jop-devel/jop/README

JOP stands for Java Optimized Processor. JOP is a Java processor
intended for embedded real-time systems.
