jop-devel/jop/java/target/src/bench/scd_micro/README.txt

The code here is taken from the CDx - RTSJ benchmark.
http://adam.lille.inria.fr/soleil/rcd/Download/

Basically, it is the code periodically invoked in the real-time thread to perform collision detection,
see Main.java
