jop-devel/jop/doc/book/appendix/boards.tex

\index{schematics}

This chapter provides the schematics of the Cycore FPGA boards and
several I/O extension boards.

\newpage
\section{Cyclone FPGA Board} \label{appx:cycore}

\begin{figure}[h!]
    \centering
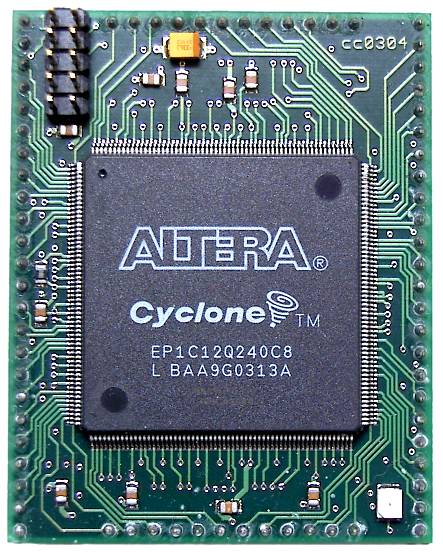
[picture p1: doc/book/appendix/cycore_top.jpg]
    
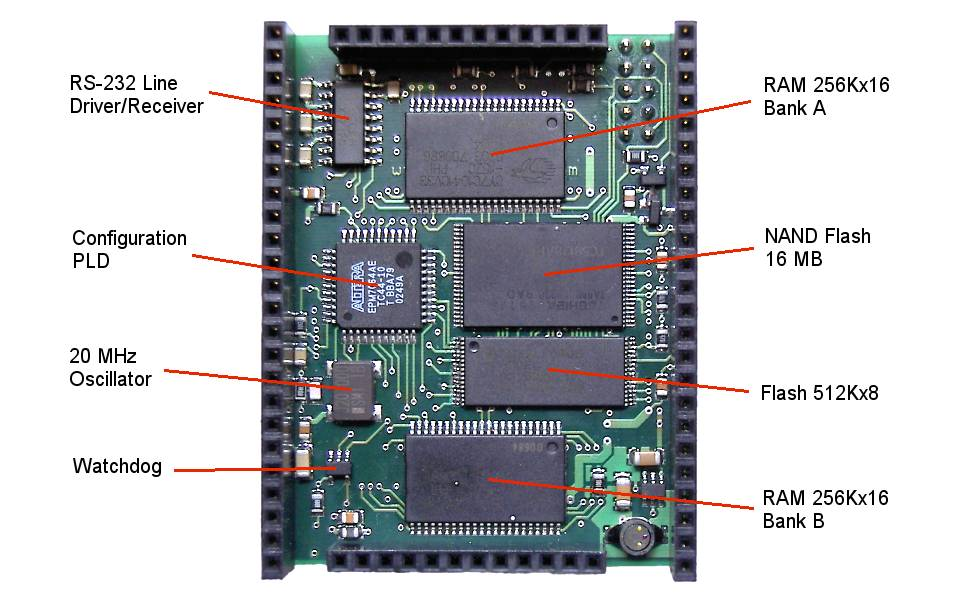
[picture p2: doc/book/appendix/cycore_bottom.jpg]
    
    \caption{Top and bottom side of the Cyclone FPGA board}
\end{figure}

\begin{figure}
    \centering
    
    \caption{Schematic of the Cyclone FPGA board, page 1}
\end{figure}
\begin{figure}
    \centering
    
    \caption{Schematic of the Cyclone FPGA board, page 2}
\end{figure}
\begin{figure}
    \centering
    
    \caption{Schematic of the Cyclone FPGA board, page 3}
\end{figure}

\newpage
\section{Baseio Board} \label{appx:baseio}
\index{Baseio}

\begin{figure}[h]
    \centering
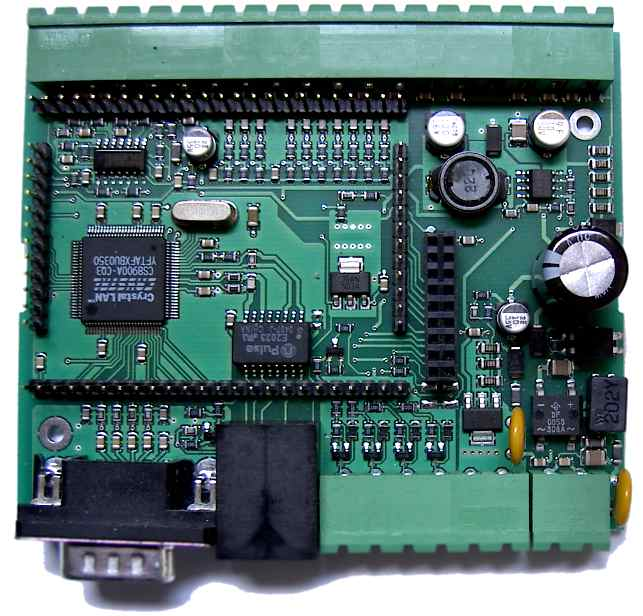
[picture p3: doc/book/appendix/baseio_large.jpg]
    
    \caption{The Baseio extension board}
\end{figure}
\begin{figure}
    \centering
    
    \caption{Schematic of the Baseio extension board, page 1}
\end{figure}
\begin{figure}
    \centering
    
    \caption{Schematic of the Baseio extension board, page 2}
\end{figure}
\begin{figure}
    \centering
    
    \caption{Schematic of the Baseio extension board, page 3}
\end{figure}
\begin{figure}
    \centering
    
    \caption{Schematic of the Baseio extension board, page 4}
\end{figure}

\newpage
\section{Dspio Board} \label{appx:dspio}
\index{Dspio}

\begin{figure}[h]
    \centering
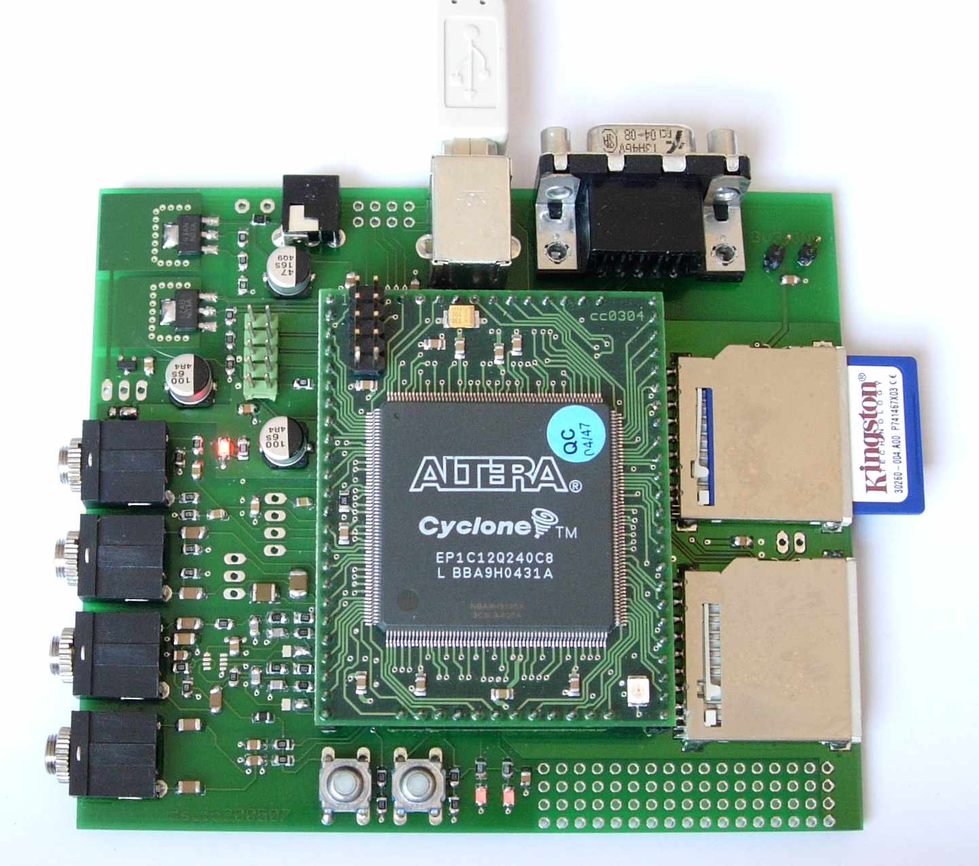
[picture p4: doc/book/appendix/dspio.jpg]
    
    \caption{The dspio extension board}
\end{figure}
\begin{figure}
    \centering
    
    \caption{Schematic of the dspio extension board, page 1}
\end{figure}
\begin{figure}
    \centering
    
    \caption{Schematic of the dspio extension board, page 2}
\end{figure}
\begin{figure}
    \centering
    
    \caption{Schematic of the dspio extension board, page 3}
\end{figure}
\begin{figure}
    \centering
    
    \caption{Schematic of the dspio extension board, page 4}
\end{figure}
\begin{figure}
    \centering
    
    \caption{Schematic of the dspio extension board, page 5}
\end{figure}

\newpage
\section{Simpexp Board} \label{appx:simpexp}

\begin{figure}[h]
    \centering
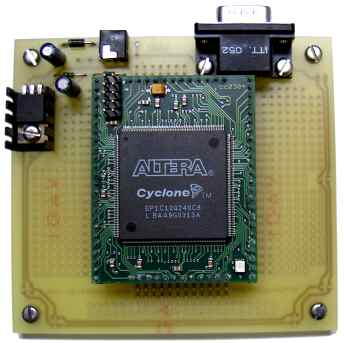
[picture p5: doc/book/appendix/simpexp.jpg]
    
    \caption{The simpexp extension board}
\end{figure}
\begin{figure}
    \centering
    
    \caption{Schematic of the simpexp extension board}
\end{figure}
