jop-devel/jop/doc/book/jvm/boot.tex

\subsection{Booting the JVM}

\index{JVM!boot-up}

One interesting issue for an embedded system is how the boot-up is
performed. On power-up, the FPGA starts the configuration state
machine to read the FPGA configuration data either from a Flash or
via a download cable (for development). When the configuration has
finished, an internal reset is generated. After that reset, microcode
instructions are executed starting from address 0. At this stage, we
have not yet loaded any application program (Java bytecode). The
first sequence in microcode performs this task. The Java application
can be loaded from an external Flash or via a serial line (or an USB
port) from a PC. The microcode assembly configured the mode.
Consequently, the Java application is loaded into the main memory. To
simplify the startup code we perform the rest of the startup in Java
itself, even when some parts of the JVM are not yet setup.

In the next step, a minimal stack frame is generated and the special
method \code{Startup.boot()} is invoked. From now on JOP runs in
Java mode. The method \code{boot()} performs the following steps:
\begin{samepage}
\begin{enumerate}
    \item Send a greeting message to \emph{stdout}
    \item Detect the size of the main memory
    \item Initialize the data structures for the garbage collector
    \item Initialize \code{java.lang.System}
    \item Print out JOP's version number, detected clock speed, and
    memory size
    \item Invoke the static class initializers in a predefined order
    \item Invoke the \code{main} method of the application class
\end{enumerate}
\end{samepage}
