jop-devel/jop/doc/book/appendix/acronyms.tex

\newcommand{\gloss}[3]{
    \textbf{#1} & #2\\
%    \item[#1] {#2}\\{#3}
%    \textbf{#1} & #2\\ & \mbox{#3}\\
%    \textbf{#1} \> \> #2\\ \> \parbox{10cm}{#3}\\ \\
}
\begin{longtable}[l]{ll}
%    abc\=WCET\= \kill % for tabbing
    \gloss{ADC}{Analog to Digital Converter}{}
    \gloss{ALU}{Arithmetic and Logic Unit}{The part of a processor that performs
    arithmetic, logical, and related operations.}
    \gloss{ASIC}{Application-Specific Integrated Circuit}{}
    \gloss{BCET}{Best Case Execution Time}{}
    \gloss{CFG}{Control Flow Graph}{}
    \gloss{CISC}{Complex Instruction Set Computer}{}
    \gloss{CLDC}{Connected Limited Device Configuration}{}
    \gloss{CPI}{average Clock cycles Per Instruction}{}
    \gloss{CRC}{Cyclic Redundancy Check}{}
    \gloss{DMA}{Direct Memory Access}{}
    \gloss{DRAM}{Dynamic Random Access Memory}{}
    \gloss{EDF}{Earliest Deadline First}{}
    \gloss{EMC}{Electromagnetic Compatibility}{}
    \gloss{ESD}{Electrostatic Discharge}{}
    \gloss{FIFO}{Fist In, First Out}{}
    \gloss{FPGA}{Field Programmable Gate Array}{FPGAs are a class of programmable
    logic devices. They contain a matrix of
    LCs, embedded memory blocks, and sophisticated I/O cells.}
    \gloss{GC}{Garbage Collect(ion/or)}{}
    \gloss{IC}{Instruction Count}{}
    \gloss{ILP}{Instruction Level Parallelism}{}
    \gloss{JOP}{Java Optimized Processor}{A processor that implements the JVM
    in hardware with architectural features for time-predictable execution of
    Java applications for real-time systems.}
    \gloss{J2ME}{Java2 Micro Edition}{}
    \gloss{J2SE}{Java2 Standard Edition}{}
    \gloss{JDK}{Java Development Kit}{}
    \gloss{JIT}{Just-In-Time}{}
    \gloss{JVM}{Java Virtual Machine}{}
    \gloss{LC}{Logic Cell}{The basic element in an FPGA: a 4-bit lookup table with
a register.}
    \gloss{LRU}{Least-Recently Used}{}
    \gloss{MBIB}{Memory Bytes read per Instruction Byte}{}
    \gloss{MCIB}{Memory Cycles per Instruction Byte}{}
    \gloss{MP}{Miss Penalty}{}
    \gloss{MTIB}{Memory Transactions per Instruction Byte}{}
    \gloss{MUX}{Multiplexer}{}
    \gloss{OO}{Object Oriented}{}
    \gloss{OS}{Operating System}{}
    \gloss{RISC}{Reduced Instruction Set Computer}{}
    \gloss{RT}{Real-Time}{}
    \gloss{RTOS}{Real-Time Operating System}{}
    \gloss{RTSJ}{Real-Time Specification for Java}{}
    \gloss{SCADA}{Supervisory Control And Data Acquisition}{}
    \gloss{SDRAM}{Synchronous DRAM}{}
    \gloss{SRAM}{Static Random Access Memory}{}
    \gloss{TOS}{Top Of Stack}{}
    \gloss{UART}{Universal Asynchronous Receiver/Transmitter}{}
    \gloss{VHDL}{Very High Speed Integrated Circuit (VHSIC)}{}
    \gloss{}{Hardware Description Language}{}
    \gloss{WCET}{Worst-Case Execution Time}{}
%    \gloss{xxx}{yyy}{}
%    \gloss{xxx}{yyy}{}
%    \gloss{xxx}{yyy}{}
\end{longtable}
