jop-devel/jop/doc/book/stack/stack_invocation.pdf

var_2
var_1
var_0

Operand stack

arg_2
arg_1
arg_0

var_2
var_1
var_0

Context of
Caller

Operand stack

var_3
var_2
var_1
var_0

Context of
Caller

VP

SP

VP

Old frame

SP

Context of
Caller

Operand stack
