jop-devel/jop/doc/book/arch/arch_indirection.pdf

### Java bytecode

### Jump

table | JOP microcode

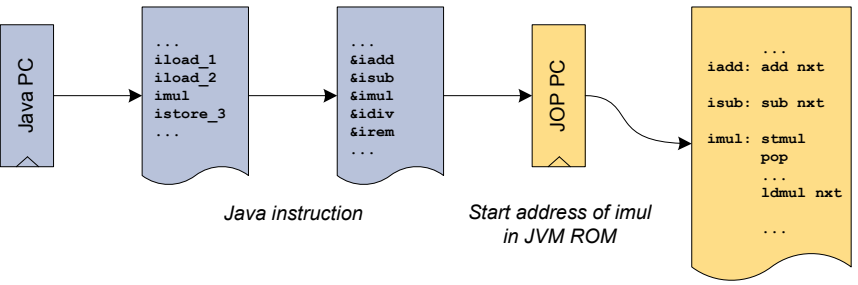
[picture p6: figure]
Java PC; JOP PC; ... iload_1 iload_2 imul istore_3 ...; ... iadd: add nxt; isub: sub nxt; imul: stmul pop ... ldmul nxt; ... &iadd &isub &imul &idiv &irem ...; Java instruction; Start address of imul; in JVM ROM
