jop-devel/jop/doc/book/jvm/jvm_class.pdf

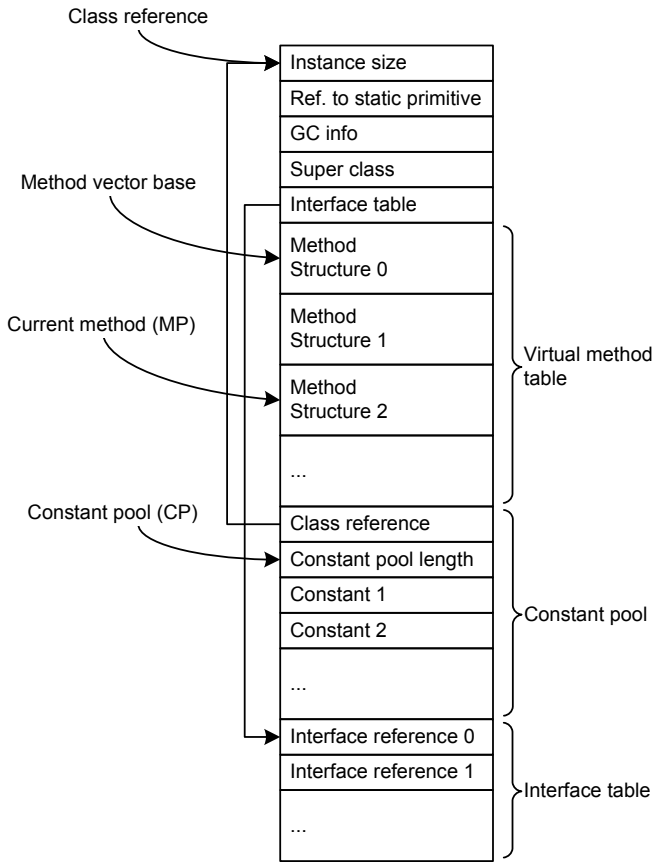
[picture p7: figure]
Constant pool length; Instance size; Ref. to static primitive; GC info; Super class; Interface table; Method Structure 0; Class reference; Interface reference 0; Method Structure 1; Method Structure 2; Constant 1; Constant 2; Interface reference 1; Virtual method table; Constant pool; Method vector base; Current method (MP); Constant pool (CP)
