jop-devel/jop/doc/book/jvm/jvm_stack_invocation.pdf

var_0
var_1
var_2
Previous SP

Previous MP

Previous CP

Previous VP

Previous PC

Operand stack

arg_0
arg_1

var_0
var_1
var_2
Previous SP

Previous MP

Previous CP

Previous VP

Previous PC

Operand stack

var_0
var_1
var_2
var_3

Previous SP

Previous MP

Previous CP

Previous VP

Previous PC

VP

SP

VP

Frame

SP

Old frame
