jop-devel/jop/doc/book/related/related_picojava.pdf

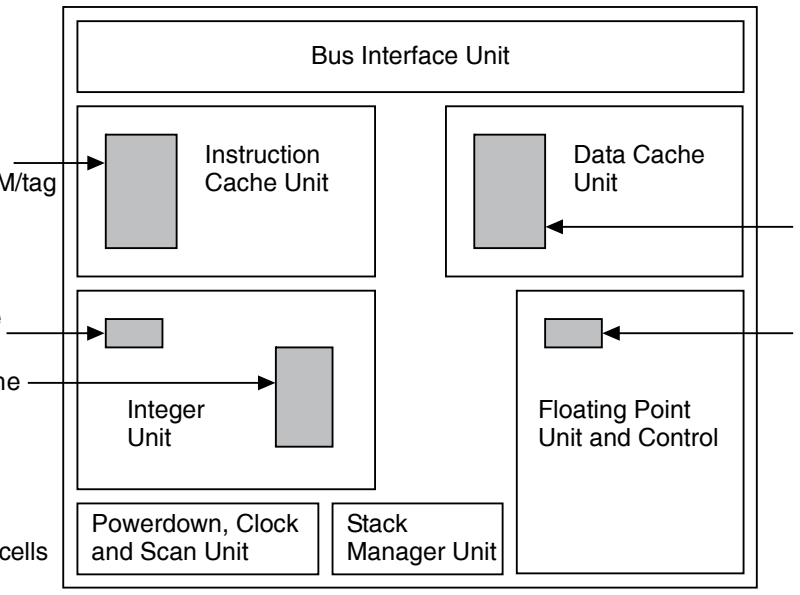
[picture p8: figure]
Instruction Cache Unit; Data Cache Unit; Integer Unit; Powerdown, Clock and Scan Unit; Stack Manager Unit; Floating Point Unit and Control; Bus Interface Unit

Instruction
cache RAM/tag

Microcode
ROM
Stack cache

Data cache
RAM/tag

Megacells

Memory and I/O interface

Floatingpoint ROM

Processor Interface
