jop-devel/jop/doc/book/runtime/rt_user_interaction.pdf

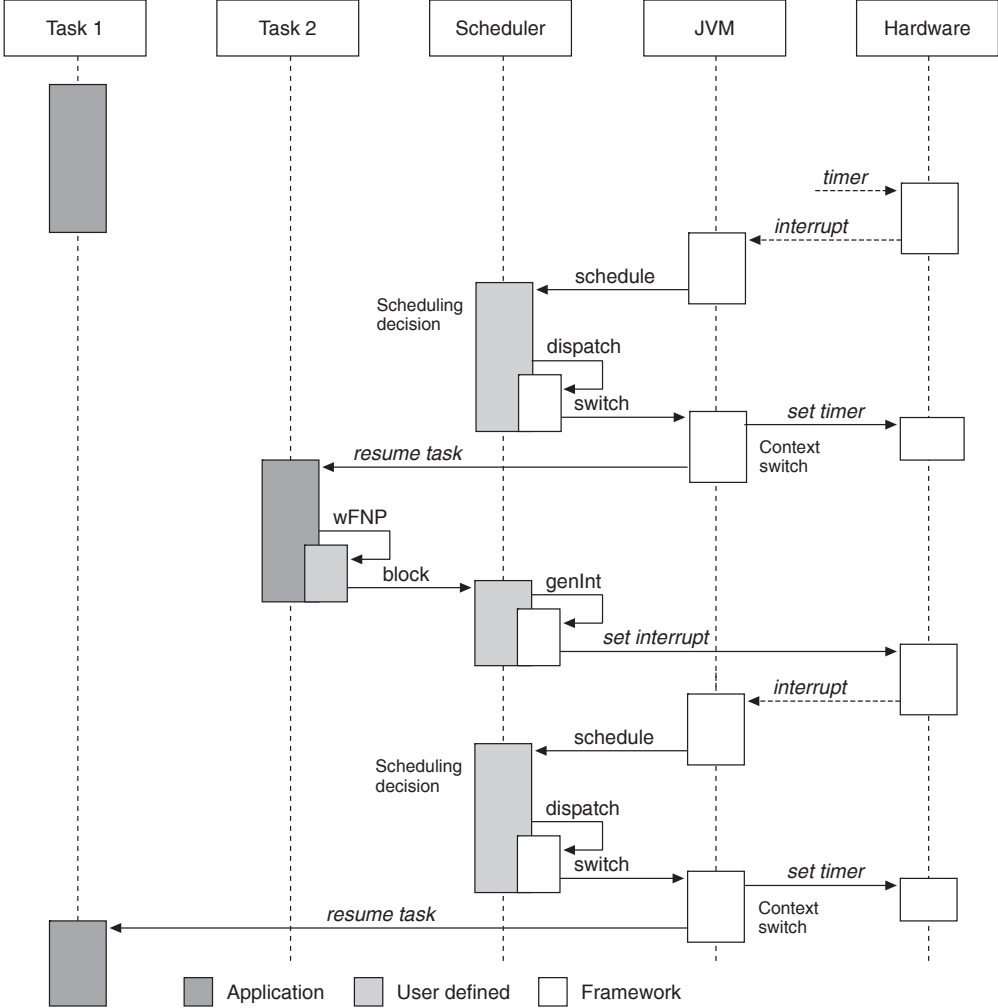
[picture p9: figure]
Task 1; Task 2; Scheduler; JVM; Hardware; block; genInt; set interrupt; interrupt; schedule; dispatch; switch; resume task; Scheduling decision; Context switch; wFNP; timer; Application; User defined; Framework; set timer
