jop-devel/jop/doc/pins.txt

--
--	pins for jop an acex board for BB project
--
--		con A memory
--		con B display and keyboard
--		con D serial
--		con C LEDs
--
--
	DEVICE = ep1k50tc144-3;
	|lpt_d0 :	BIDIR_PIN = 14;
	|lpt_d1 :	BIDIR_PIN = 17;
	|lpt_d2 :	BIDIR_PIN = 18;
	|lpt_d3 :	BIDIR_PIN = 19;
	|lpt_d4 :	BIDIR_PIN = 20;
	|lpt_d5 :	BIDIR_PIN = 21;
	|lpt_d6 :	BIDIR_PIN = 22;
	|lpt_d7 :	BIDIR_PIN = 23;
	|clk :	INPUT_PIN = 55;
	|reset :	INPUT_PIN = 56;
	|txd :	OUTPUT_PIN = 59;
	|rxd :	INPUT_PIN = 60;
	|rts :	OUTPUT_PIN = 62;
	|cts :	INPUT_PIN = 63;
	|a18 :	OUTPUT_PIN = 12;
	|nrom_cs :	OUTPUT_PIN = 11;
	|a16 :	OUTPUT_PIN = 10;
	|a15 :	OUTPUT_PIN = 9;
	|a14 :	OUTPUT_PIN = 8;
	|a17 :	OUTPUT_PIN = 7;
	|a12 :	OUTPUT_PIN = 144;
	|nwr :	OUTPUT_PIN = 143;
	|a7 :	OUTPUT_PIN = 142;
	|a13 :	OUTPUT_PIN = 141;
	|a6 :	OUTPUT_PIN = 140;
	|a8 :	OUTPUT_PIN = 138;
	|a5 :	OUTPUT_PIN = 137;
	|a9 :	OUTPUT_PIN = 136;
	|a4 :	OUTPUT_PIN = 135;
	|a11 :	OUTPUT_PIN = 133;
	|a3 :	OUTPUT_PIN = 132;
	|nrd :	OUTPUT_PIN = 131;
	|a2 :	OUTPUT_PIN = 130;
	|a10 :	OUTPUT_PIN = 128;
	|a1 :	OUTPUT_PIN = 121;
	|nram_cs :	OUTPUT_PIN = 120;
	|a0 :	OUTPUT_PIN = 119;
	|d7 :	BIDIR_PIN = 118;
	|d0 :	BIDIR_PIN = 117;
	|d6 :	BIDIR_PIN = 116;
	|d1 :	BIDIR_PIN = 114;
	|d5 :	BIDIR_PIN = 113;
	|d2 :	BIDIR_PIN = 112;
	|d4 :	BIDIR_PIN = 111;
	|max_oe :	OUTPUT_PIN = 110;
	|d3 :	BIDIR_PIN = 109;
	|lpt_c1 :	INPUT_PIN = 27;
	|lpt_c2 :	INPUT_PIN = 28;
	|lpt_c3 :	INPUT_PIN = 29;
	|lpt_s7 :	OUTPUT_PIN = 36;
	|lpt_s6 :	OUTPUT_PIN = 33;
	|lpt_s5 :	OUTPUT_PIN = 32;
	|lpt_s4 :	OUTPUT_PIN = 31;
	|lpt_c0 :	INPUT_PIN = 26;
	|lpt_s3 :	OUTPUT_PIN = 30;
--
--	keyboard
--
	|key_in0 :	INPUT_PIN = 78;
	|key_in1 :	INPUT_PIN = 79;
	|key_in2 :	INPUT_PIN = 80;
	|key_in3 :	INPUT_PIN = 81;
	|key_out0 :	OUTPUT_PIN = 82;
	|key_out1 :	OUTPUT_PIN = 83;
	|key_out2 :	OUTPUT_PIN = 86;
	|key_out3 :	OUTPUT_PIN = 87;
--
--	display
--
	|disp_rs :	OUTPUT_PIN = 88;
	|disp_nwr :	OUTPUT_PIN = 89;
	|disp_e :	OUTPUT_PIN = 90;
	|disp_d4 :	OUTPUT_PIN = 91;
	|disp_d5 :	OUTPUT_PIN = 92;
	|disp_d6 :	OUTPUT_PIN = 95;
	|disp_d7 :	OUTPUT_PIN = 96;
--
--	outp not used
--
--	|outp0 :	OUTPUT_PIN = 37;
--	|outp1 :	OUTPUT_PIN = 38;
--	|outp2 :	OUTPUT_PIN = 39;
--	|outp3 :	OUTPUT_PIN = 41;
--	|outp4 :	OUTPUT_PIN = 42;
--	|outp5 :	OUTPUT_PIN = 43;
--	|outp6 :	OUTPUT_PIN = 44;
--	|outp7 :	OUTPUT_PIN = 46;
--	|outp8 :	OUTPUT_PIN = 47;
--	|outp9 :	OUTPUT_PIN = 48;
--	|outp10 :	OUTPUT_PIN = 49;
--	|outp11 :	OUTPUT_PIN = 51;
--
--	triac now only for test
--
	|p1_auf_ab :	OUTPUT_PIN = 64;
	|p2_auf :	OUTPUT_PIN = 65;
	|p3_auf :	OUTPUT_PIN = 67;
	|p2_ab :	OUTPUT_PIN = 68;
	|p3_ab :	OUTPUT_PIN = 69;

	|p1_u :		INPUT_PIN = 38;
	|p2_u :		INPUT_PIN = 41;
	|p3_u :		INPUT_PIN = 43;
	|p1_i :		INPUT_PIN = 46;
	|p2_i :		INPUT_PIN = 48;
	|p3_i :		INPUT_PIN = 49;
--
--	motor sensor
--
	|sens_i :		INPUT_PIN = 70;
	|sens_o :		INPUT_PIN = 72;
	|sens_u :		INPUT_PIN = 73;

	|ab_t :	INPUT_PIN = 102;
	|auf_t :	INPUT_PIN = 101;
	|not_stop :	INPUT_PIN = 100;
	|tuer :	INPUT_PIN = 99;

	|wd :	OUTPUT_PIN = 37;
	|led1 :	OUTPUT_PIN = 39;
	|led2 :	OUTPUT_PIN = 42;
	|led3 :	OUTPUT_PIN = 44;
	|led4 :	OUTPUT_PIN = 47;
--
--	dummy fuer ext conn
--
	|exp0 :	OUTPUT_PIN = 88;
	|exp1 :	OUTPUT_PIN = 87;
	|exp2 :	OUTPUT_PIN = 86;
	|exp3 :	OUTPUT_PIN = 83;
	|exp4 :	OUTPUT_PIN = 82;
	|exp5 :	OUTPUT_PIN = 81;
	|exp6 :	OUTPUT_PIN = 80;
	|exp7 :	OUTPUT_PIN = 79;
	|exp8 :	OUTPUT_PIN = 78;
	|exp9 :	OUTPUT_PIN = 73;
	|exp10 :	OUTPUT_PIN = 72;
	|exp11 :	OUTPUT_PIN = 70;

--
--	pins for jopcore (2002/05)
--		and jopeth with baseio
--
	DEVICE = ep1k50tc144-3;
	|clk :	INPUT_PIN = 55;
	|reset :	INPUT_PIN = 56;
	|a18 :	OUTPUT_PIN = 44;
	|a17 :	OUTPUT_PIN = 47;
	|a16 :	OUTPUT_PIN = 62;
	|a15 :	OUTPUT_PIN = 42;
	|a14 :	OUTPUT_PIN = 48;
	|a13 :	OUTPUT_PIN = 60;
	|a12 :	OUTPUT_PIN = 65;
	|a11 :	OUTPUT_PIN = 51;
	|a10 :	OUTPUT_PIN = 130;
	|a9 :	OUTPUT_PIN = 59;
	|a8 :	OUTPUT_PIN = 49;
	|a7 :	OUTPUT_PIN = 69;
	|a6 :	OUTPUT_PIN = 70;
	|a5 :	OUTPUT_PIN = 38;
	|a4 :	OUTPUT_PIN = 72;
	|a3 :	OUTPUT_PIN = 140;
	|a2 :	OUTPUT_PIN = 120;
	|a1 :	OUTPUT_PIN = 138;
	|a0 :	OUTPUT_PIN = 121;
	|ram_ax :	OUTPUT_PIN = 67;
	|nram_cs :	OUTPUT_PIN = 117;
	|nrom_cs :	OUTPUT_PIN = 131;
	|nmem_rd :	OUTPUT_PIN = 128;
	|nmem_wr :	OUTPUT_PIN = 46;
	|wd :	OUTPUT_PIN = 43;
	|d7 :	BIDIR_PIN = 116;
	|d6 :	BIDIR_PIN = 114;
	|d5 :	BIDIR_PIN = 113;
	|d4 :	BIDIR_PIN = 112;
	|d3 :	BIDIR_PIN = 111;
	|d2 :	BIDIR_PIN = 110;
	|d1 :	BIDIR_PIN = 109;
	|d0 :	BIDIR_PIN = 118;
--
--	uart
--
	|txd :	OUTPUT_PIN = 133;
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
	|r10 :	OUTPUT_PIN = 91;
	|r11 :	OUTPUT_PIN = 90;
	|r12 :	OUTPUT_PIN = 89;
	|r13 :	OUTPUT_PIN = 88;
	|r14 :	OUTPUT_PIN = 87;
	|r15 :	OUTPUT_PIN = 86;
	|r16 :	OUTPUT_PIN = 83;
	|r17 :	OUTPUT_PIN = 82;
	|r18 :	OUTPUT_PIN = 81;
	|r19 :	OUTPUT_PIN = 80;
	|r20 :	OUTPUT_PIN = 79;
