jop-devel/jop/doc/book/classes/jdoc_preamble.tex

\def\bl{\mbox{}\newline\mbox{}\newline{}}
\usepackage{ifthen}
\newcommand{\hide}[2]{
\ifthenelse{\equal{#1}{inherited}}%
{}%
{}%
}
\newcommand{\entityintro}[3]{%
  \hbox to \hsize{%
    \vbox{%
      \hbox to .2in{}%
    }%
    {\bf #1}%
    \dotfill\pageref{#2}%
  }
  \makebox[\hsize]{%
    \parbox{.4in}{}%
    \parbox[l]{5in}{%
      \vspace{1mm}\it%
      #3%
      \vspace{1mm}%
    }%
  }%
}
\newcommand{\isep}[0]{%
\setlength{\itemsep}{-.4ex}
}
\newcommand{\sld}[0]{%
\setlength{\topsep}{0em}
\setlength{\partopsep}{0em}
\setlength{\parskip}{0em}
\setlength{\parsep}{-1em}
}
\newcommand{\headref}[3]{%
\ifthenelse{#1 = 1}{%
\addcontentsline{toc}{section}{\hspace{\qquad}\protect\numberline{}{#3}}%
}{}%
\ifthenelse{#1 = 2}{%
\addcontentsline{toc}{subsection}{\hspace{\qquad}\protect\numerline{}{#3}}%
}{}%
\ifthenelse{#1 = 3}{%
\addcontentsline{toc}{subsubsection}{\hspace{\qquad}\protect\numerline{}{#3}}%
}{}%
\label{#3}%
\makebox[\textwidth][l]{#2 #3}%
}%
\newcommand{\membername}[1]{{\it #1}\linebreak}
\newcommand{\divideents}[1]{\vskip -1em\indent\rule{2in}{.2mm}}
\newcommand{\refdefined}[1]{
\expandafter\ifx\csname r@#1\endcsname\relax
\relax\else
{$($ in \ref{#1}, page \pageref{#1}$)$}
\fi}
\newcommand{\startsection}[4]{
\gdef\classname{#2}
\subsection{\label{#3}{\bf {\sc #1} #2}}{
\rule[1em]{\hsize}{1.5pt}\vskip -1em \vskip .1in #4
}%
}
\newcommand{\startsubsubsection}[2]{
\subsubsection{\sc #1}{%
\rule[1em]{\hsize}{1pt}%
#2}
}
\usepackage{color}
\addtocontents{toc}{\protect\def\protect\packagename{}}
\addtocontents{toc}{\protect\def\protect\classname{}}
\markboth{\protect\packagename --
\protect\classname}{\protect\packagename -- \protect\classname}
% \topmargin -.8in
\chardef\bslash=`\\
