jop-devel/jop/doc/book/arch/arch_pipeline.pdf

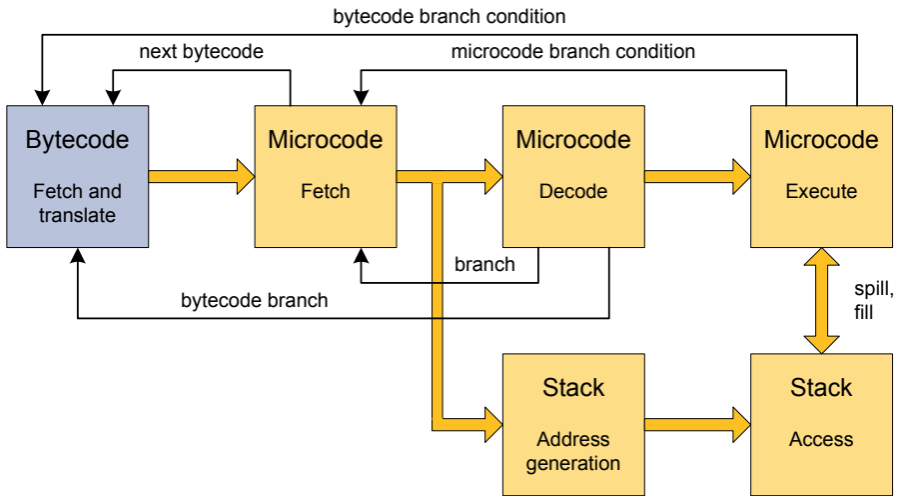
[picture p12: figure]
Bytecode; Fetch and translate; Microcode; Fetch; Decode; Execute; Stack; Address generation; Access; next bytecode; bytecode branch condition; microcode branch condition; branch; bytecode branch; spill,; fill
