jop-devel/jop/doc/book/simpcon/sc_basic_rd.pdf

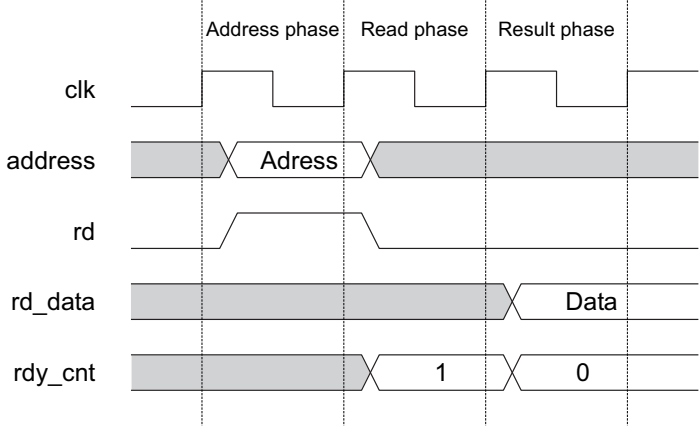
[picture p13: figure]
Address phase; Read phase; Result phase; Adress; Data; clk; address; rd_data; rdy_cnt
