jop-devel/jop/doc/book/simpcon/sc_rd_ws.pdf

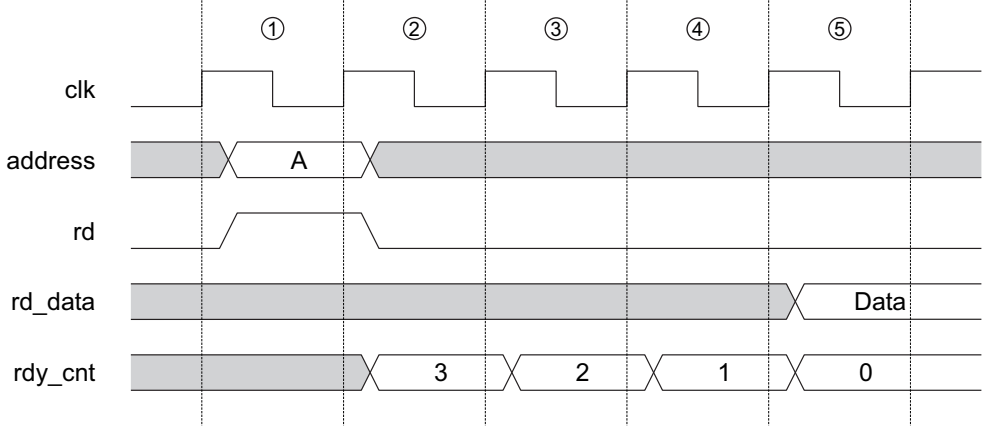
[picture p14: figure]
Data; clk; address; rd_data; rdy_cnt
