jop-devel/jop/doc/book/simpcon/sc_wait_states.pdf

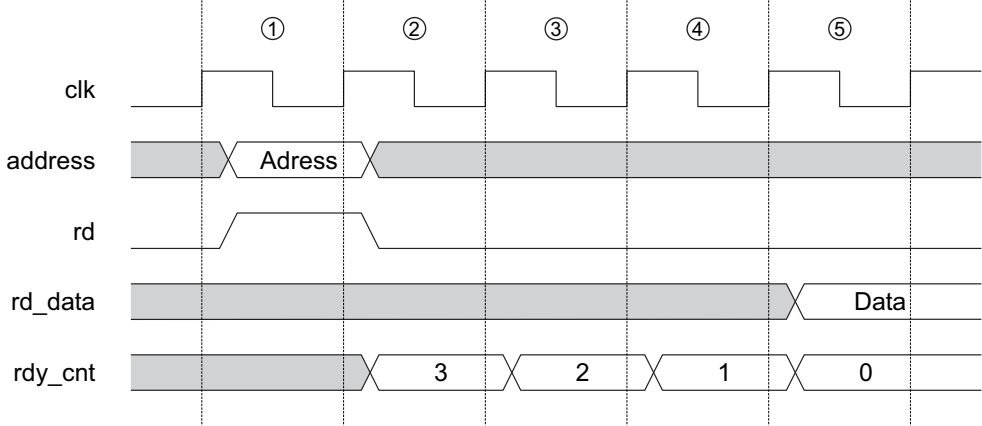
[picture p15: figure]
Adress; Data; clk; address; rd_data; rdy_cnt
