jop-devel/jop/doc/book/simpcon/sc_wr_ws.pdf

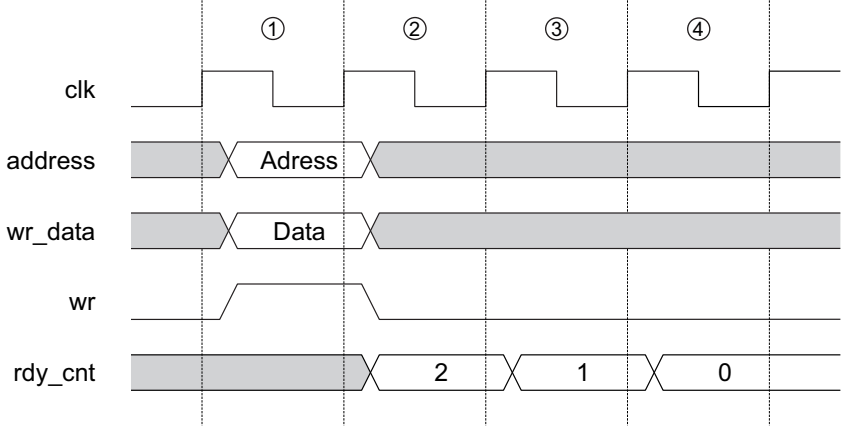
[picture p16: figure]
Adress; clk; address; wr_data; rdy_cnt; Data
