jop-devel/jop/doc/book/io/uml.pdf

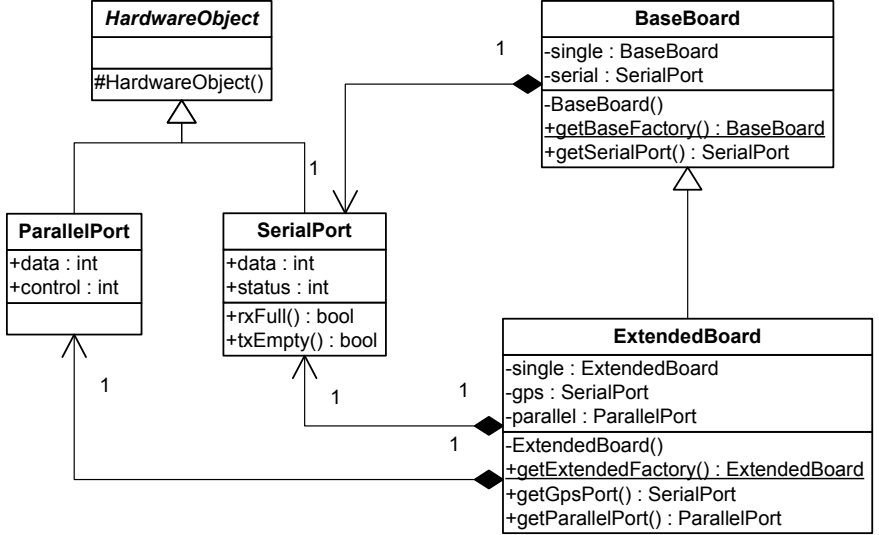
[picture p17: figure]
#HardwareObject(); HardwareObject; -BaseBoard() +getBaseFactory() : BaseBoard +getSerialPort() : SerialPort; -single : BaseBoard -serial : SerialPort; BaseBoard; +rxFull() : bool +txEmpty() : bool; ParallelPort; SerialPort; -ExtendedBoard() +getExtendedFactory() : ExtendedBoard +getGpsPort() : SerialPort +getParallelPort() : ParallelPort; -single : ExtendedBoard -gps : SerialPort -parallel : ParallelPort; ExtendedBoard

+data : int +control : int | +data : int +status : int
