jop-devel/jop/doc/book/wcet/cache_bb.pdf

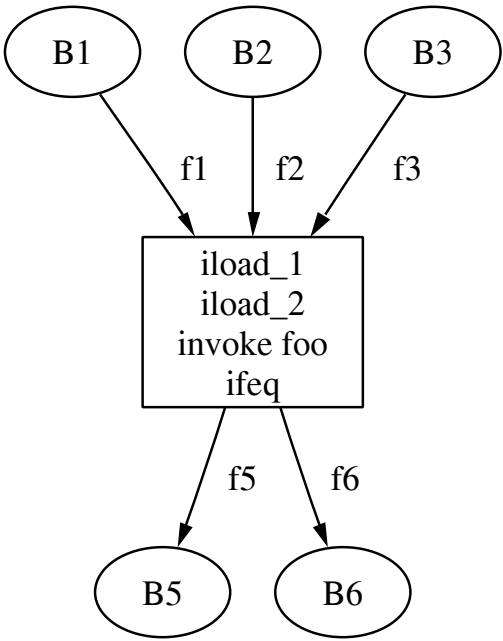
[picture p18: figure]
iload_1 iload_2 invoke foo ifeq
