jop-devel/jop/doc/book/wcet/dispatch_split.pdf

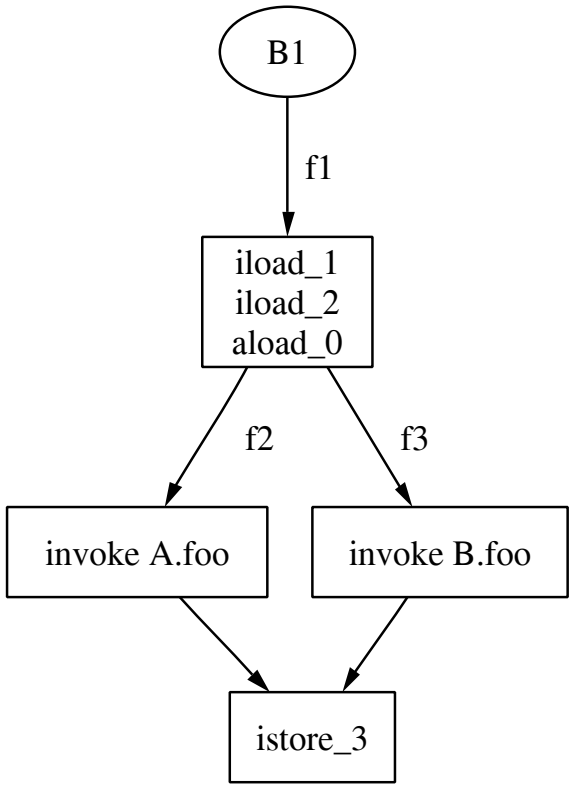
[picture p19: figure]
iload_1 iload_2 aload_0; invoke A.foo; invoke B.foo; istore_3
