jop-devel/jop/doc/book/intro/jvmall.pdf

Hardware
Java processor (JVM)

Library (JDK)

CPU | Memory | Ethernet

java.net

TCP/IP

Ethernet

Java application | Web server

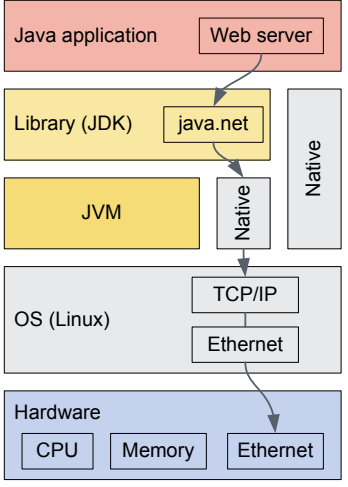
[picture p20: figure]
Hardware; OS (Linux); JVM; Native; Library (JDK); CPU; Memory; Ethernet; java.net; TCP/IP; Java application; Web server
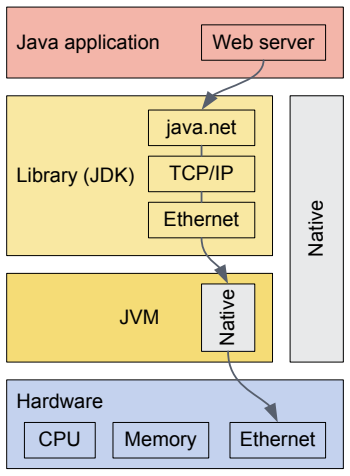
[picture p21: figure]
Hardware; JVM; Native; Library (JDK); CPU; Memory; Ethernet; java.net; TCP/IP; Java application; Web server

(a) | (b) | (c)
