jop-devel/jop/doc/ext/jvmtest/classdiag.png

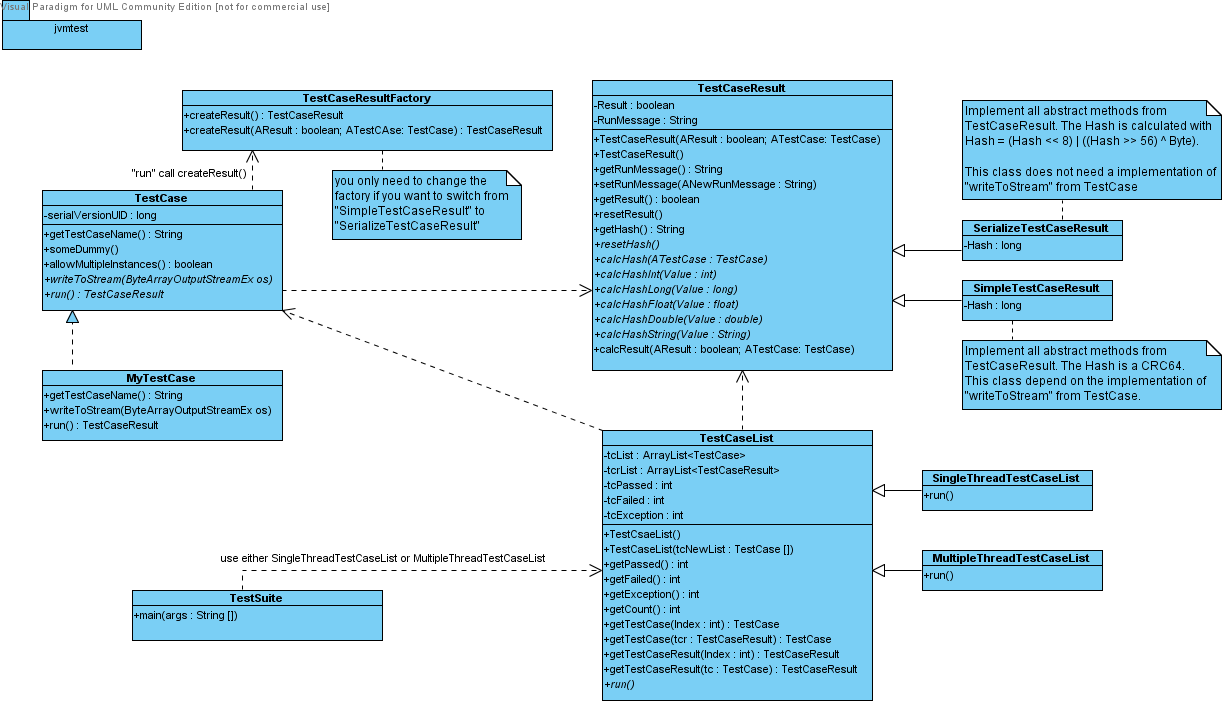
doc/ext/jvmtest/classdiag.png
