jop-devel/jop/doc/perf-trend.png

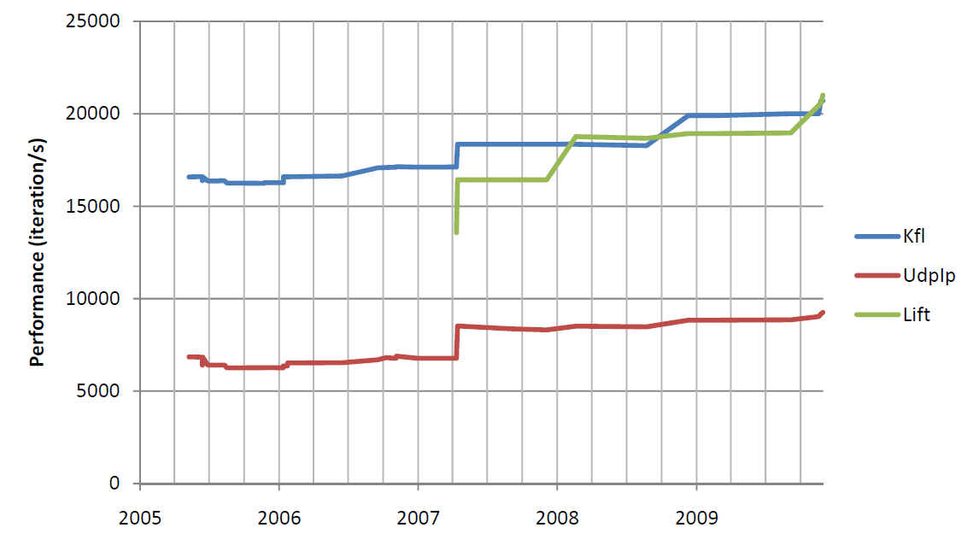
doc/perf-trend.png
