jop-devel/jop/doc/size-trend.png

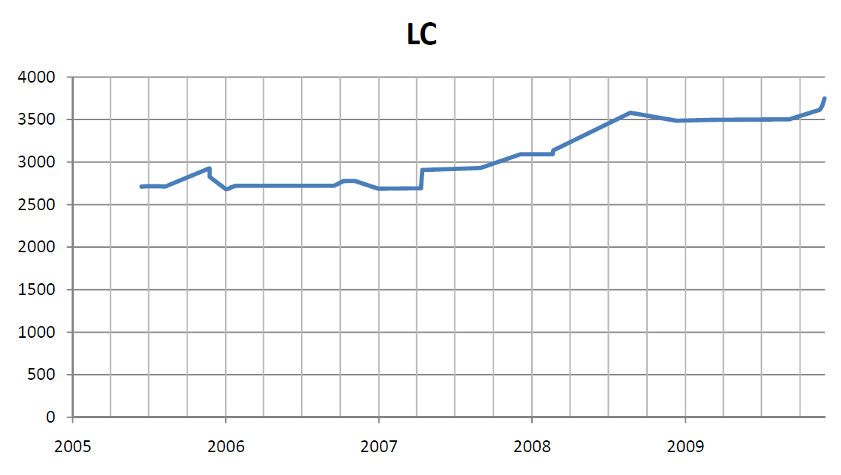
doc/size-trend.png
