jop-devel/jop/doc/book/results/results_sigdel.pdf

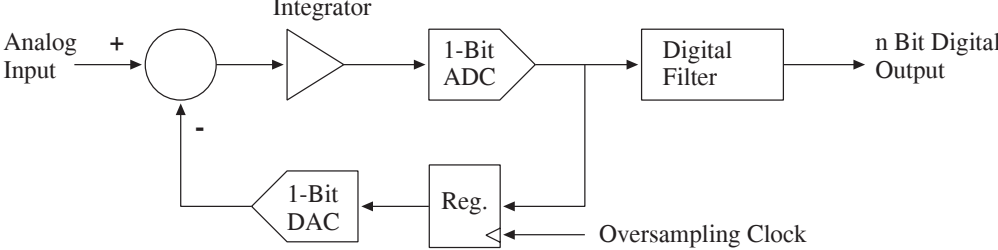
[picture p27: figure]
Reg. 1-Bit DAC; 1-Bit ADC; Digital Filter; Integrator; Analog Input; n Bit Digita; Output; Oversampling Clock
