jop-devel/jop/doc/book/results/bubble.tex

B1 &      &                 &  2 &  1 &   2 &  1 &   2 \\
   & 0:   &  iconst\_4      &  1 &    &     \\
   & 1:   &  istore\_1      &  1 &    &     \\
B2 &      &                 &  5 &  5 &  25 &  5 &  25 \\
   & 2:   &  iload\_1       &  1 &    &     \\
   & 3:   &  ifle 53        &  4 &    &     \\
B3 &      &                 &  2 &  4 &   8 &  4 &   8 \\
   & 6:   &  iconst\_1      &  1 &    &     \\
   & 7:   &  istore\_2      &  1 &    &     \\
B4 &      &                 &  6 & 14 &  84 & 14 &  84 \\
   & 8:   &  iload\_2       &  1 &    &     \\
   & 9:   &  iload\_1       &  1 &    &     \\
   & 10:  &  if\_icmpgt 47  &  4 &    &     \\
B5 &      &                 & 74 & 10 & 740 & 10 & 740 \\
   & 13:  &  aload\_0       &  1 &    &     \\
   & 14:  &  iload\_2       &  1 &    &     \\
   & 15:  &  iconst\_1      &  1 &    &     \\
   & 16:  &  isub           &  1 &    &     \\
   & 17:  &  iaload         & 29 &    &     \\
   & 18:  &  istore\_3      &  1 &    &     \\
   & 19:  &  aload\_0       &  1 &    &     \\
   & 20:  &  iload\_2       &  1 &    &     \\
   & 21:  &  iaload         & 29 &    &     \\
   & 22:  &  istore 4       &  2 &    &     \\
   & 24:  &  iload\_3       &  1 &    &     \\
   & 25:  &  iload 4        &  2 &    &     \\
   & 27:  &  if\_icmple 41  &  4 &    &     \\
B6 &      &                 & 73 & 10 & 730 &  0 &   0 \\
   & 30:  &  aload\_0       &  1 &    &     \\
   & 31:  &  iload\_2       &  1 &    &     \\
   & 32:  &  iload\_3       &  1 &    &     \\
   & 33:  &  iastore        & 32 &    &     \\
   & 34:  &  aload\_0       &  1 &    &     \\
   & 35:  &  iload\_2       &  1 &    &     \\
   & 36:  &  iconst\_1      &  1 &    &     \\
   & 37:  &  isub           &  1 &    &     \\
   & 38:  &  iload 4        &  2 &    &     \\
   & 40:  &  iastore        & 32  &    &     \\
B7 &      &                 & 15 & 10 & 150 & 10 & 150 \\
   & 41:  &  iinc 2, 1      & 11 &    &     \\
   & 44:  &  goto 8         &  4 &    &     \\
B8 &      &                 & 15 &  4 &  60 &  4 &  60 \\
   & 47:  &  iinc 1, -1     & 11 &    &     \\
   & 50:  &  goto 2         &  4 &    &     \\
B9 &      &                 &    &  1 &     &  1 &     \\
   & 53:  &  return         &    &    &     \\
\midrule
\multicolumn{4}{l}{Execution time calculated} & & 1,799  &    & 1,069 \\
\multicolumn{4}{l}{Execution time measured}   & & 1,799  &    & 1,069 \\
