jop-devel/jop/doc/book/results/results_kfl_mast1.pdf

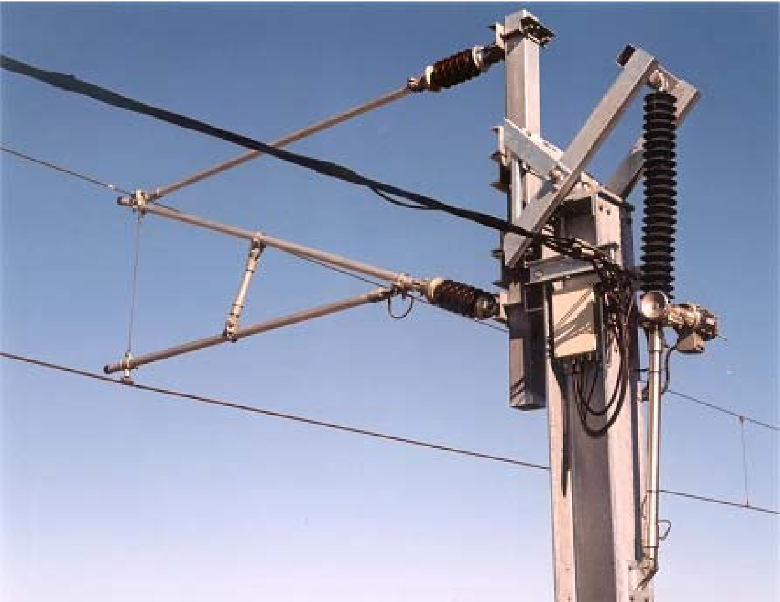
[picture p28: page 1]
