jop-devel/jop/doc/book/results/results_kfl_mast2.pdf

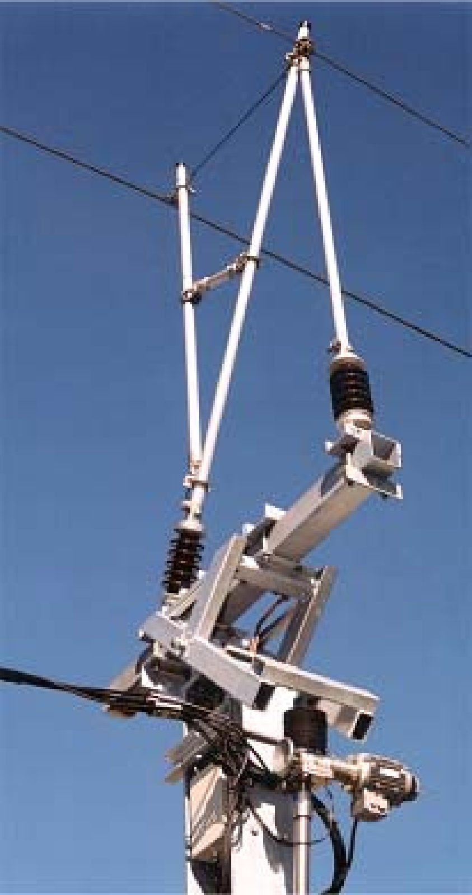
[picture p29: page 1]
