jop-devel/jop/doc/book/results/results_sigdel_real.pdf

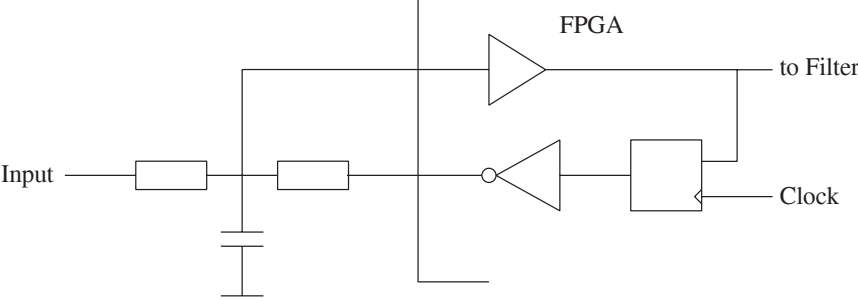
[picture p30: figure]
FPGA; to Filte; Clock Input
