jop-devel/jop/doc/book/jvm/gc_test.xls

Sheet: Tabelle1
41124
40988
40856
40396
40388
40340
39824
39268
38752
38712
38696
38680
38664
37664
36664
35664
34664
33664
32664
31664
41124
39356
36744
35680
34680
33680
32680
31680
30680
29680
28680
27680
26680
25680
24680
23680
22680
21680
20680
19680
18680
17680
16680
15680
14680
13680
12680
11680
10680
41100
39488
36956
35680
34680
33680
32680
31680
30680
29680
28680
27680
26680
25680
24680
23680
22680
21680
20680
19680
18680
17680
16680
15680
14680
13680
12680
11680
10680
41124
39356
36744
35680
34680
33680
32680
31680
30680
29680
28680
27680
26680
25680
24680
23680
22680
21680
20680
19680
18680
17680
16680
15680
14680
13680
12680
11680
10680
41100
39488
36956
35680
34680
33680
32680
31680
30680
29680
28680
27680
26680
25680
24680
23680
22680
21680
20680
19680
18680
17680
16680
15680
14680
13680
12680
11680
10680
41124
39356
36744
35680
34680
33680
32680
31680
30680
29680
28680
27680
26680
25680
24680
23680
22680
21680
20680
19680
18680
17680
16680
15680
14680
13680
12680
11680
10680
41100
39488
36956
35680
34680
33680
32680
31680
30680
29680
28680
27680
26680
25680
24680
23680
22680
21680
20680
19680
18680
17680
16680
15680
14680
13680
12680
11680
10680
41124
39356
36744
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
