jop-devel/jop/doc/book/results/perf.xlsx

 | Cjip | jamuth | EJC | SHAP | aJ100 | JOP | picoJava | CACAO/YARI
Kfl | 176 | 3400 | 9893 | 11570 | 14148 | 19907 | 23813 | 51200
UdpIp | 91 | 1500 | 2882 | 5764 | 6415 | 8837 | 11950 | 23223
Lift |  |  |  | 12226 |  | 18930 | 25444 | 52261
 | Cjip | jamuth | EJC | SHAP | aJ100 | JOP | picoJava | CACAO/YARI
Kfl | 0.008841111167 | 0.170794193 | 0.496960868 | 0.5812025921 | 0.7107047772 | 1 | 1.196212388 | 2.571959612
UdpIp | 0.01029761231 | 0.1697408623 | 0.3261287767 | 0.6522575535 | 0.7259250877 | 1 | 1.35226887 | 2.62792803
Lift | 0 | 0 | 0 | 0.6458531432 | 0 | 1 | 1.344109878 | 2.760750132
