jop-devel/jop/doc/book/results/tal.pdf

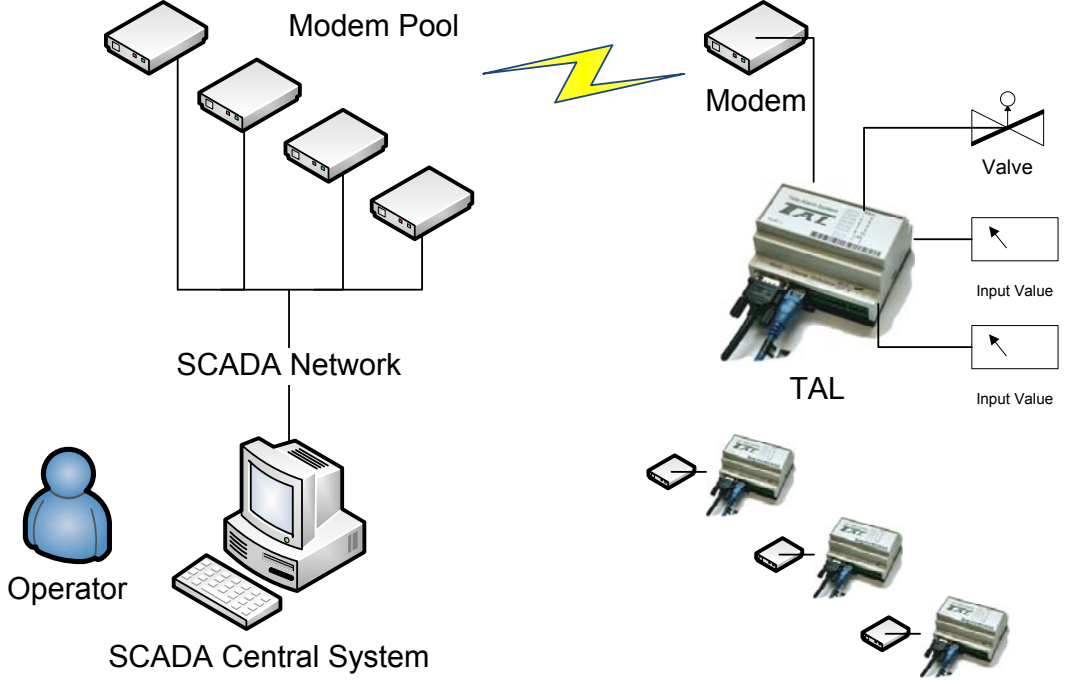
[picture p31: page 1]
Operator; SCADA Network; Modem Pool; Modem; TAL; Valve; Input Value

SCADA Central System
