jop-devel/jop/doc/book/results/zlb.pdf

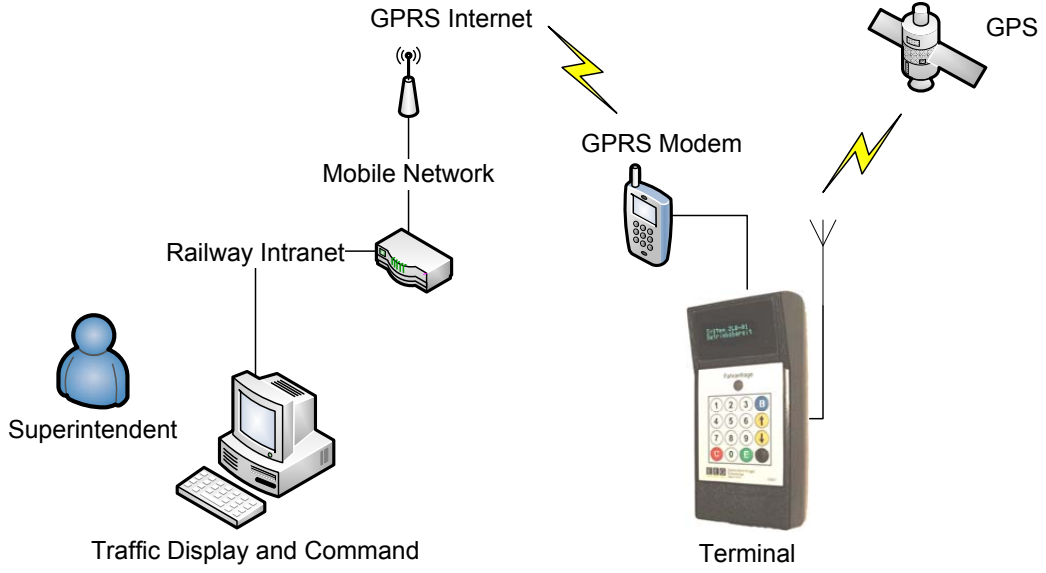
[picture p32: page 1]
Superintendent; Railway Intranet; Mobile Network; GPRS Internet; GPS; GPRS Modem; Terminal

Traffic Display and Command
