jop-devel/jop/doc/book/io/memory.pdf

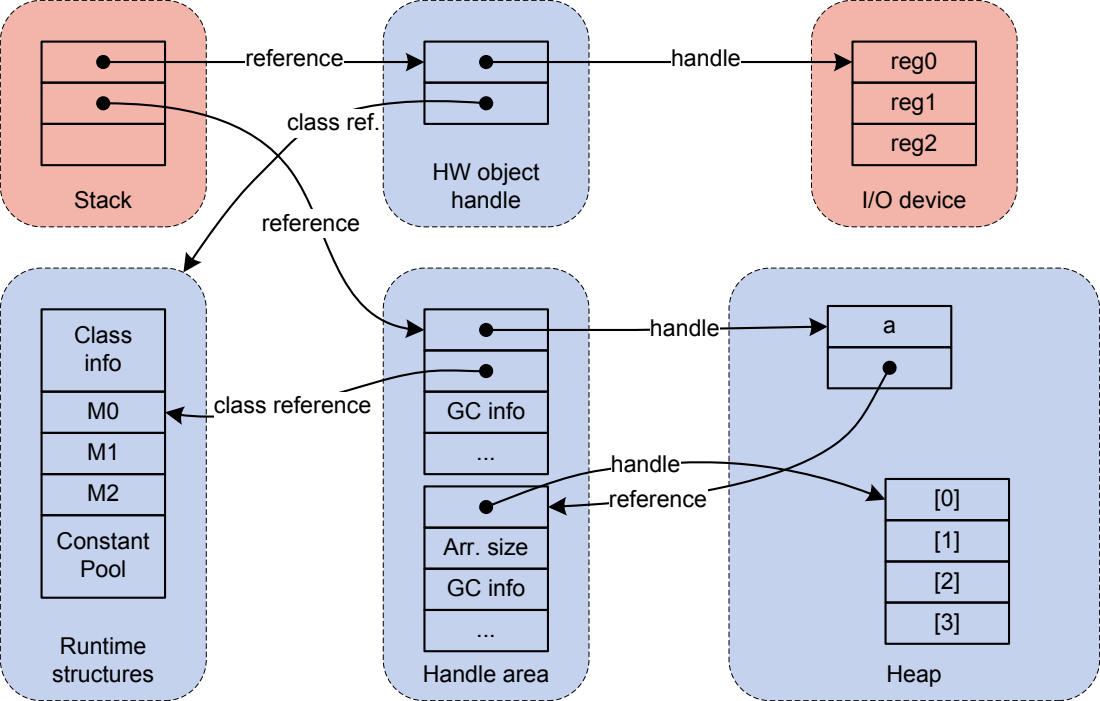
[picture p33: page 1]
I/O device; HW object; Stack; handle; Handle area; Heap; Runtime structures; GC info; Arr. size; reference; Class info; Constant Pool; class reference; class ref.; reg0; reg1; reg2
