jop-devel/jop/doc/book/arch/arch_bcfetch.pdf

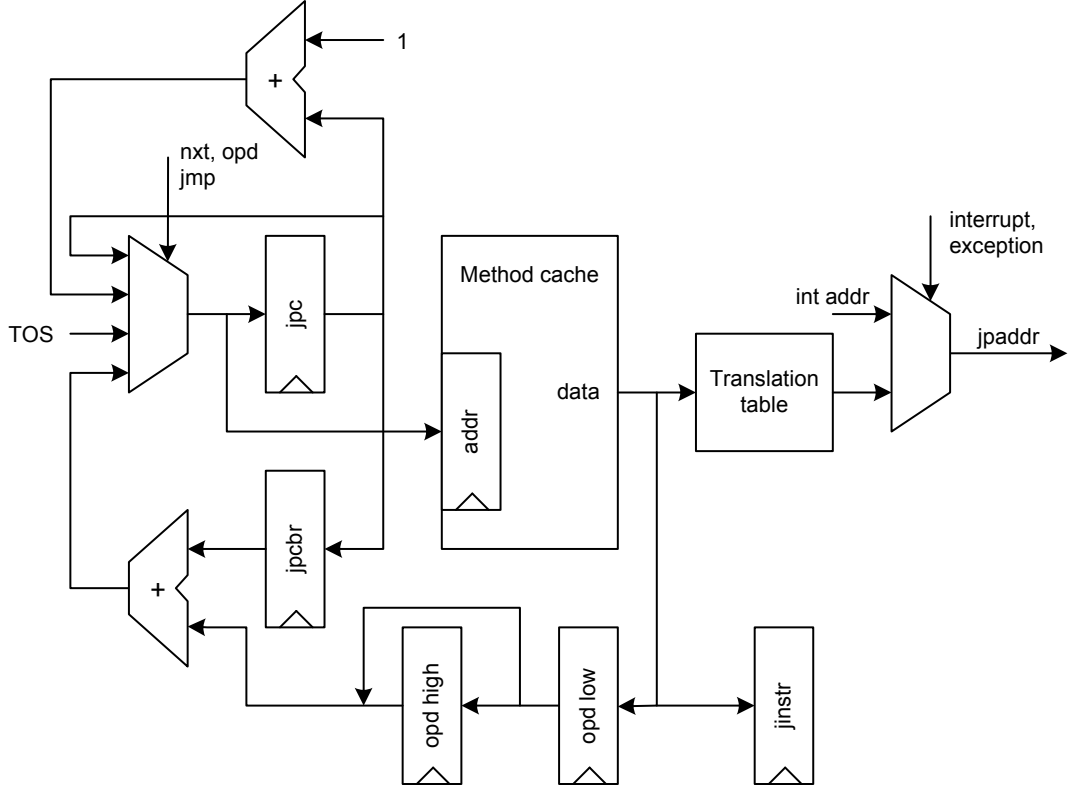
[picture p34: page 1]
jpc jpcbr; data; nxt, opd jmp; TOS; opd high; opd low; jinstr; Translation table; jpaddr; interrupt, exception; int addr

Method cache addr
