jop-devel/jop/doc/book/arch/arch_jop_block.pdf

# SimpCon SimpCon

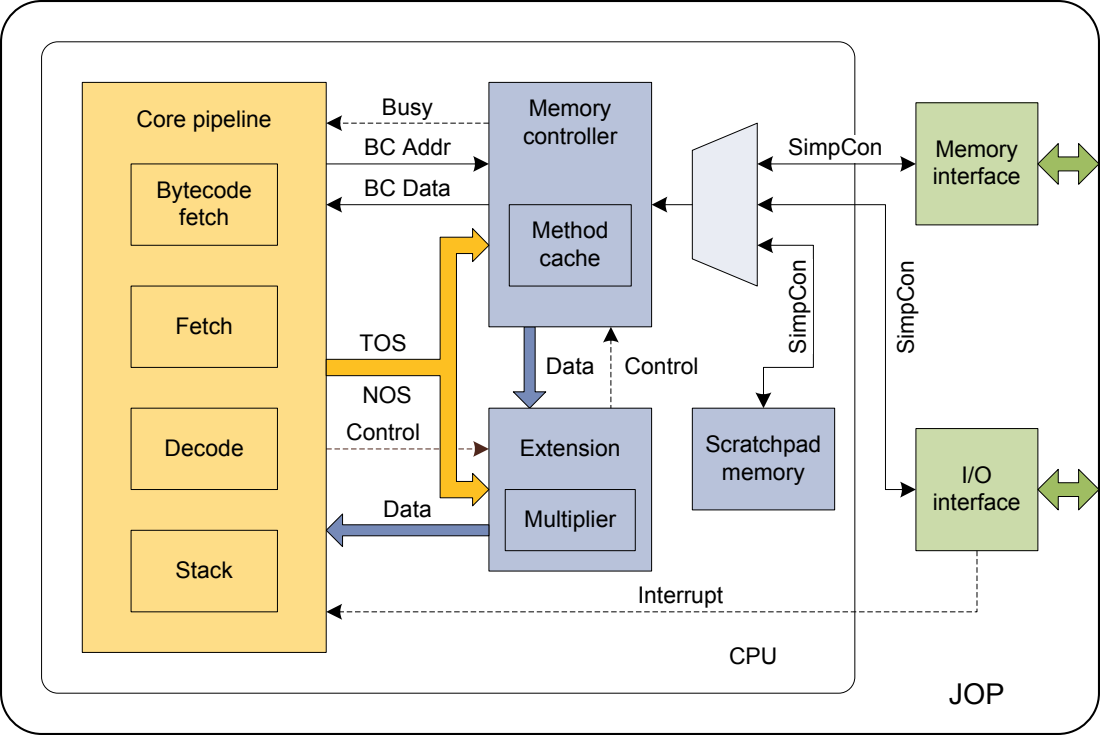
[picture p35: page 1]
Control; JOP; Busy; BC Addr; BC Data; CPU; Scratchpad; memory; interface; Memory interface; Data; Extension; Multiplier; Memory controller; Method cache; SimpCon; Interrupt; Core pipeline; Bytecode fetch; Fetch; Decode; Stack; TOS; NOS
