jop-devel/jop/doc/book/results/perf.pdf

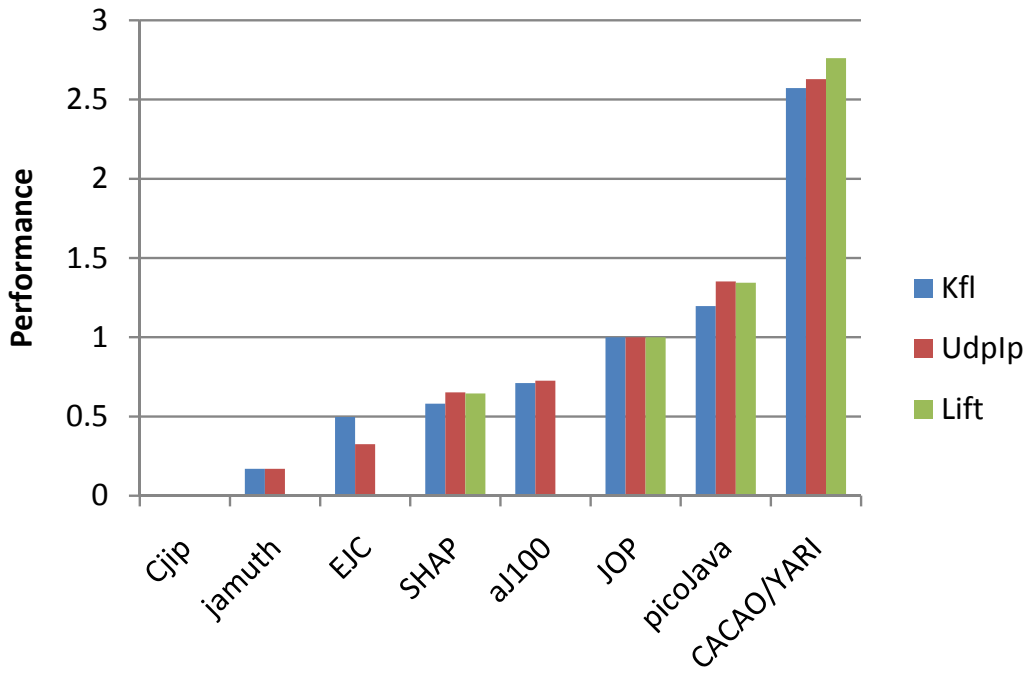
[picture p36: page 1]
rformance Kfl; UdpIp; Lift
