jop-devel/jop/doc/book/results/results_wcet_sort.pdf

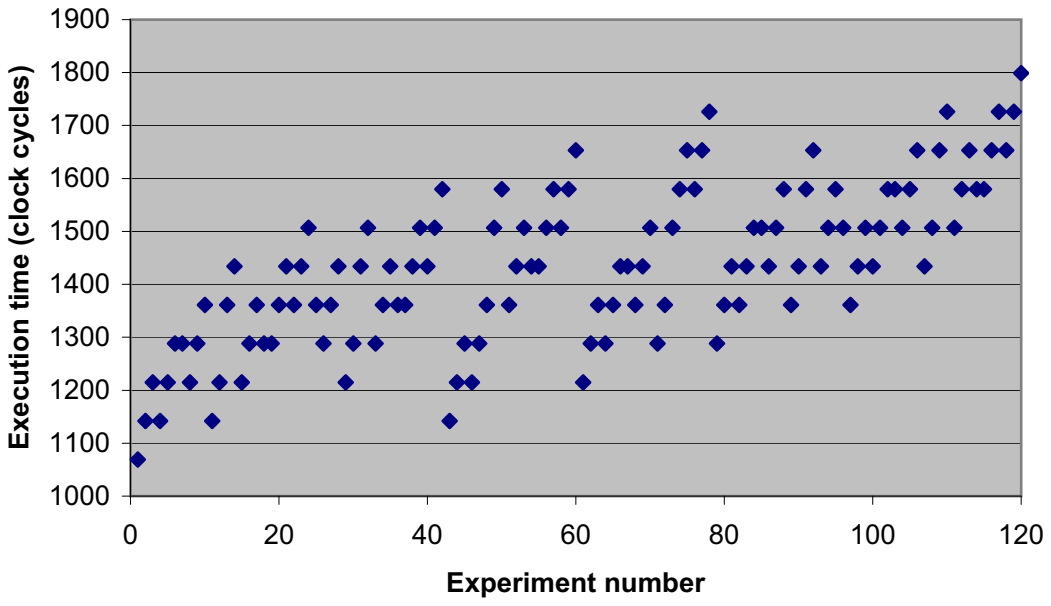
[picture p37: page 1]
Experiment number

Execution time (clock cycles)
