jop-devel/jop/doc/book/results/results_wcet_cfg.pdf

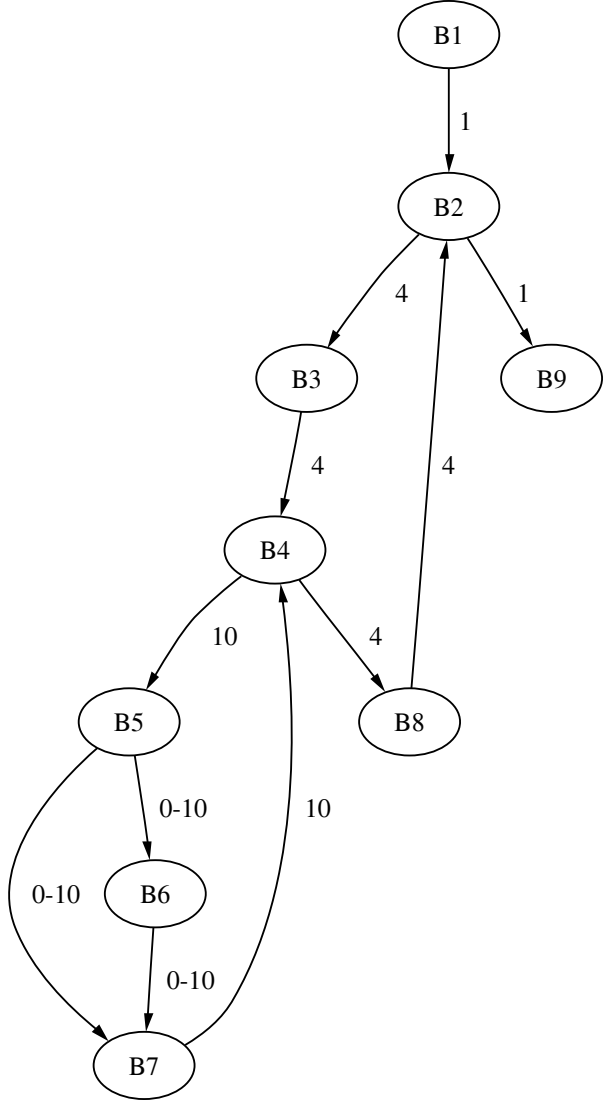
[picture p38: page 1]
