jop-devel/jop/doc/book/stack/stack_cache_jop.pdf

### ALU Read

### Stack

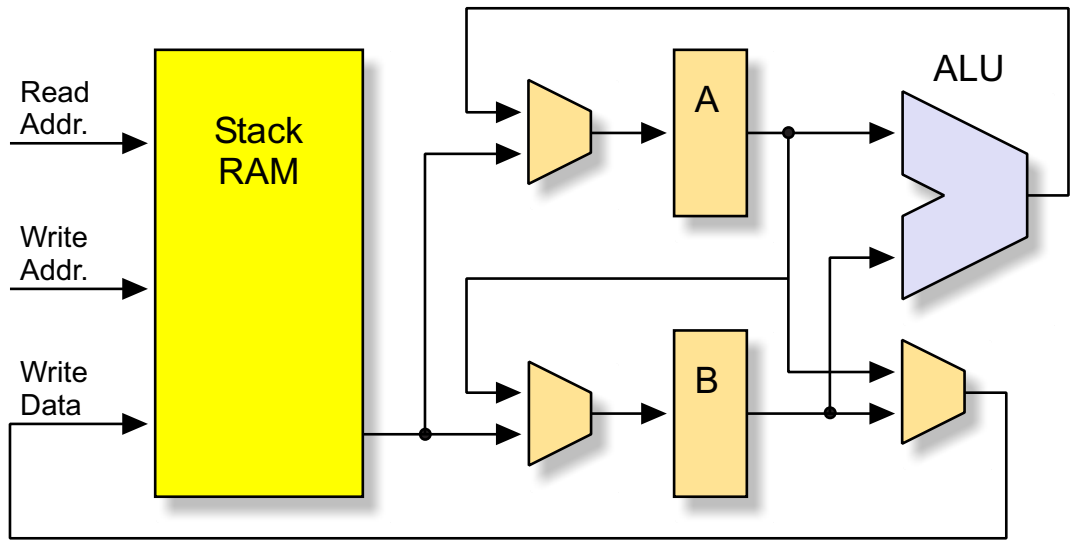
[picture p39: page 1]
Addr.; Write; Write Data; RAM
