jop-devel/jop/doc/book/appendix/baseio_p1.pdf

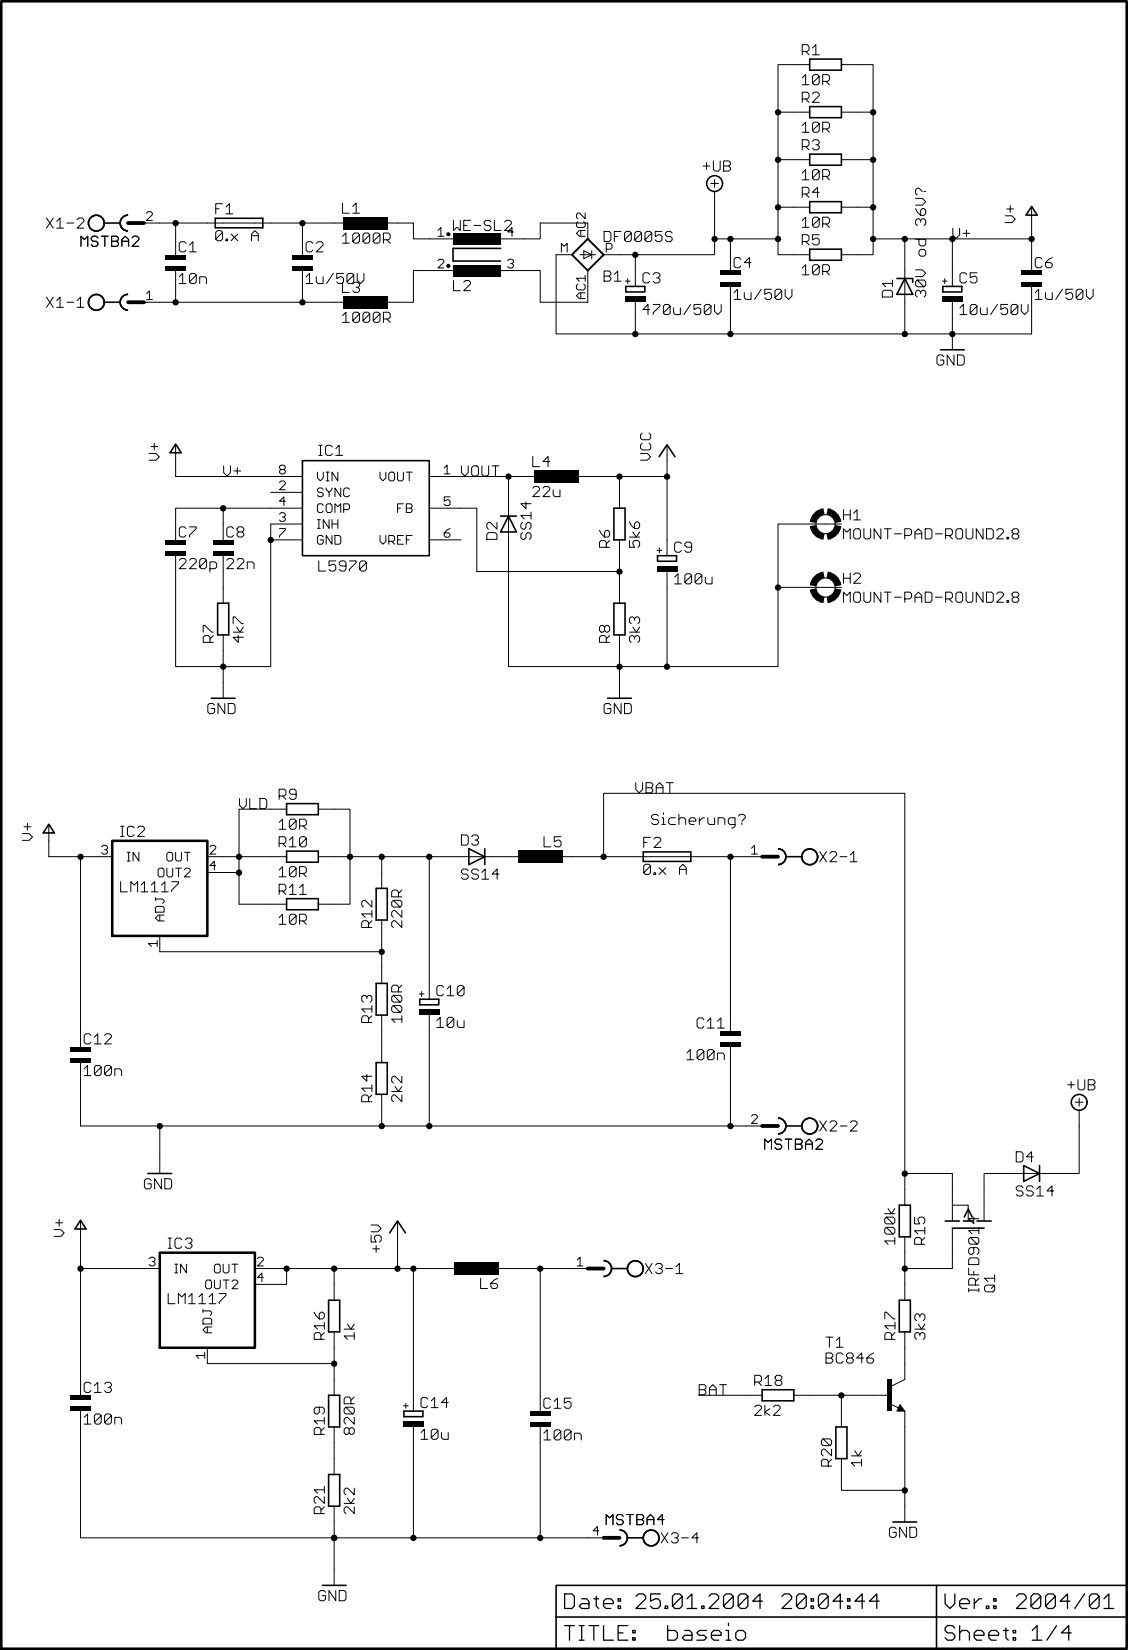
[picture p40: page 1]
