jop-devel/jop/doc/book/appendix/baseio_p2.pdf

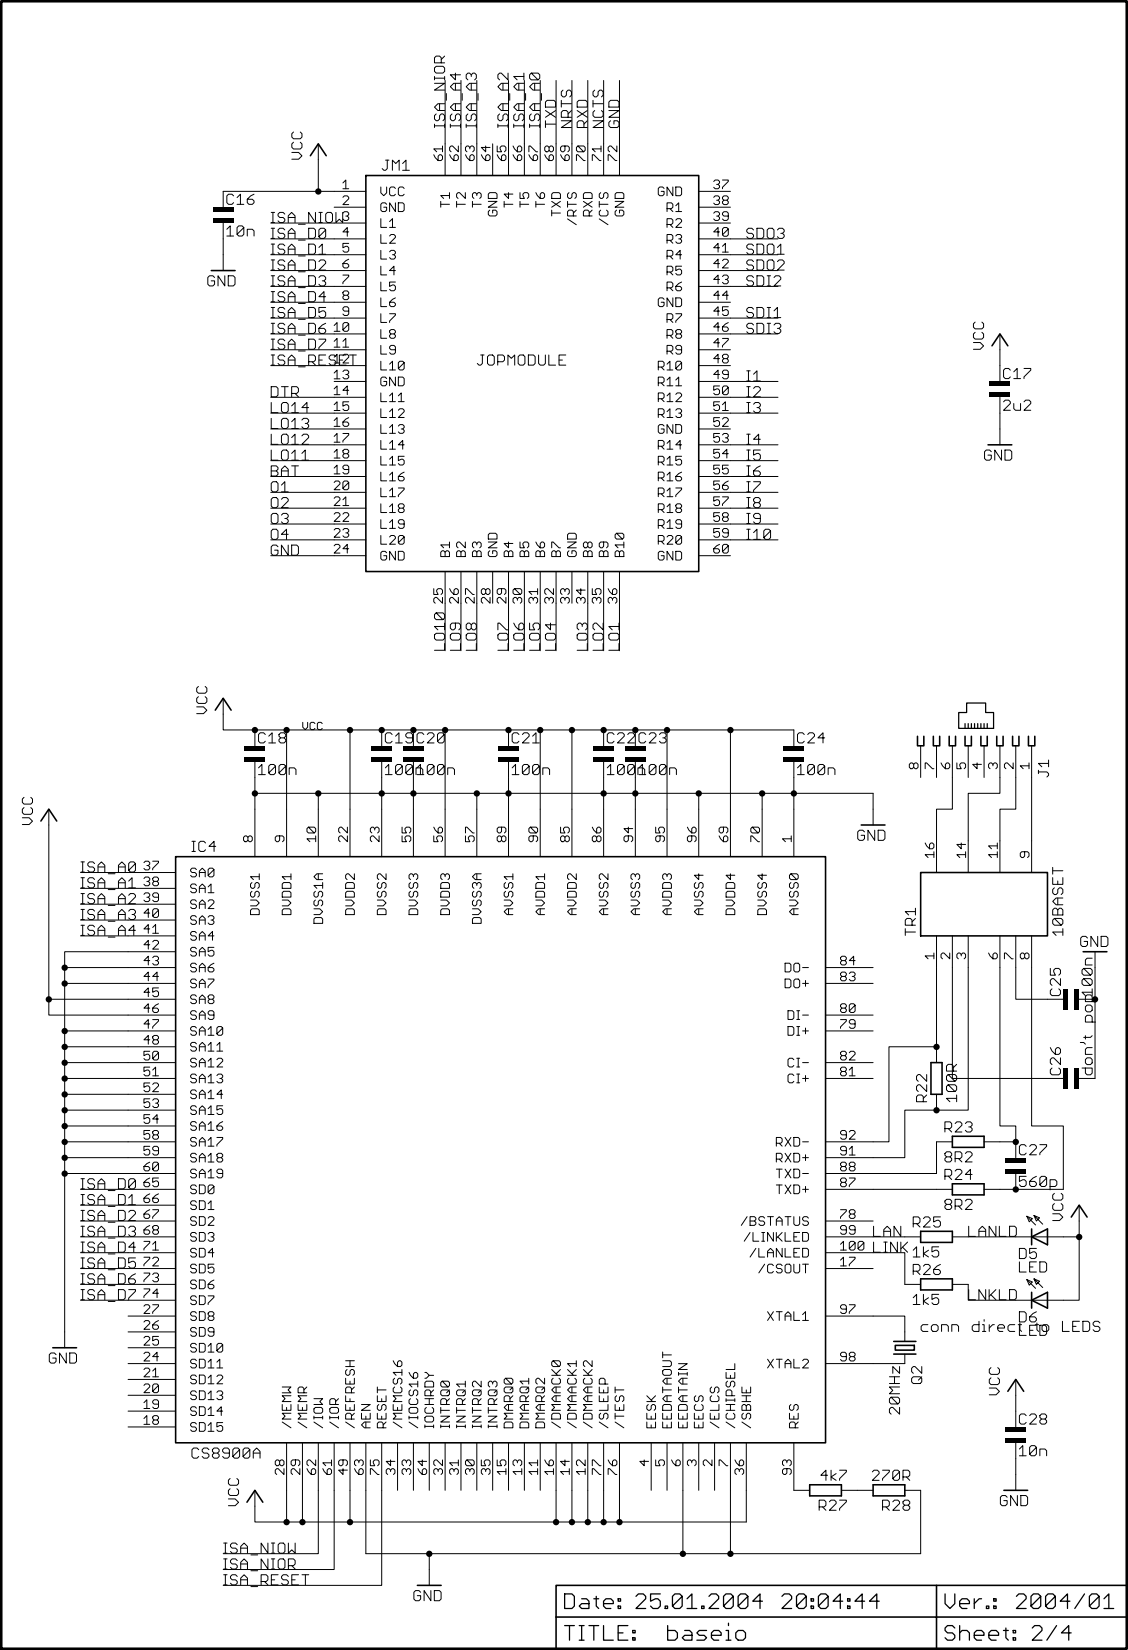
[picture p41: page 1]
