jop-devel/jop/doc/book/appendix/baseio_p3.pdf

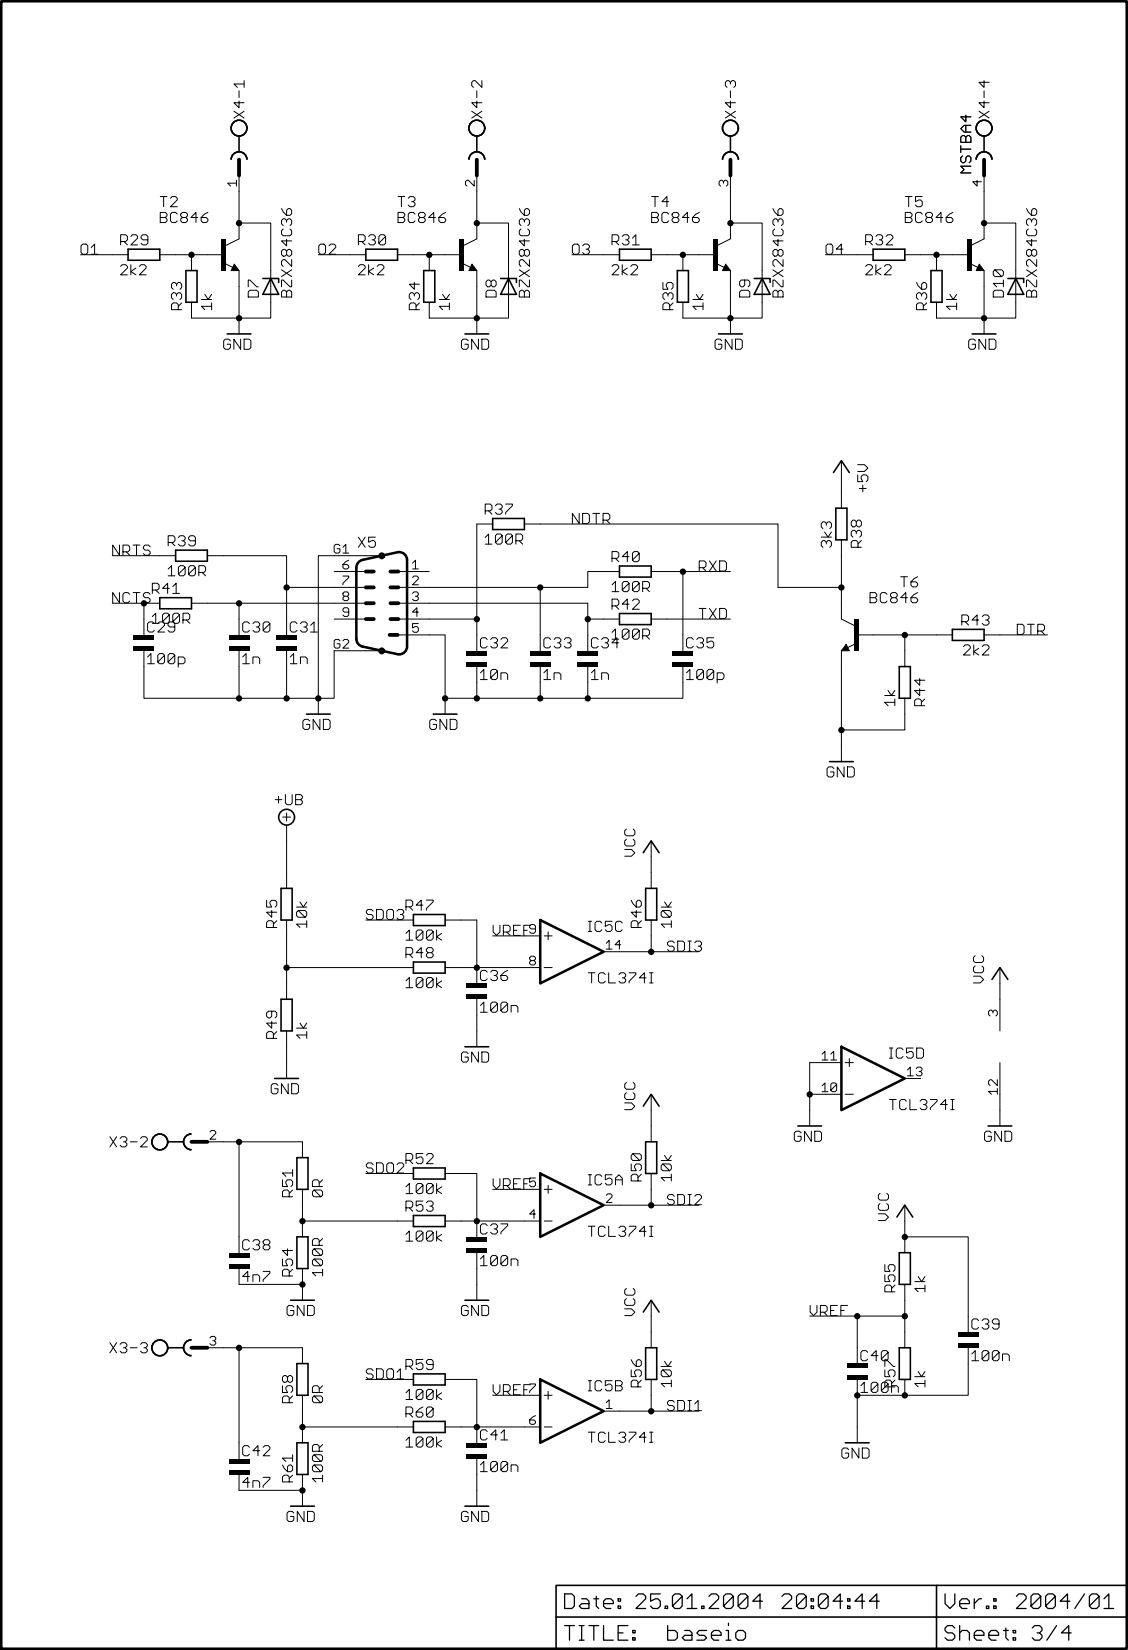
[picture p42: page 1]
