jop-devel/jop/doc/book/appendix/baseio_p4.pdf

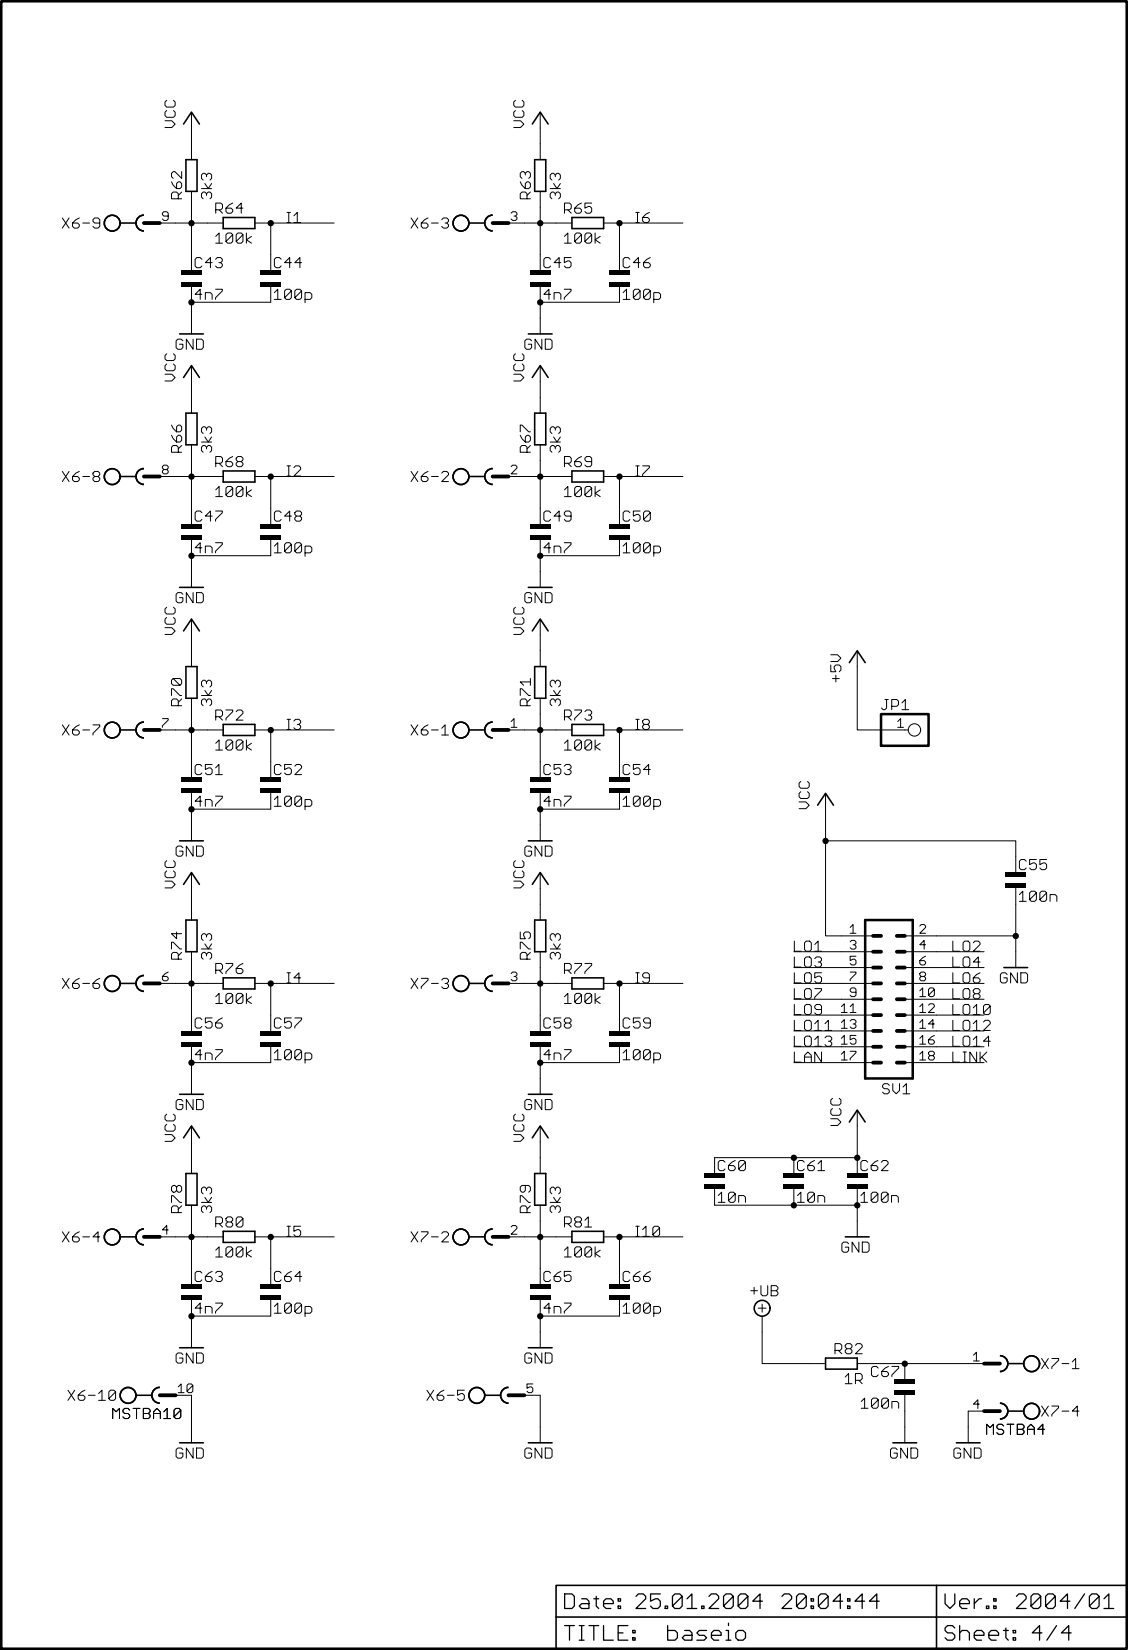
[picture p43: page 1]
