jop-devel/jop/doc/book/appendix/cycore_p1.pdf

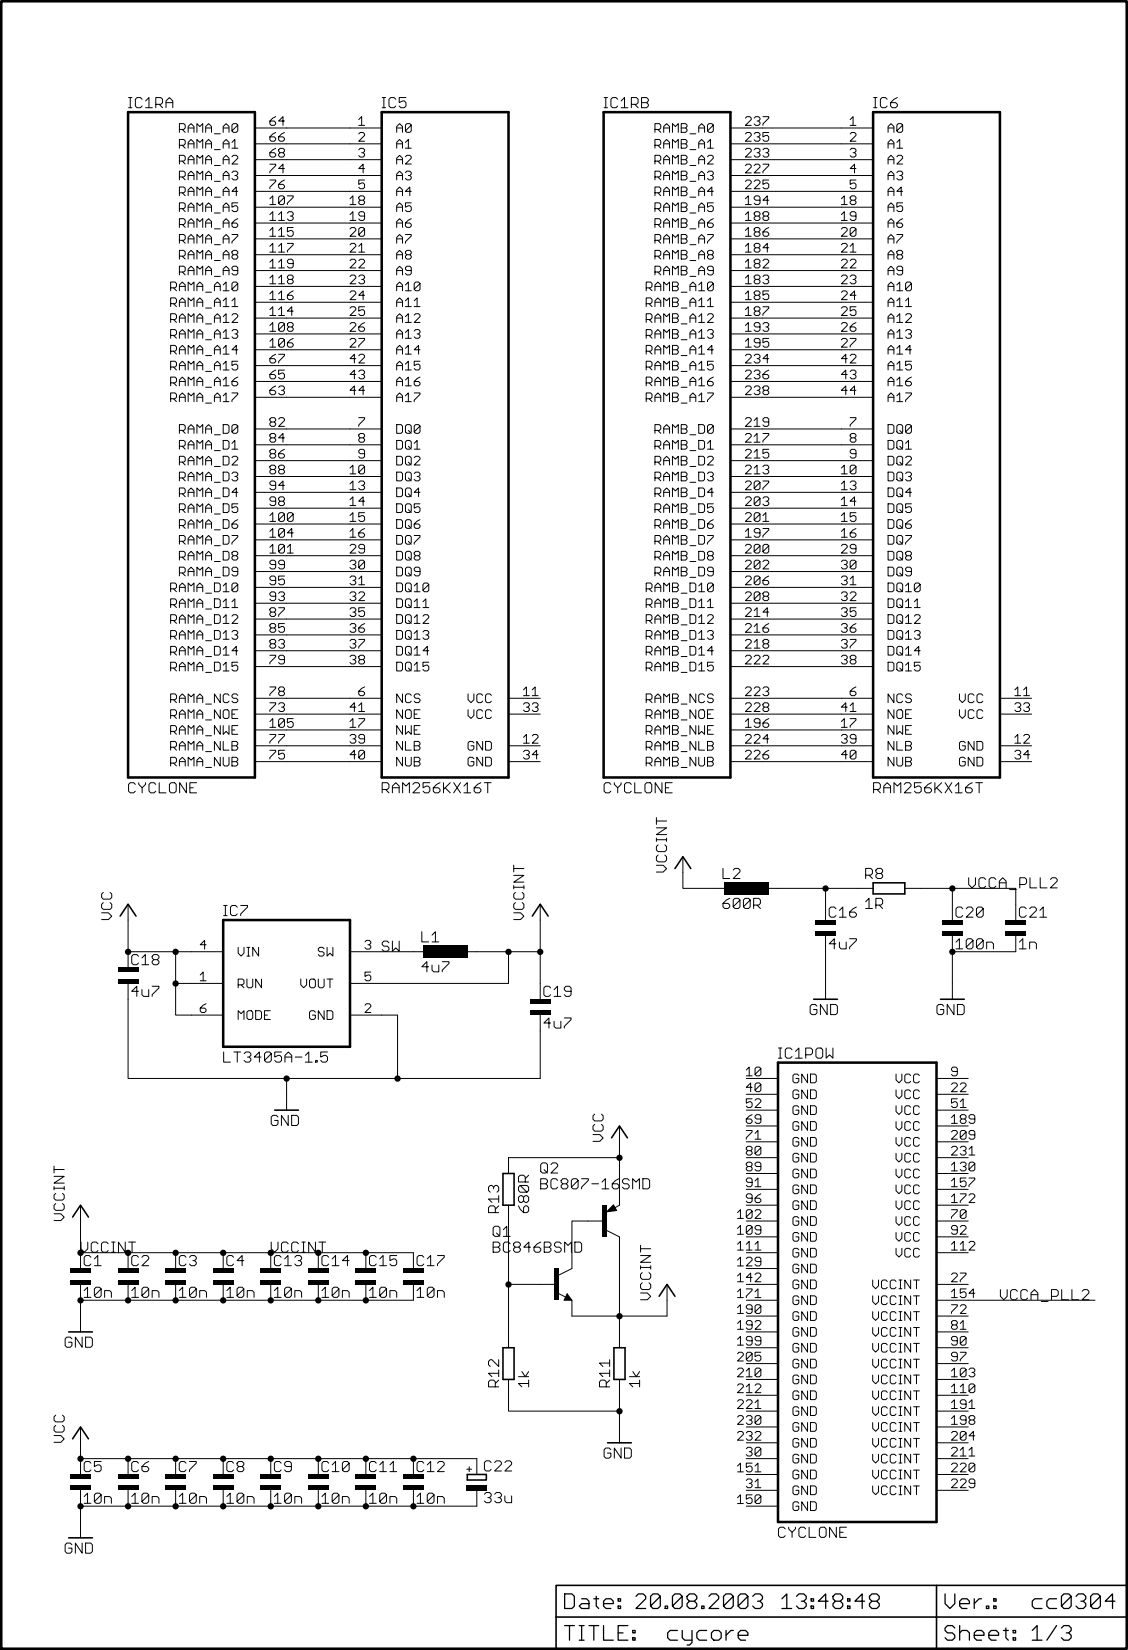
[picture p44: page 1]
