jop-devel/jop/doc/book/appendix/cycore_p2.pdf

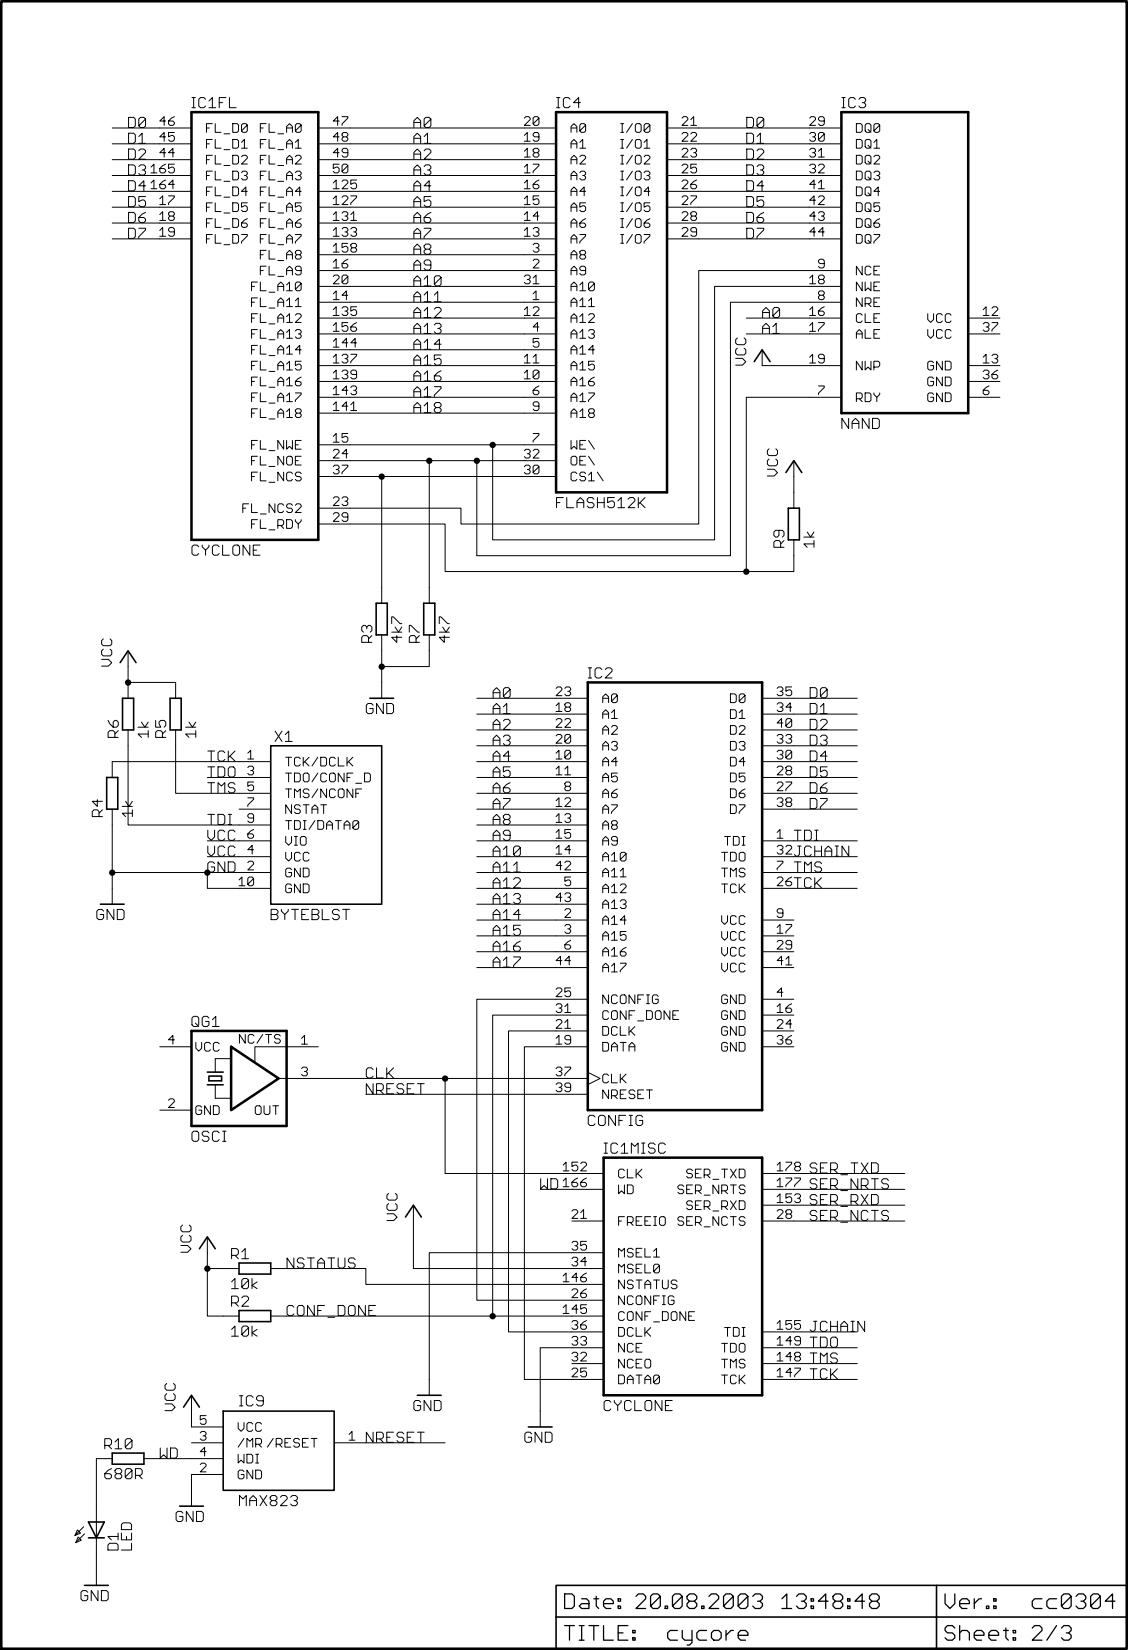
[picture p45: page 1]
