jop-devel/jop/doc/book/appendix/cycore_p3.pdf

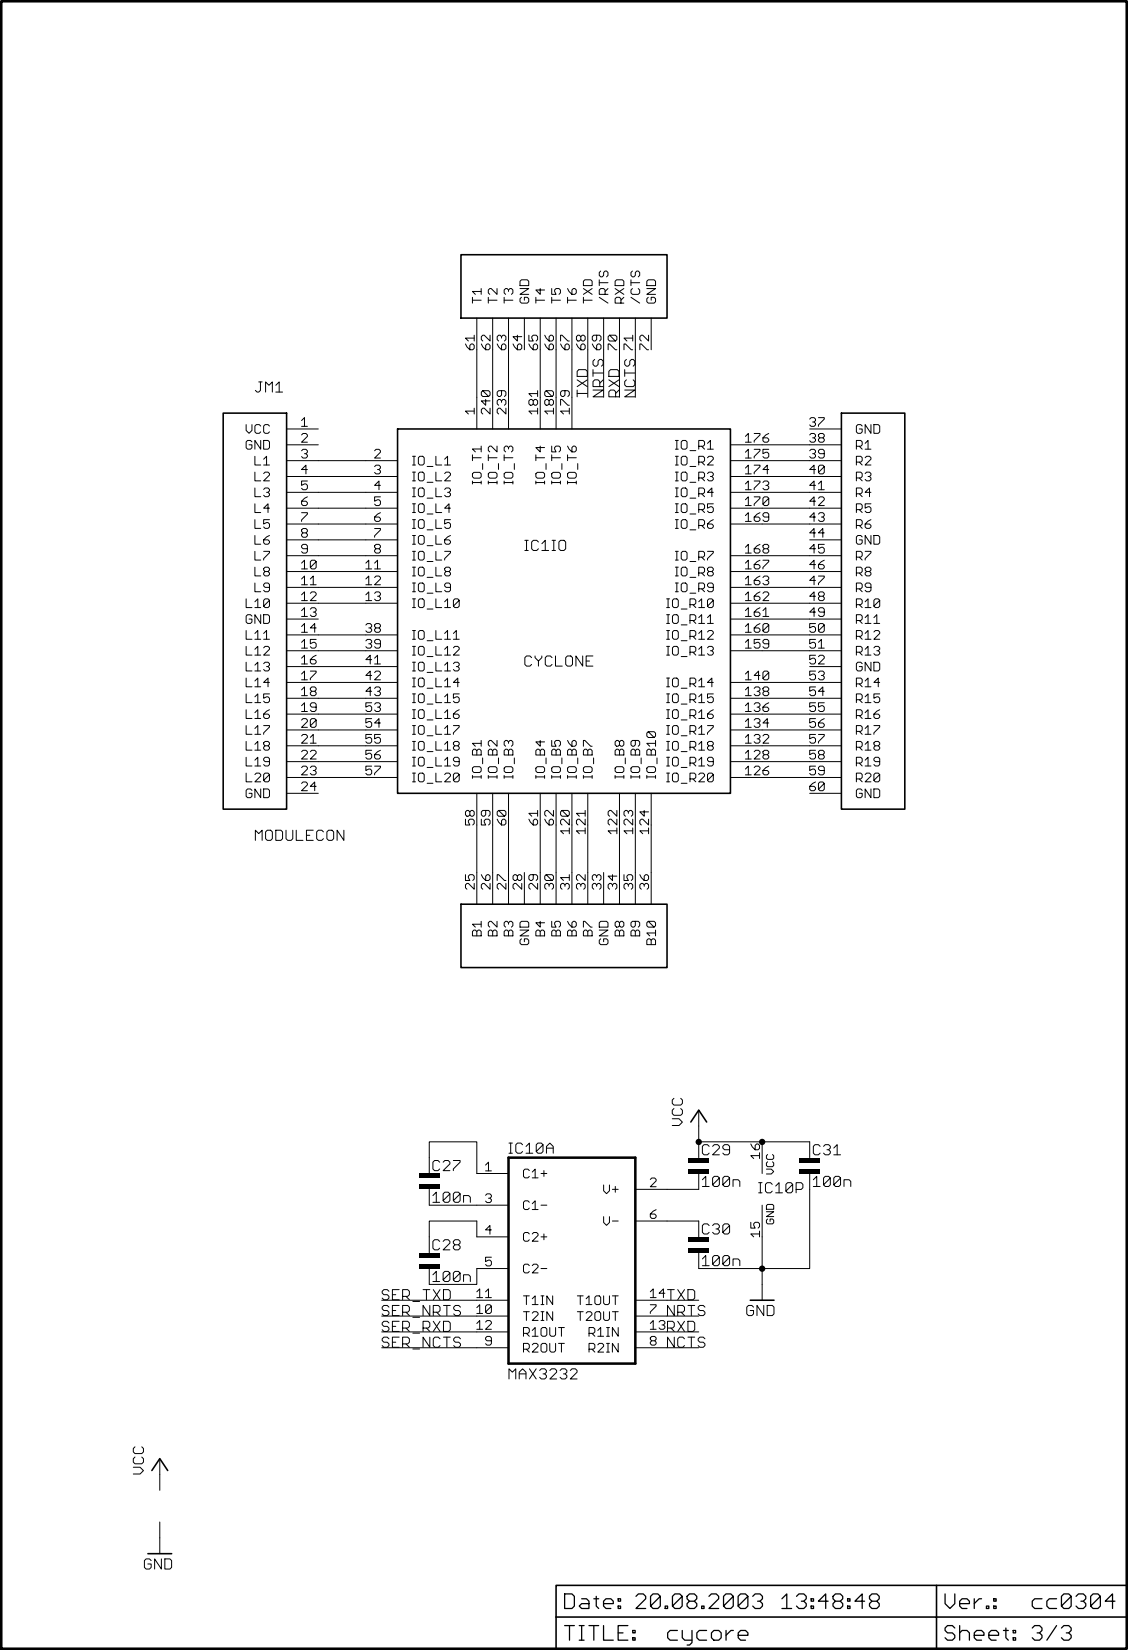
[picture p46: page 1]
