jop-devel/jop/doc/book/appendix/dspio_p1.pdf

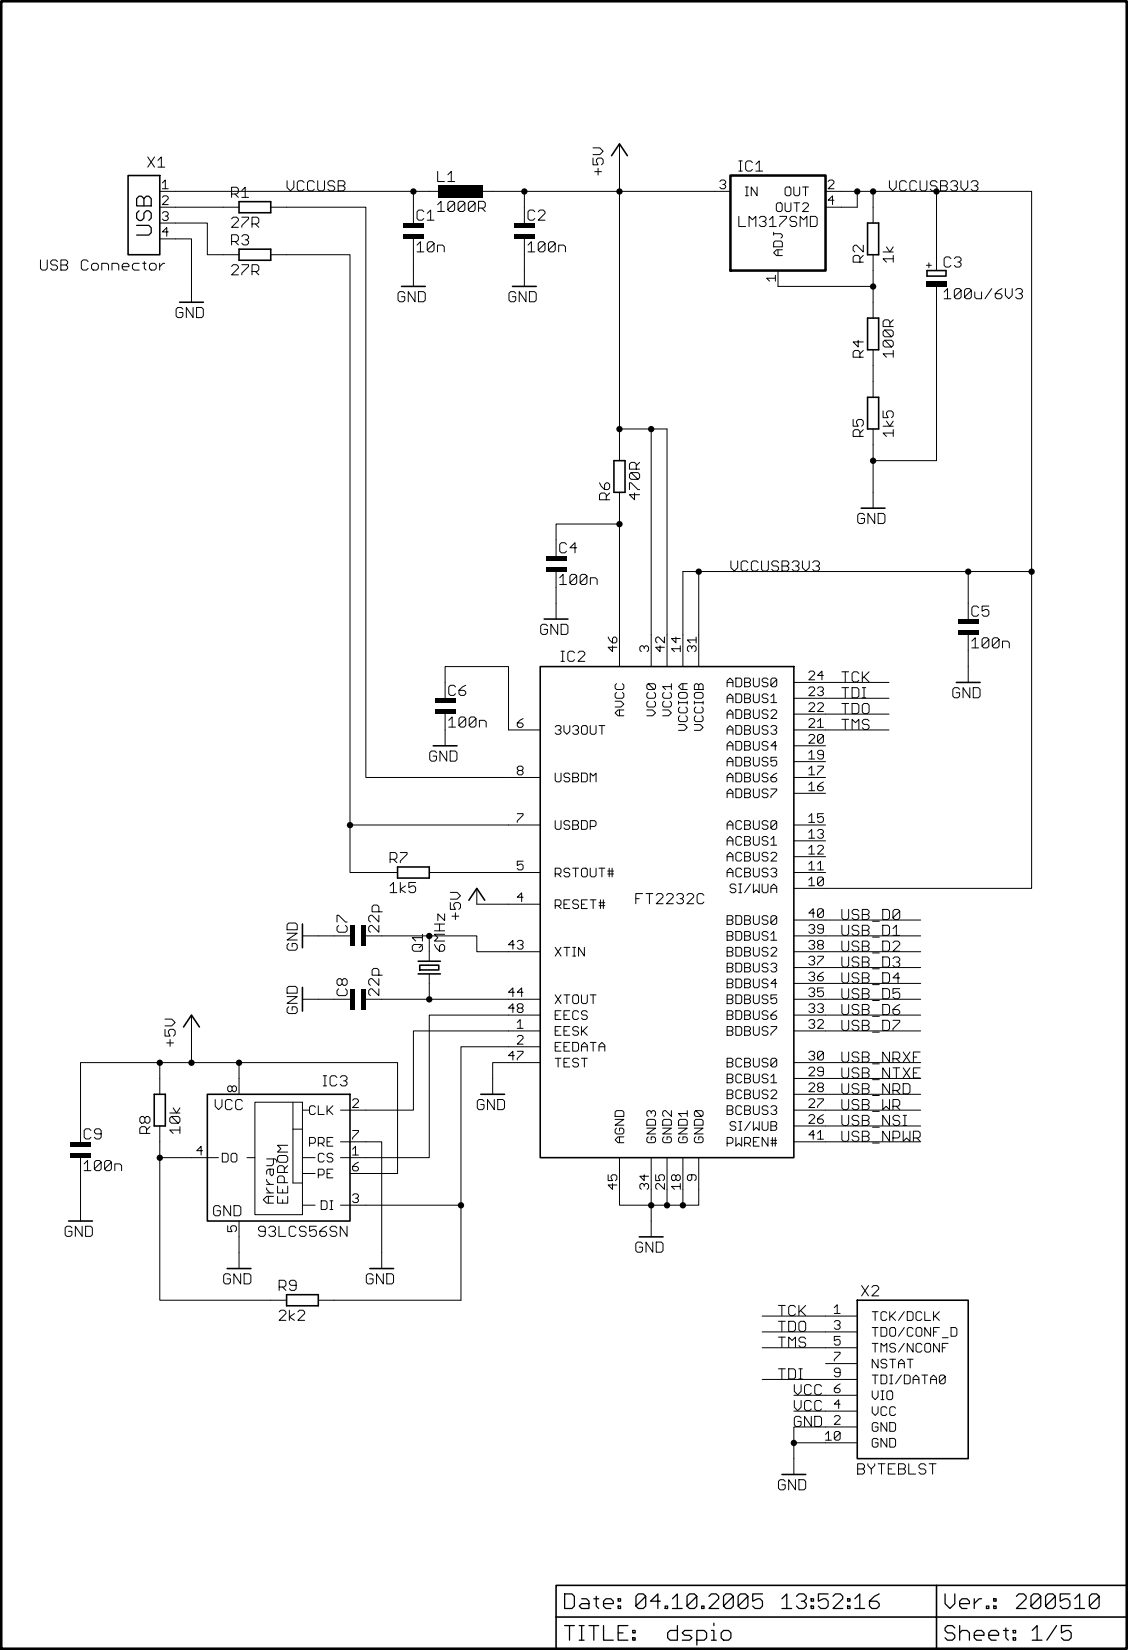
[picture p47: page 1]
