jop-devel/jop/doc/book/appendix/dspio_p2.pdf

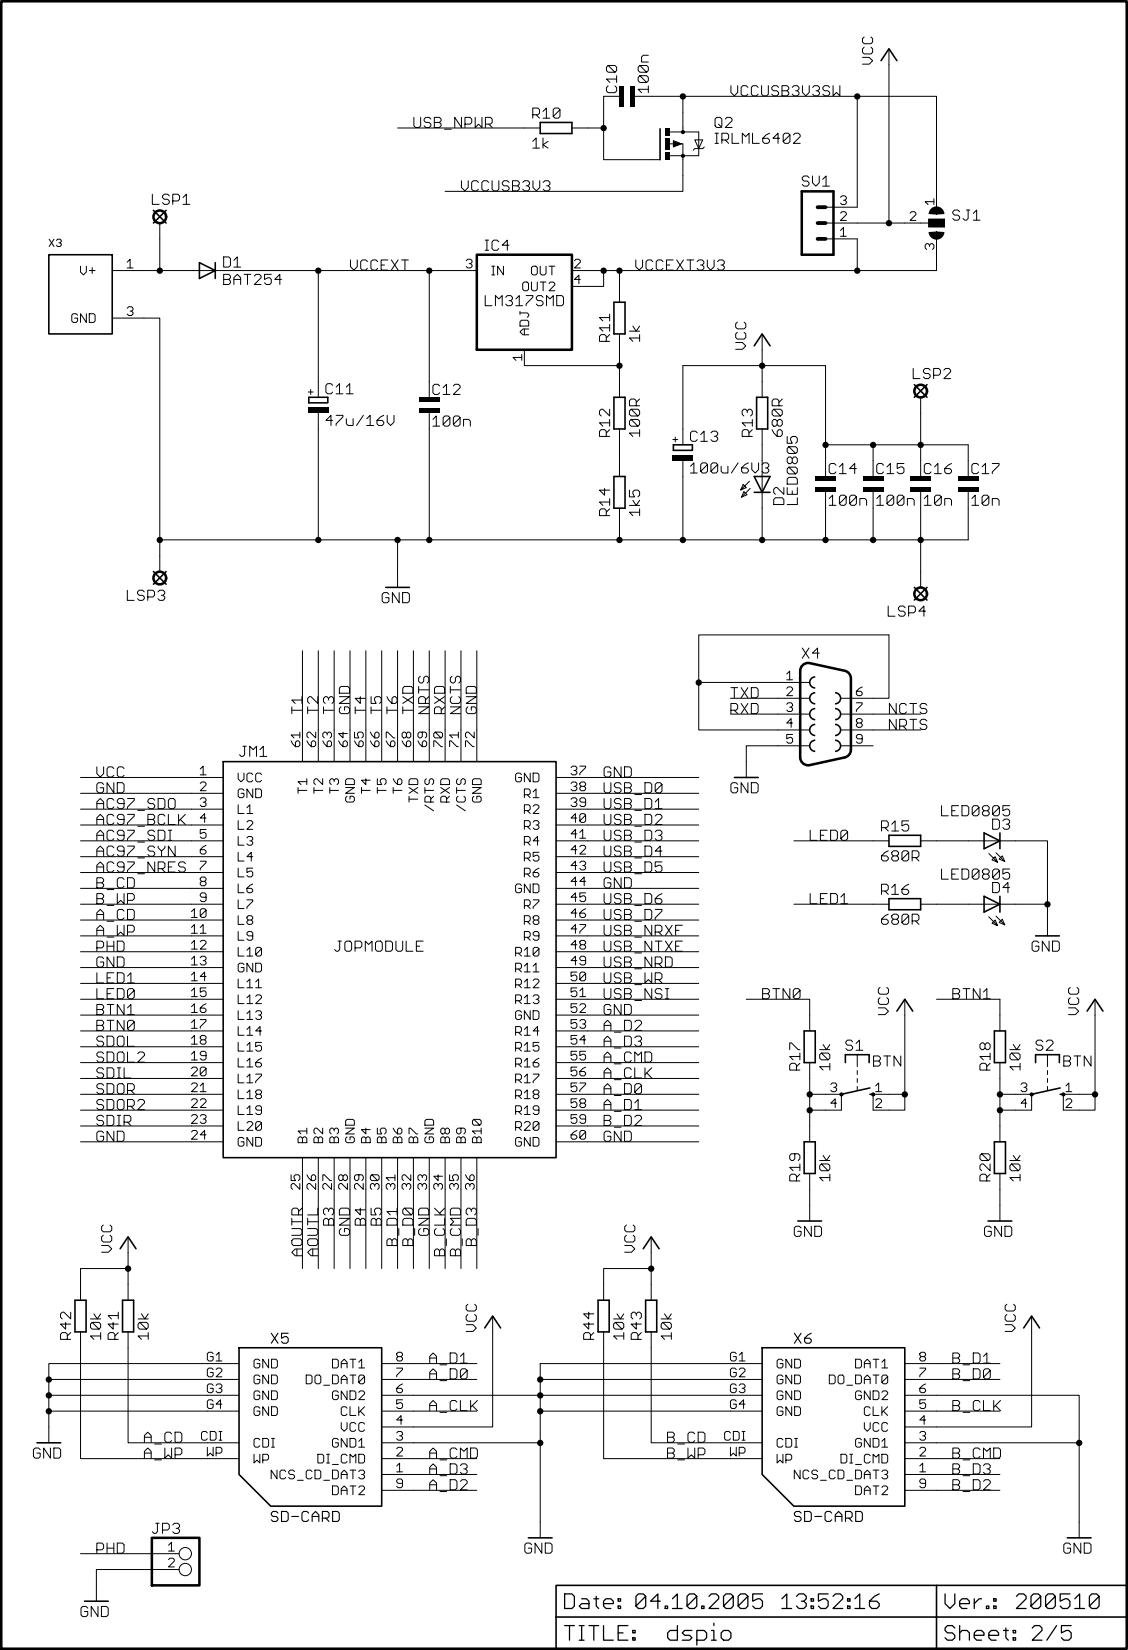
[picture p48: page 1]
