jop-devel/jop/doc/book/appendix/dspio_p3.pdf

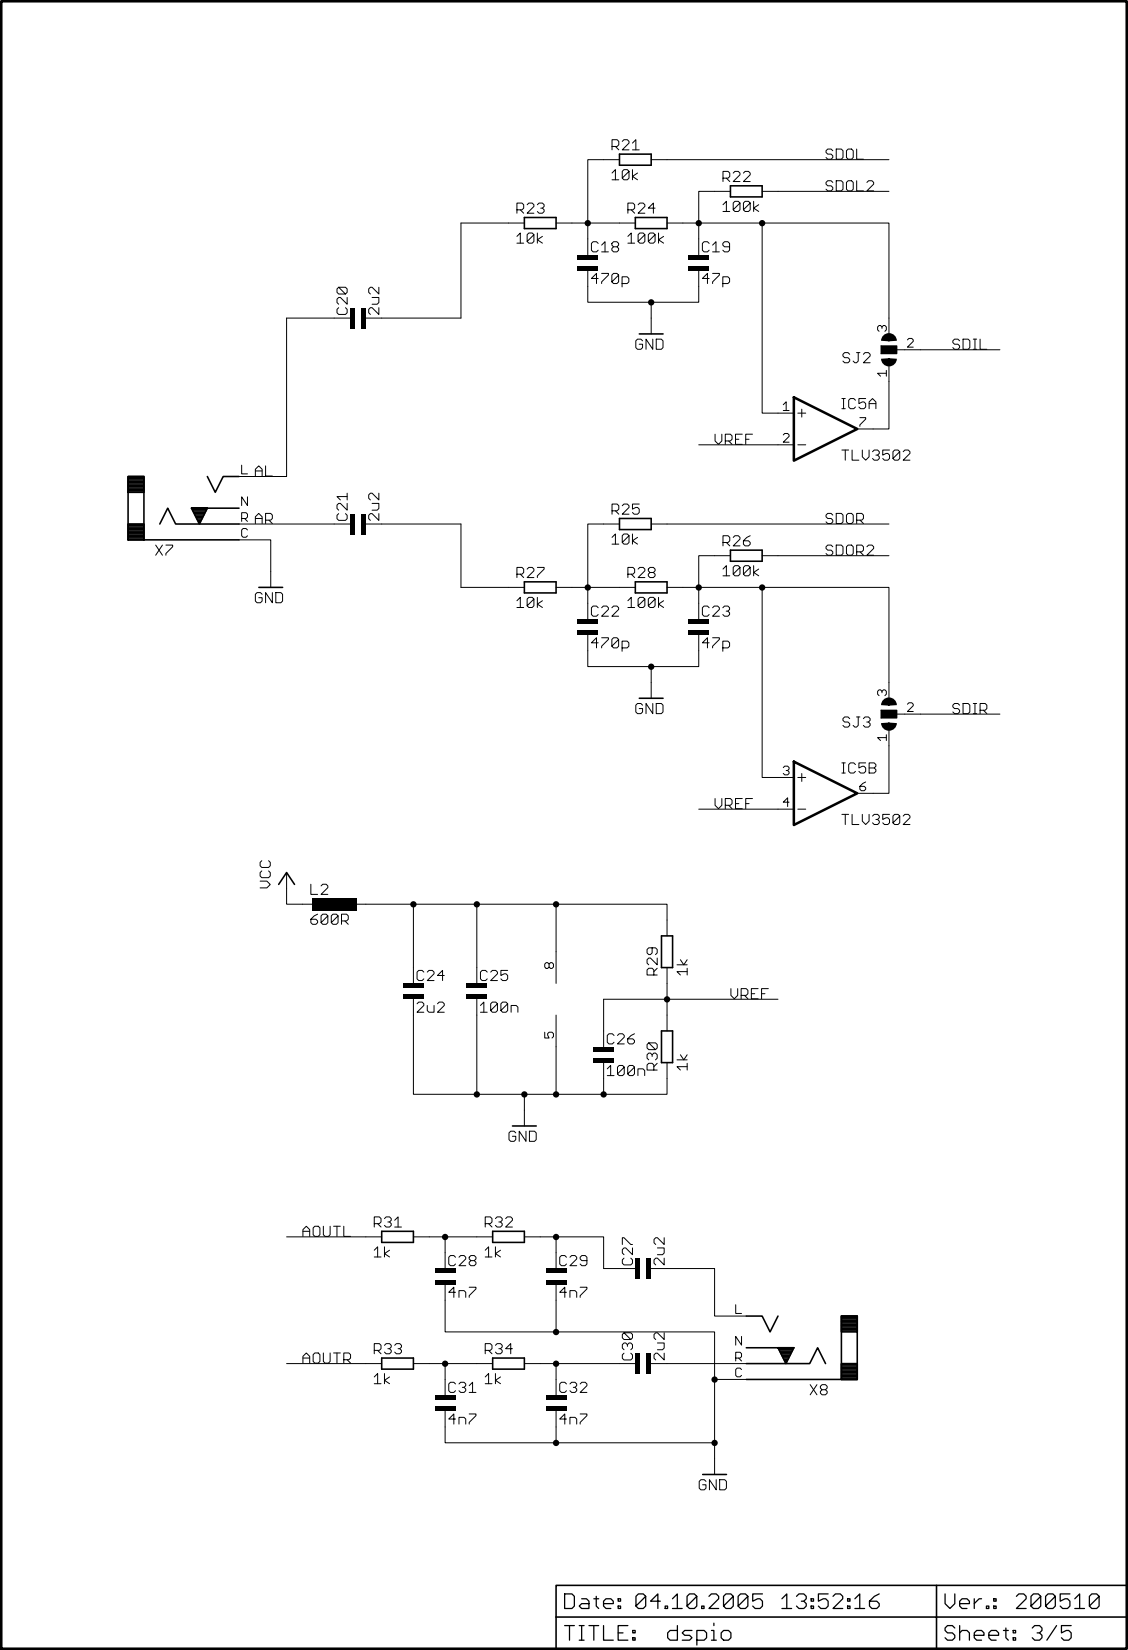
[picture p49: page 1]
