jop-devel/jop/doc/book/appendix/dspio_p4.pdf

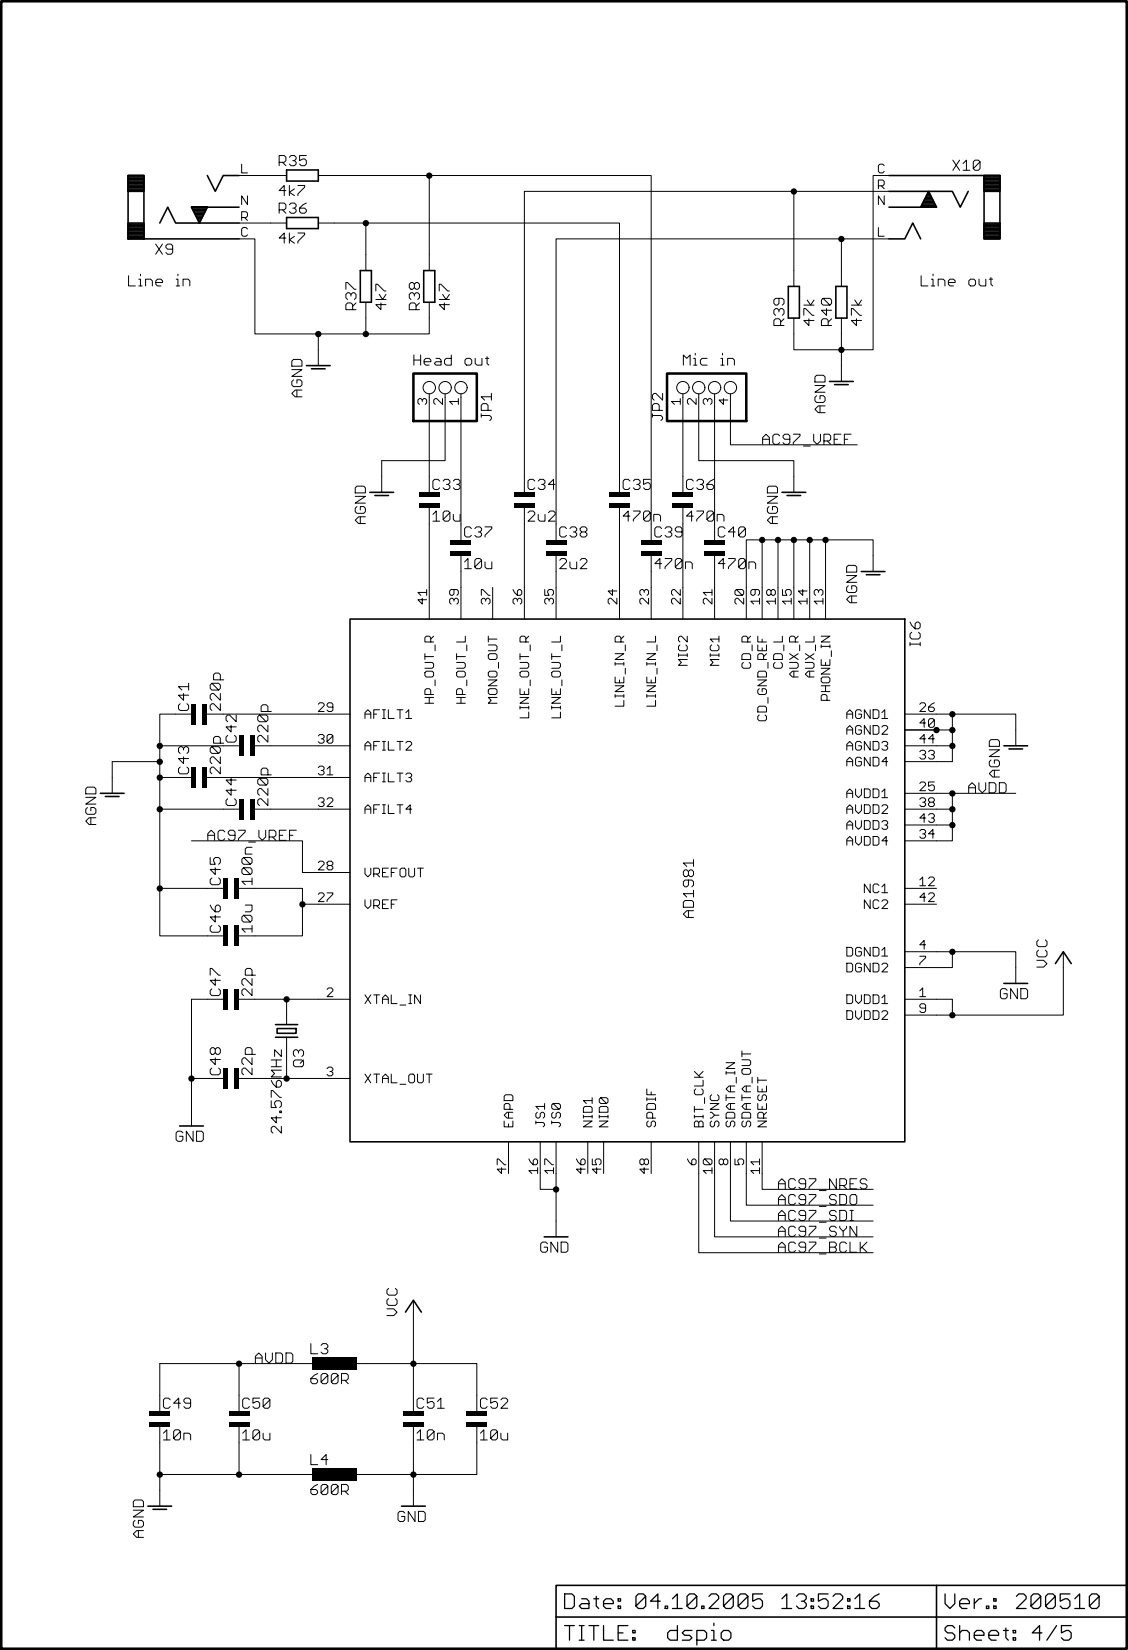
[picture p50: page 1]
