jop-devel/jop/doc/book/appendix/dspio_p5.pdf

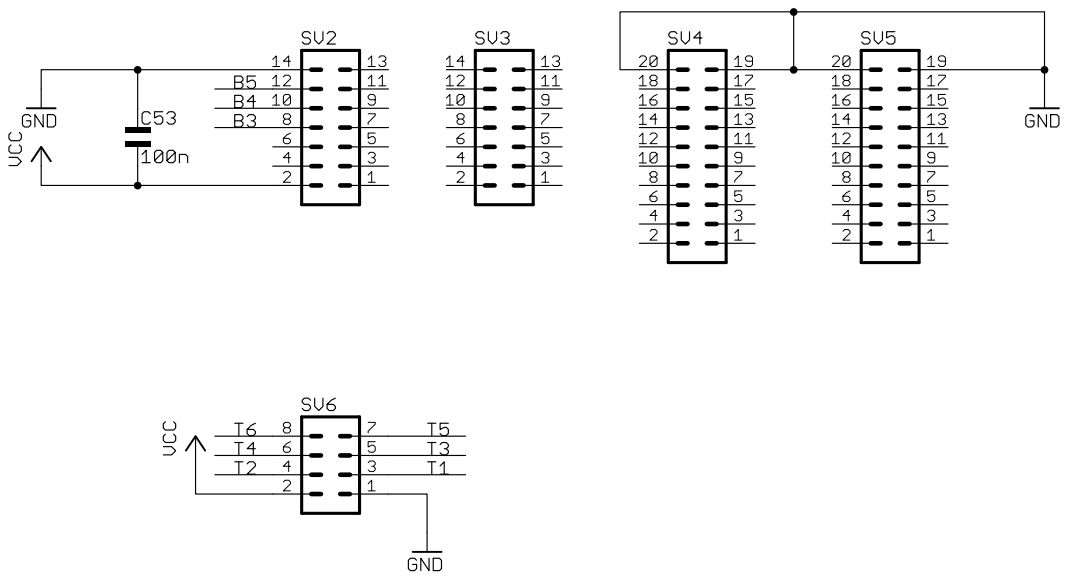
[picture p51: page 1]
