jop-devel/jop/doc/book/appendix/simpexp_p1.pdf

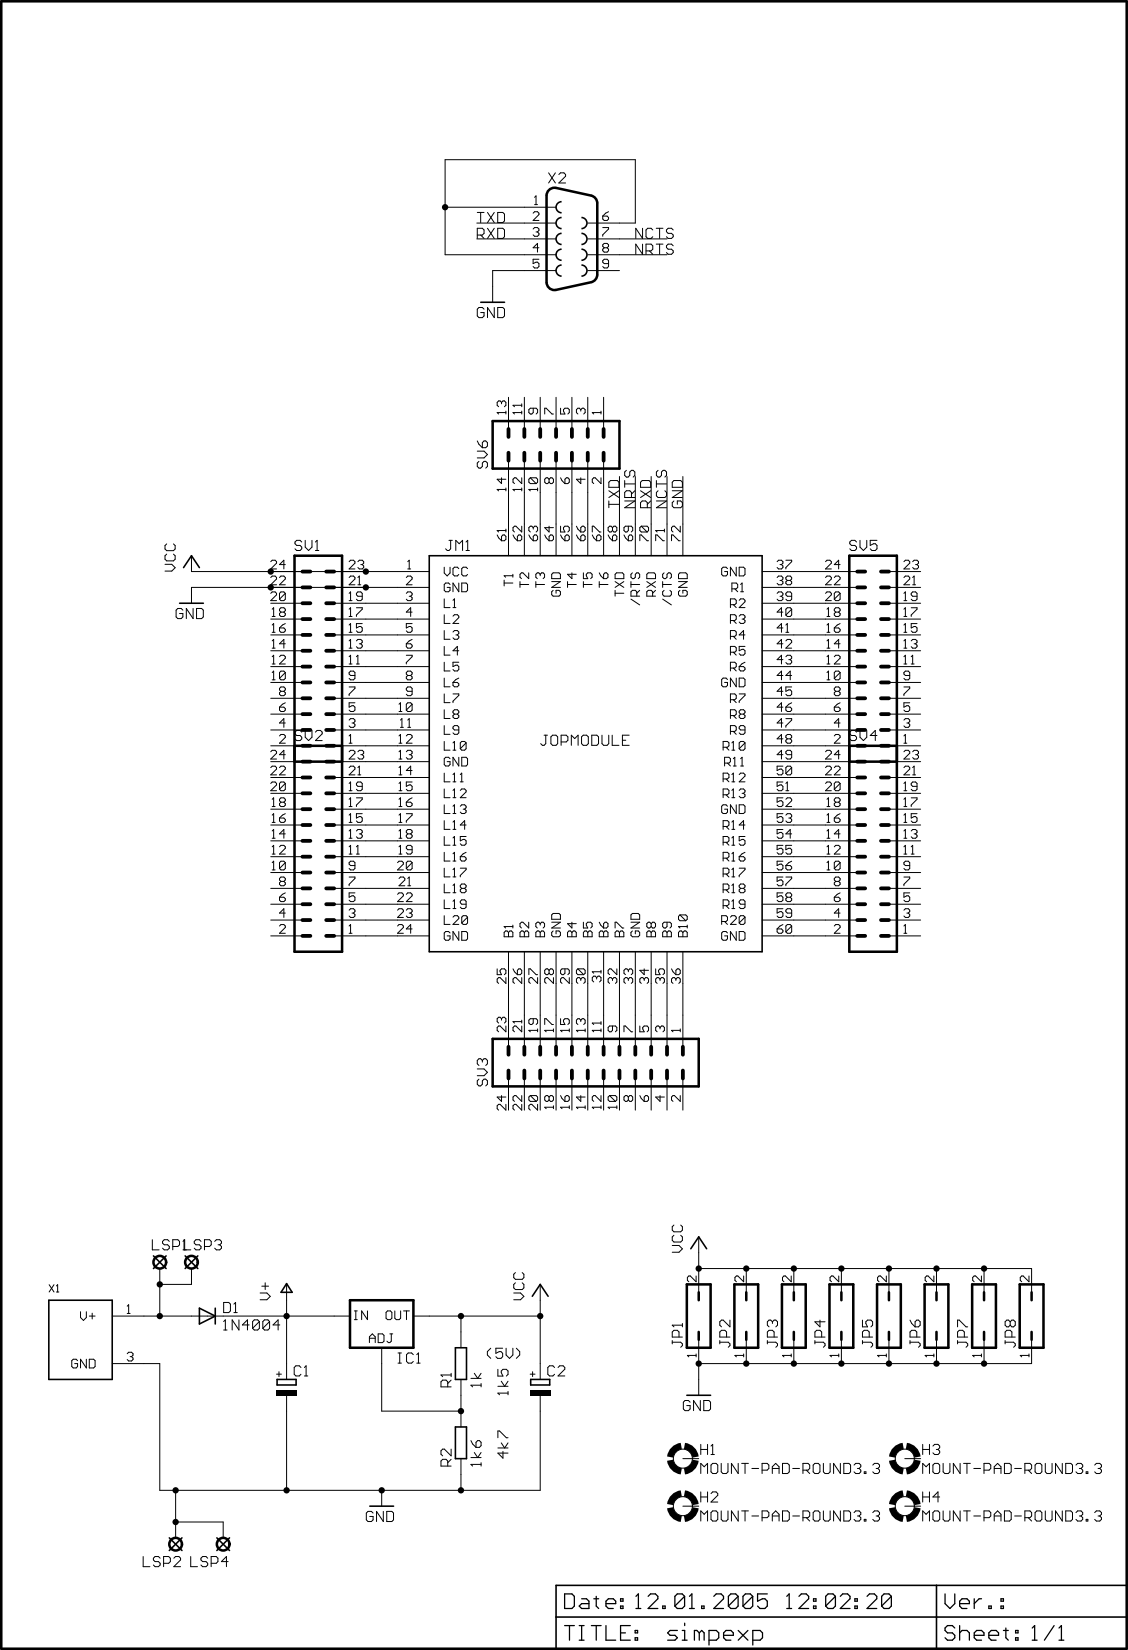
[picture p52: page 1]
