jop-devel/jop/doc/book/jvm/handles.pdf

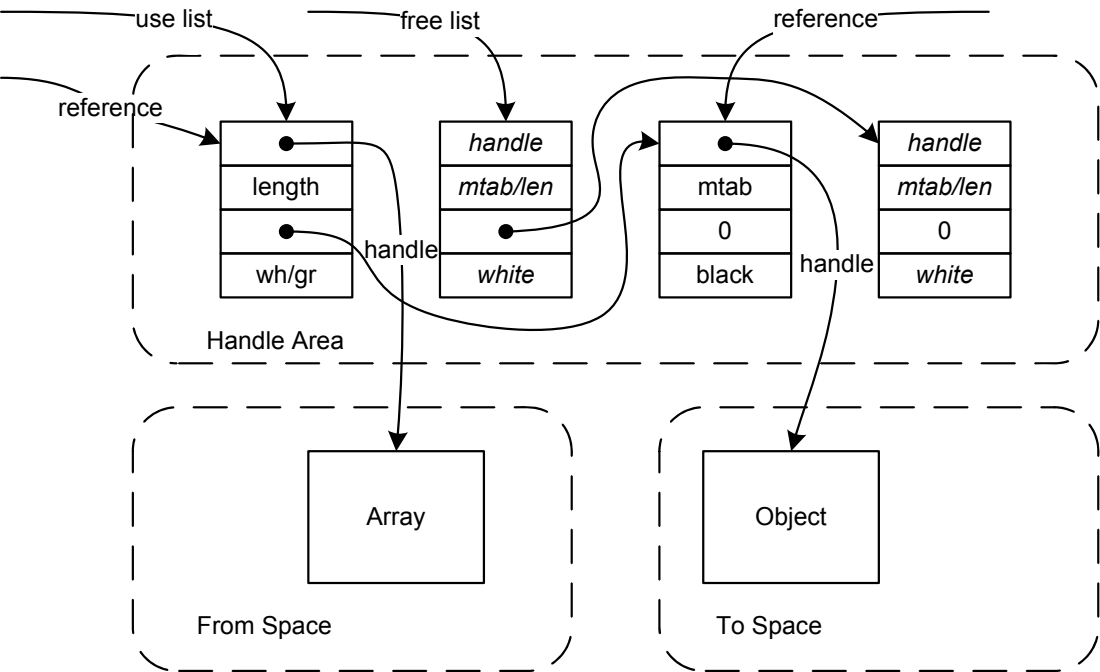
[picture p53: page 1]
length; Array; handle; mtab/len; white; mtab; black; Object; reference; use list; free list; From Space; To Space; Handle Area
