jop-devel/jop/doc/book/simpcon/ioport.pdf

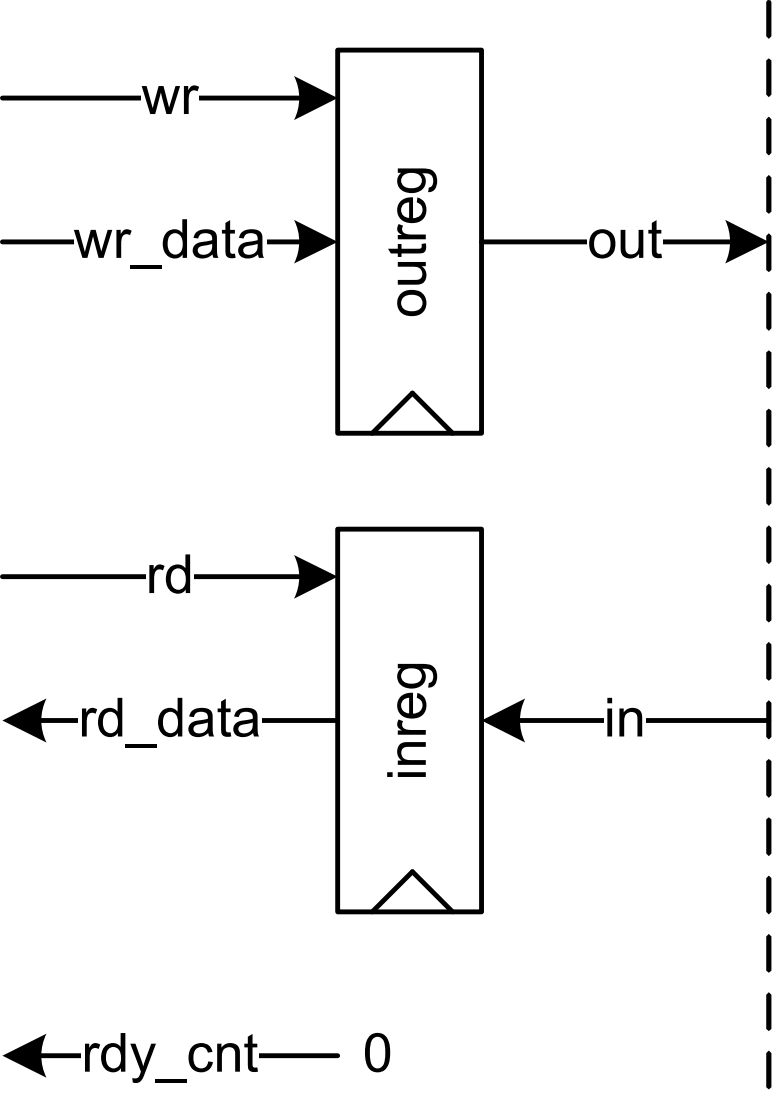
[picture p54: page 1]
outreg inreg; wr_data; rd_data; rdy_cnt; out
