jop-devel/jop/doc/book/simpcon/sc_pipe_level.pdf

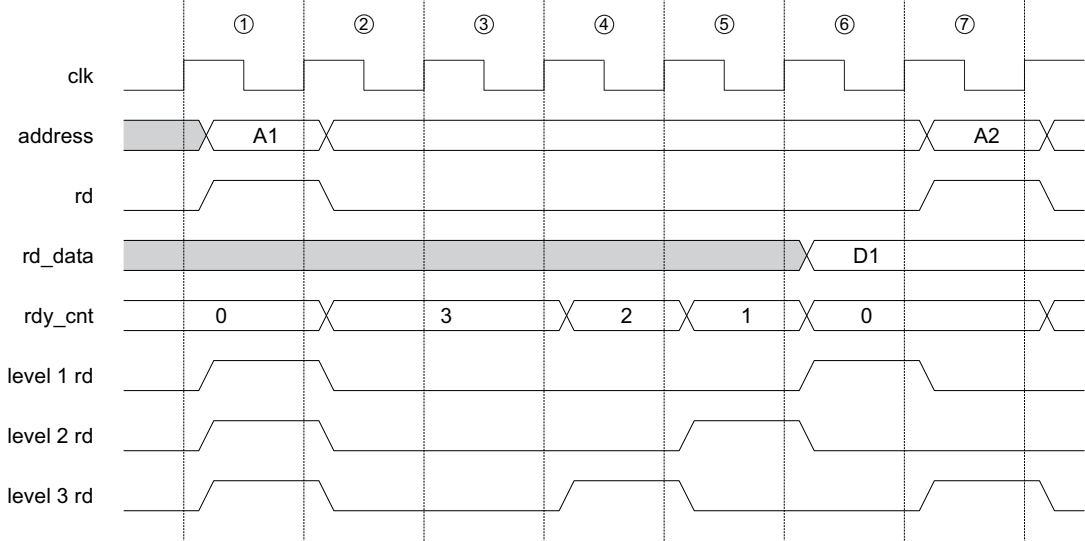
[picture p55: page 1]
clk; address; rd_data; rdy_cnt; level 1 rd; level 2 rd; level 3 rd
