jop-devel/jop/doc/book/simpcon/sc_sram.pdf

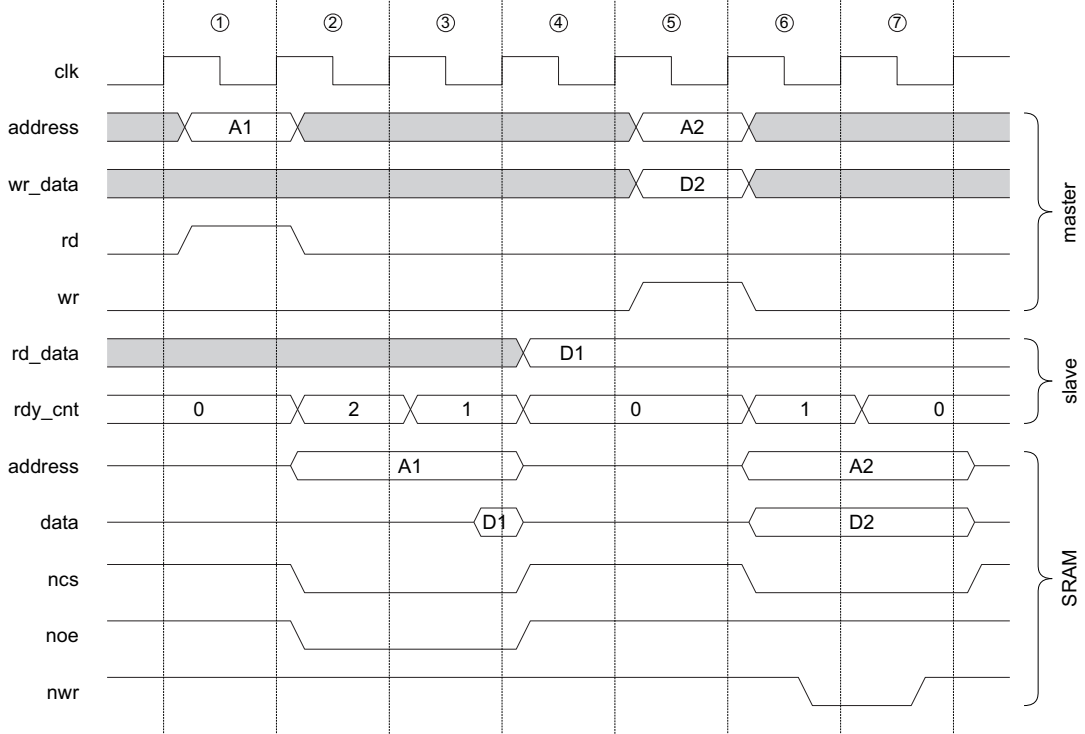
[picture p56: page 1]
clk; address; rd_data; rdy_cnt; wr_data; data; ncs; noe; nwr

master slave SRAM
