jop-devel/jop/doc/book/simpcon/sc_sram_prd.pdf

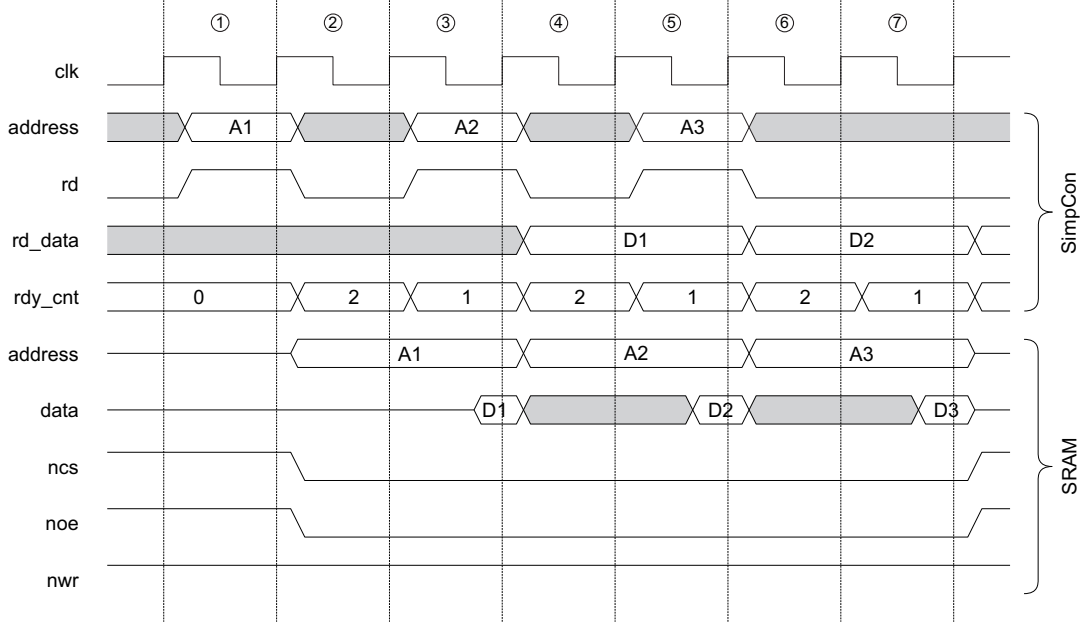
[picture p57: page 1]
clk; address; rd_data; rdy_cnt; data; ncs; noe; nwr; SimpCon SRAM 0 212121 D1 D2
