jop-devel/jop/doc/book/simpcon/wb_basic_rd.pdf

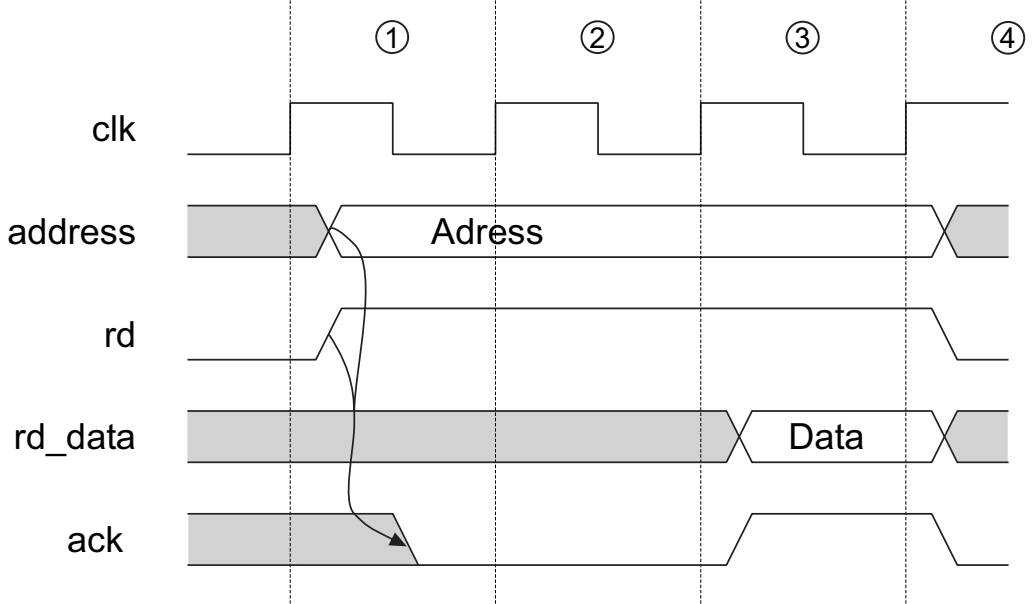
[picture p58: page 1]
Adress; Data; clk; address; rd_data; ack
