jop-devel/jop/doc/book/wcet/cache_split.pdf

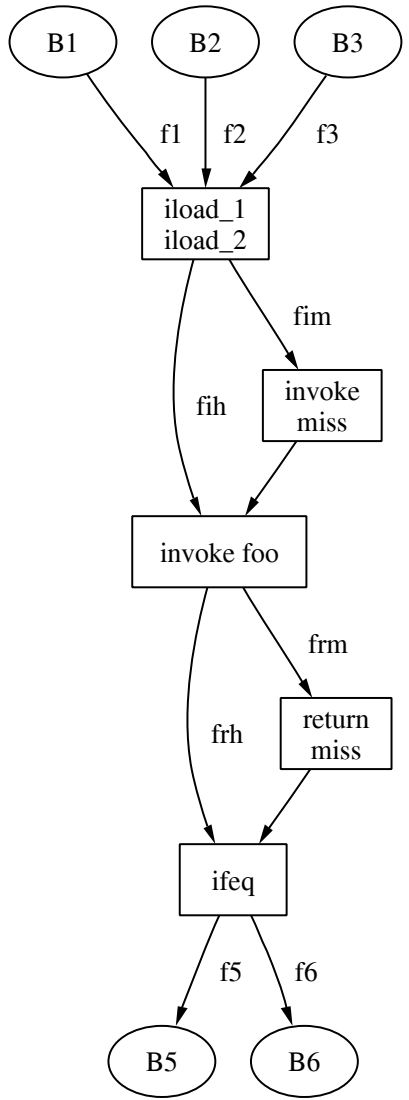
[picture p59: page 1]
iload_1 iload_2; invoke foo; fih; invoke; miss; fim; ifeq; frh; return; frm
