jop-devel/jop/doc/book/wcet/loop.pdf

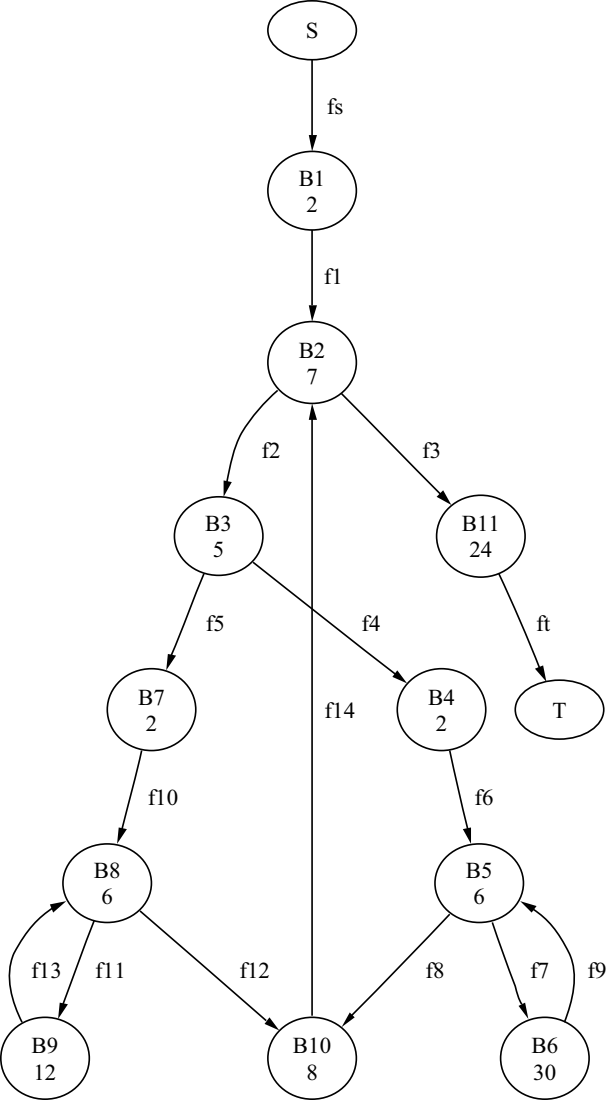
[picture p60: page 1]
