jop-devel/jop/doc/book/jvm/gc_ex1.pdf

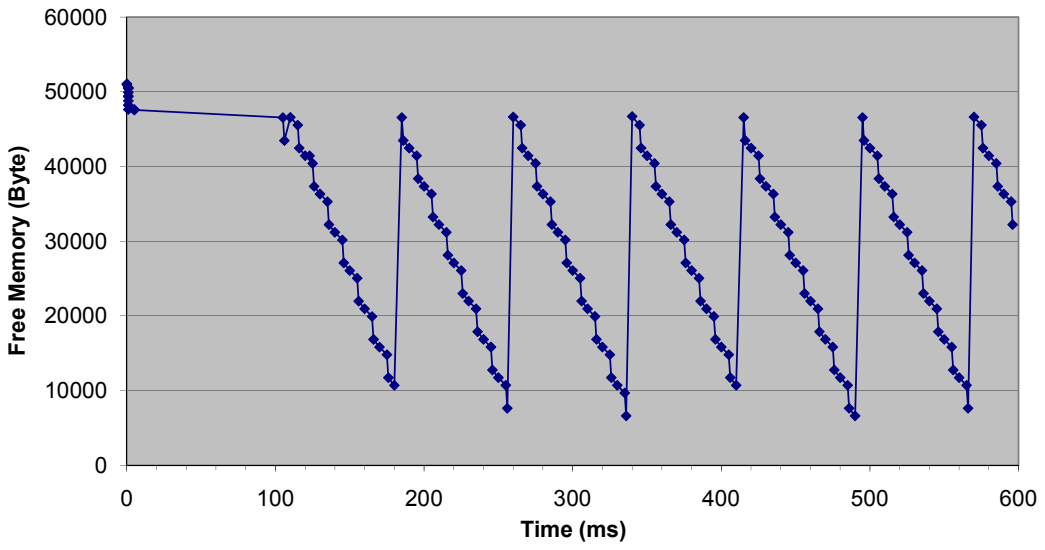
[picture p61: page 1]
ry (Byte); Time (ms)

Free Memory (Byte)
