jop-devel/jop/doc/book/jvm/gc_ex2.pdf

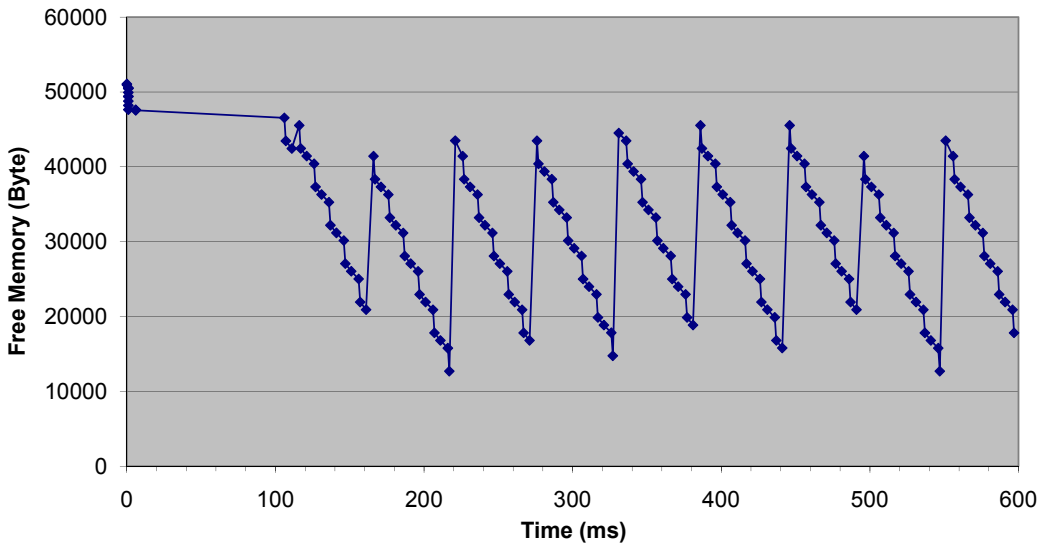
[picture p62: page 1]
ry (Byte); Free Memory (Byte); Time (ms)
