jop-devel/jop/doc/book/arch/arch_decaddr.pdf

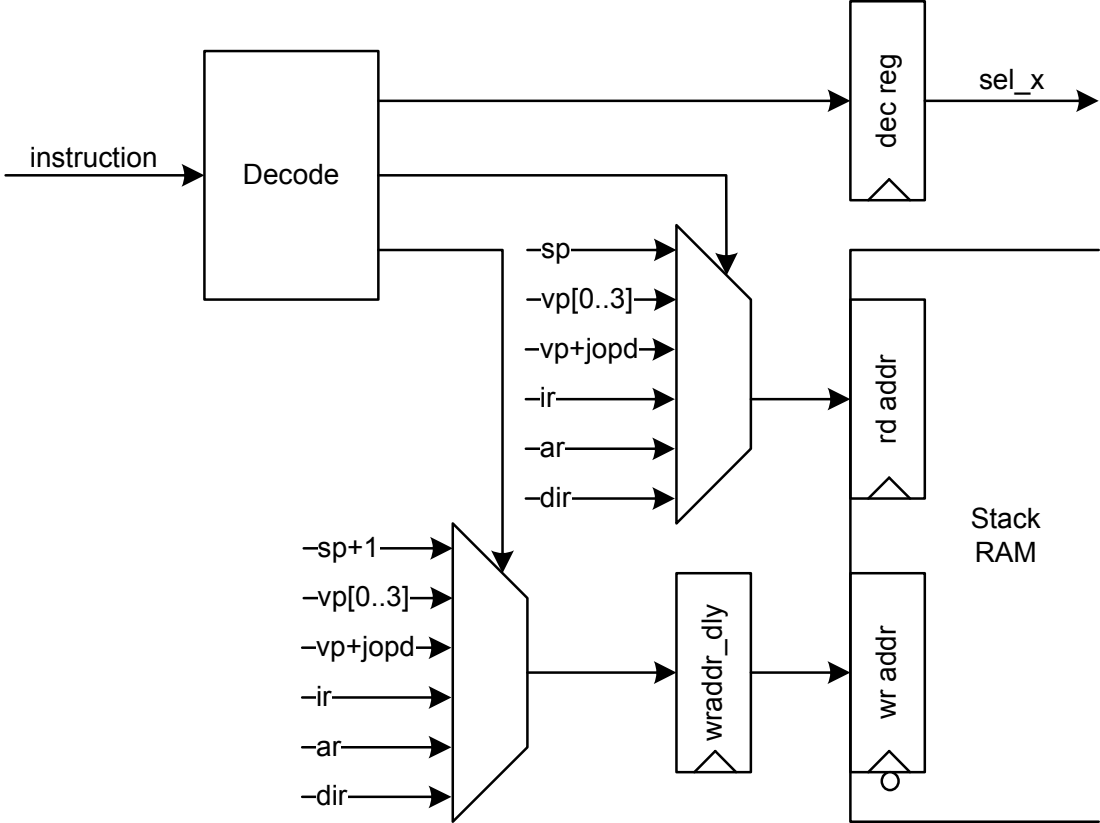
[picture p63: page 1]
Decode; vp+jopd; dir; wraddr_dly; instruction; sel_x; Stack RAM

dec reg rd addr wr addr
