jop-devel/jop/doc/book/arch/arch_execute.pdf

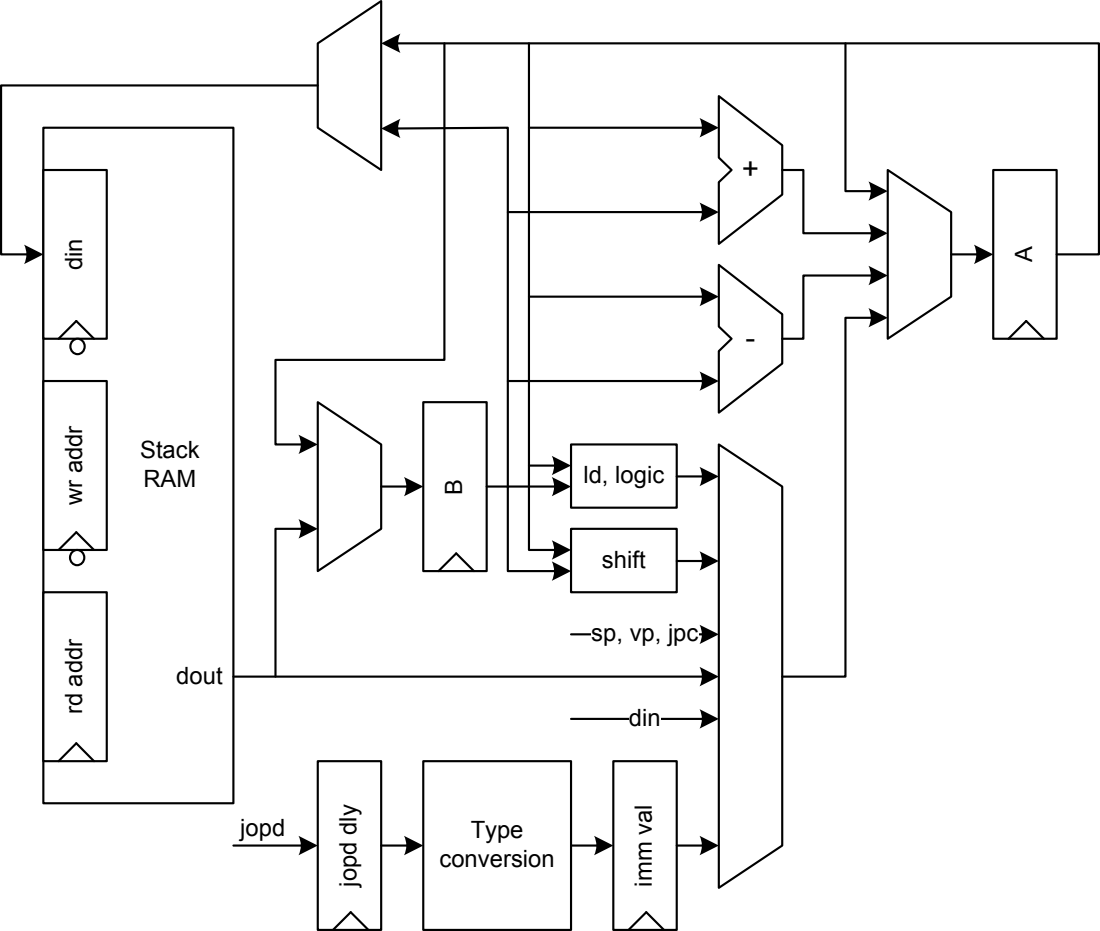
[picture p64: page 1]
Stack RAM; dout; din; B Type; conversion; jopd dly; jopd

din wr addr rd addr

ld, logic
shift imm val

sp, vp, jpc
