jop-devel/jop/doc/book/arch/arch_fetch.pdf

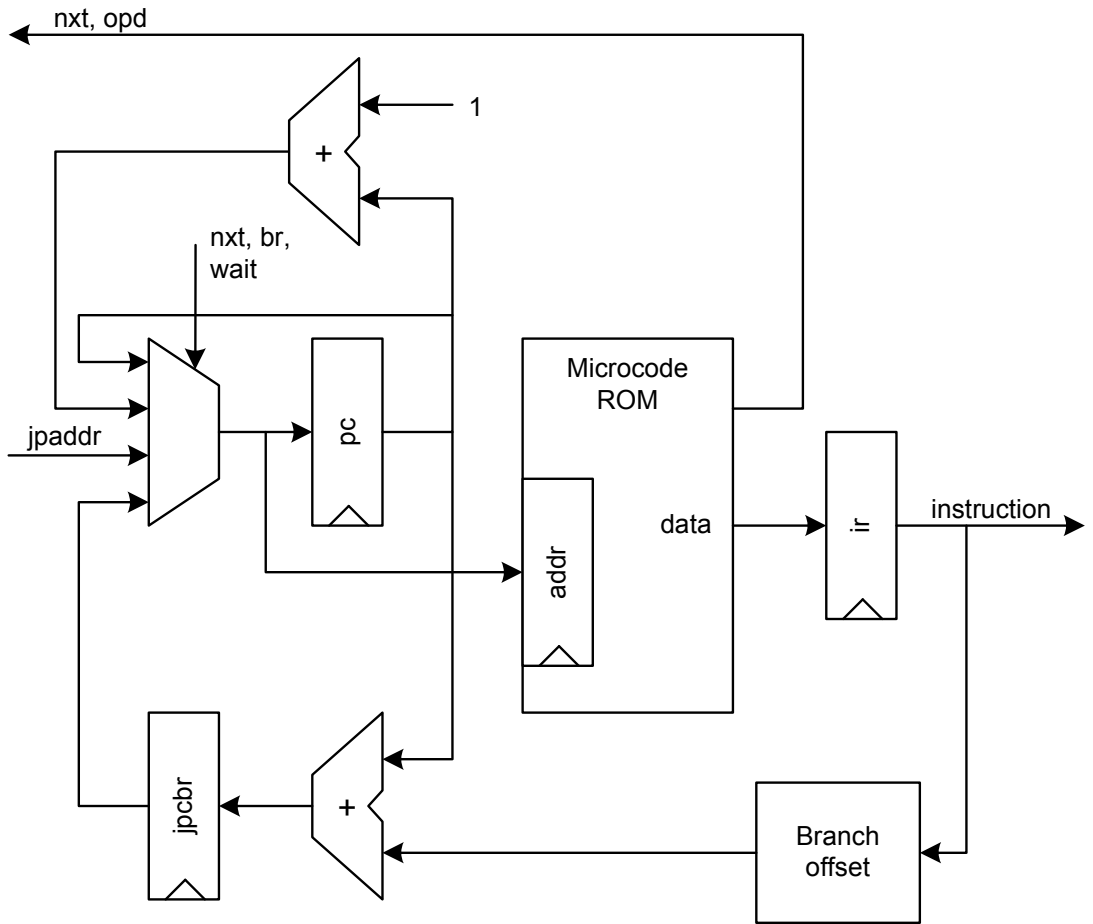
[picture p65: page 1]
jpcbr; Microcode ROM; addr; data; nxt, br, wait; jpaddr; Branch offset; instruction; nxt, opd
