jop-devel/jop/doc/book/arch/arch_meth300.pdf

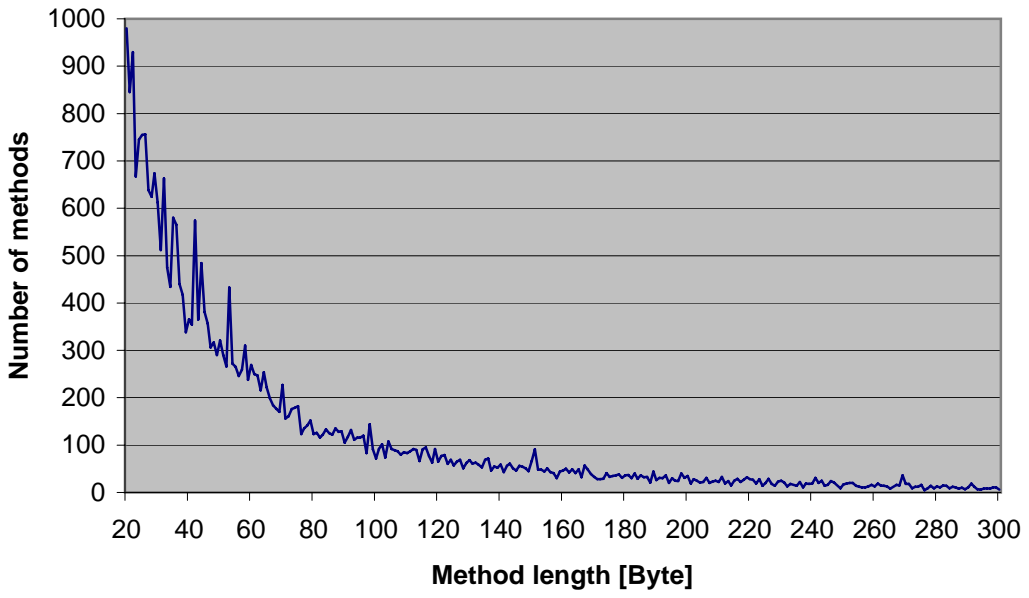
[picture p66: page 1]

Number of methods

Method length [Byte]
