jop-devel/jop/vhdl/top/jop_de2-70reprap.vhd

--
--
--  This file is a part of JOP, the Java Optimized Processor
--
--  Copyright (C) 2001-2008, Martin Schoeberl (martin@jopdesign.com)
--
--  This program is free software: you can redistribute it and/or modify
--  it under the terms of the GNU General Public License as published by
--  the Free Software Foundation, either version 3 of the License, or
--  (at your option) any later version.
--
--  This program is distributed in the hope that it will be useful,
--  but WITHOUT ANY WARRANTY; without even the implied warranty of
--  MERCHANTABILITY or FITNESS FOR A PARTICULAR PURPOSE.  See the
--  GNU General Public License for more details.
--
--  You should have received a copy of the GNU General Public License
--  along with this program.  If not, see <http://www.gnu.org/licenses/>.
--


--
--	jopmul_512x32.vhd
--
--	top level for a 512x32 SSRAM board (e.g. Altera DE2-70 board)
--
--	2006-08-06	adapted from jopcyc.vhd
--	2007-06-04	Use jopcpu and change component interface to records
-- 2010-06-25  Working version with SSRAM
-- 2012-02-27 Adapted for RepRap project
-- 2013-11-21 Working with ISLU


library ieee;
use ieee.std_logic_1164.all;
use ieee.numeric_std.all;
use ieee.std_logic_misc.all;

use work.jop_types.all;
use work.sc_pack.all;
use work.sc_arbiter_pack.all;
use work.jop_config.all;


entity jop is

generic (
	ram_cnt		: integer := 3;		-- clock cycles for external ram
--	rom_cnt		: integer := 3;		-- clock cycles for external rom OK for 20 MHz
	rom_cnt		: integer := 15;	-- clock cycles for external rom for 100 MHz
	jpc_width	: integer := 12;	-- address bits of java bytecode pc = cache size
	block_bits	: integer := 5;		-- 2*block_bits is number of cache blocks
	spm_width	: integer := 0;		-- size of scratchpad RAM (in number of address bits for 32-bit words)
	cpu_cnt		: integer := 4		-- number of cpus
);

port (
	clk				: in std_logic;
--
--	serial interface
--
	ser_txd			: out std_logic;
	ser_rxd			: in std_logic;
	oUART_CTS		: in std_logic;
	iUART_RTS		: out std_logic;

--
--	watchdog
--
	wd				: out std_logic;
	
--
--	LEDs
--
	oLEDR		: out std_logic_vector(17 downto 0);
--	oLEDG		: out std_logic_vector(7 downto 0);


	
--
--	Switches
--
	iSW				: in std_logic_vector(17 downto 0);
	
--
-- Expansion header
--
	GPIO_0	: inout std_logic_vector(31 downto 0);

--
--	only one ram bank
--
	oSRAM_A		 : out std_logic_vector(18 downto 0);		-- edit
	SRAM_DQ		 : inout std_logic_vector(31 downto 0);		-- edit
	oSRAM_CE1_N	 : out std_logic;
	oSRAM_OE_N	 : out std_logic;
	oSRAM_BE_N	 : out std_logic_vector(3 downto 0);
	oSRAM_WE_N	 : out std_logic;
	oSRAM_GW_N   : out std_logic;
	oSRAM_CLK	 : out std_logic;
	oSRAM_ADSC_N : out std_logic;
	oSRAM_ADSP_N : out std_logic;
	oSRAM_ADV_N	 : out std_logic;
	oSRAM_CE2	 : out std_logic;
	oSRAM_CE3_N  : out std_logic
);
end jop;

architecture rtl of jop is

--
--	components:
--

component pll is
generic (multiply_by : natural; divide_by : natural);
port (
	inclk0		: in std_logic;
	c0			: out std_logic;
	c1			: out std_logic;
	locked		: out std_logic
);
end component;


--
--	Signals
--
	signal clk_int			: std_logic;
	signal clk_int_inv		: std_logic;
	signal pll_lock			: std_logic;

	signal int_res			: std_logic;
	signal res_cnt			: unsigned(2 downto 0) := "000";	-- for the simulation

	attribute altera_attribute : string;
	attribute altera_attribute of res_cnt : signal is "POWER_UP_LEVEL=LOW";

--
--	jopcpu connections
--
	signal sc_arb_out		: arb_out_type(0 to cpu_cnt-1);
	signal sc_arb_in		: arb_in_type(0 to cpu_cnt-1);
	
	signal sc_mem_out		: sc_out_type;
	signal sc_mem_in		: sc_in_type;
	
	signal sc_io_out		: sc_out_array_type(0 to cpu_cnt-1);
	signal sc_io_in			: sc_in_array_type(0 to cpu_cnt-1);
	signal irq_in			  : irq_in_array_type(0 to cpu_cnt-1);
	signal irq_out			: irq_out_array_type(0 to cpu_cnt-1);
	signal exc_req			: exception_array_type(0 to cpu_cnt-1);

--
--	IO interface
--
	signal ser_in			: ser_in_type;
	signal ser_out			: ser_out_type;
	type wd_out_array is array (0 to cpu_cnt-1) of std_logic;
	signal wd_out			: wd_out_array;
	
	-- for generation of internal reset
-- memory interface

	signal ram_addr			: std_logic_vector(18 downto 0);
	signal ram_dout			: std_logic_vector(31 downto 0);
	signal ram_din			: std_logic_vector(31 downto 0);
	signal ram_dout_en	: std_logic;
	signal ram_clk			: std_logic;
	signal ram_nsc			: std_logic;
	signal ram_ncs			: std_logic;
	signal ram_noe			: std_logic;
	signal ram_nwe			: std_logic;
	
-- cmpsync

	signal sync_in_array	: sync_in_array_type(0 to cpu_cnt-1);
	signal sync_out_array	: sync_out_array_type(0 to cpu_cnt-1);

-- not available at this board:
	signal ser_ncts			: std_logic;
	signal ser_nrts			: std_logic;
	
-- remove the comment for RAM access counting
-- signal ram_count		: std_logic;

begin

	ser_ncts <= '0';
--
--	intern reset
--	no extern reset, epm7064 has too less pins
--

-- should also use PLL lock signal
process(clk_int)
begin
	if rising_edge(clk_int) then
		if (res_cnt/="111") then
			res_cnt <= res_cnt+1;
		end if;

		int_res <= not res_cnt(0) or not res_cnt(1) or not res_cnt(2);
	end if;
end process;

--
--	components of jop
--
	pll_inst : pll generic map(
		multiply_by => pll_mult,
		divide_by => pll_div
	)
	port map (
		inclk0	 => clk,
		c0	 => clk_int,
		c1	=> clk_int_inv,
		locked => pll_lock
	);
 --clk_int <= clk;
--clk_int_inv <= not(clk_int);
-- process(wd_out)
-- variable wd_help : std_logic;
-- 	begin
-- 		wd_help := '0';
-- 		for i in 0 to cpu_cnt-1 loop
-- 			wd_help := wd_help or wd_out(i);
-- 		end loop;
-- 		wd <= wd_help;
-- end process;

	wd <= wd_out(0);

	gen_cpu: for i in 0 to cpu_cnt-1 generate
		cpu: entity work.jopcpu
			generic map(
				jpc_width => jpc_width,
				block_bits => block_bits,
				spm_width => spm_width
			)
			port map(clk_int, int_res,
				sc_arb_out(i), sc_arb_in(i),
				sc_io_out(i), sc_io_in(i),
				irq_in(i), irq_out(i), exc_req(i));
	end generate;
	
	arbiter: entity work.arbiter
		generic map(
			addr_bits => SC_ADDR_SIZE,
			cpu_cnt => cpu_cnt,
			write_gap => 2,
			read_gap => 2,
			slot_length => 3			
		)
		port map(clk_int, int_res,
			sc_arb_out, sc_arb_in,
			sc_mem_out, sc_mem_in);

	-- io for processor 0
	io0: entity work.scio_main generic map (
			cpu_id => 0,
			cpu_cnt => cpu_cnt
		)
		port map (clk_int, int_res,
			sc_io_out(0), sc_io_in(0),
			irq_in(0), irq_out(0), exc_req(0),

			sync_out => sync_out_array(0),
			sync_in => sync_in_array(0),

			txd => ser_txd,
			rxd => ser_rxd,
			ncts => oUART_CTS,
			nrts => iUART_RTS,
			
			oLEDR => oLEDR,
--			oLEDG => oLEDG,
			iSW => iSW,
			--iSW => (others => '0'),		
			wd => wd_out(0),
			l => open,
			r => open,
			t => open,
			b => open
			-- remove the comment for RAM access counting
			-- ram_cnt => ram_count
		);
		
	-- io for processor 1
	io1: entity work.scio_eh generic map (
			cpu_id => 1,
			cpu_cnt => cpu_cnt
		)
		port map (clk_int, int_res,
			sc_io_out(1), sc_io_in(1),
			irq_in(1), irq_out(1), exc_req(1),

			sync_out => sync_out_array(1),
			sync_in => sync_in_array(1),

			GPIO_0 => GPIO_0,
						
			wd => wd_out(1),
			l => open,
			r => open,
			t => open,
			b => open
			-- remove the comment for RAM access counting
			-- ram_cnt => ram_count
		);
		
		
	gen_io: for i in 2 to cpu_cnt-1 generate
		io2: entity work.scio_small generic map (
			cpu_id => i,
			cpu_cnt => cpu_cnt
		)
		port map (clk_int, int_res,
			sc_io_out(i), sc_io_in(i),
			irq_in(i), irq_out(i), exc_req(i),

			sync_out => sync_out_array(i),
			sync_in => sync_in_array(i),
						
			wd => wd_out(i),
			l => open,
			r => open,
			t => open,
			b => open
			-- remove the comment for RAM access counting
			-- ram_cnt => ram_count
		);
	end generate;

	scm: entity work.sc_mem_if
		generic map (
			ram_ws => ram_cnt-1,
			addr_bits => 19
		)
		port map (clk_int, int_res,
			clk_int_inv,
			sc_mem_out, sc_mem_in,

			ram_addr => ram_addr,
			ram_dout => ram_dout,
			ram_din => ram_din,
			ram_dout_en	=> ram_dout_en,
			ram_clk => ram_clk,
			ram_nsc => ram_nsc,
			ram_ncs => ram_ncs,
			ram_noe => ram_noe,
			ram_nwe => ram_nwe
		);
		
		
	-- syncronization of processors
	sync: entity work.ihlu generic map 
	(
		cpu_cnt => cpu_cnt,
		lock_cnt => 32
	)
		port map
		(
			clock => clk_int,
			reset => int_res,
			sync_in => sync_in_array,
			sync_out => sync_out_array
		);
		
		
	process(ram_dout_en, ram_dout)
	begin
		if ram_dout_en='1' then
			SRAM_DQ <= ram_dout;
		else
			SRAM_DQ <= (others => 'Z');
		end if;
	end process;

	ram_din <= SRAM_DQ;
	
	-- remove the comment for RAM access counting
	-- ram_count <= ram_ncs;

--
--	To put this RAM address in an output register
--	we have to make an assignment (FAST_OUTPUT_REGISTER)
--
	oSRAM_A <= ram_addr;
	oSRAM_CE1_N <= ram_ncs;
	oSRAM_OE_N <= ram_noe;
	oSRAM_WE_N <= ram_nwe;
	oSRAM_BE_N <= (others => '0');
	oSRAM_GW_N <= '1';
	oSRAM_CLK <= ram_clk;
	
	oSRAM_ADSC_N <= ram_nsc;
	oSRAM_ADSP_N <= '1';
	oSRAM_ADV_N	<= '1';
	
	oSRAM_CE2 <= not ram_ncs;	
    oSRAM_CE3_N <= ram_ncs; 

end rtl;
