jop-devel/jop/vhdl/rttm/tm.vhd

--
--
--  This file is a part of JOP, the Java Optimized Processor
--
--  Copyright (C) 2009-2010, Peter Hilber (peter@hilber.name)
--  Copyright (C) 2009, Martin Schoeberl (martin@jopdesign.com)
--
--  This program is free software: you can redistribute it and/or modify
--  it under the terms of the GNU General Public License as published by
--  the Free Software Foundation, either version 3 of the License, or
--  (at your option) any later version.
--
--  This program is distributed in the hope that it will be useful,
--  but WITHOUT ANY WARRANTY; without even the implied warranty of
--  MERCHANTABILITY or FITNESS FOR A PARTICULAR PURPOSE.  See the
--  GNU General Public License for more details.
--
--  You should have received a copy of the GNU General Public License
--  along with this program.  If not, see <http://www.gnu.org/licenses/>.
--


--
--	Real-Time Transactional Memory
--

--
--	Transactional Memory
--

--
-- Provides SimpCon level 2 pipelining. Level 3 is not provided due to the
-- need to interleave regular memory accesses transparently with conflict
-- checks.
--
--
--
-- TODO
-- - SimpCon tm_cache flag is ignored on write
--


library ieee;
use ieee.std_logic_1164.all;
use ieee.numeric_std.all;

use work.sc_pack.all;
use work.sc_arbiter_pack.all;
use work.tm_pack.all;
use work.tm_internal_pack.all;


entity tm is

generic (
	addr_width		: integer;		-- address bits of cachable memory
	way_bits		: integer;		-- 2**way_bits is number of entries
	instrumentation	: boolean;
	ignore_masked_conflicts	: boolean
);
port (
	clk, reset		: in std_logic;
	
	from_cpu		: in sc_out_type;
	to_cpu			: out sc_in_type;
 	to_mem			: out sc_out_type;
 	from_mem		: in sc_in_type;
 	
 	-- tm_state_machine state
 	state			: in state_type;
 	broadcast		: in tm_broadcast_type;
 	-- tm_state_machine busy
 	rdy_cnt_busy	: in std_logic;	
	
	
	-- Events
	
	transaction_start: in std_logic;
 	conflict		: out std_logic;
 	
 	-- signal must be delayed by at least one cycle before being processed
 	-- to allow memory transaction to finish
 	commit_finished		: out std_logic;
	tag_full: out std_logic;

	
	-- Instrumentation
	
	read_set: out unsigned(way_bits downto 0);
	write_set: out unsigned(way_bits downto 0);
	read_or_write_set: out unsigned(way_bits downto 0)
);

end tm;
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
