jop-devel/jop/(commit log)

2004-02-19 IO definition for the BurchED board.
2004-09-13 inserted two nops at beginning.
2005-02-05 Thesis version
    [sim.cfg]
2005-02-05 Print out JOP version on start-up
2005-05-11 resync with current development
2005-06-09 added the (missing) bsy routing through extension
    [jop_xs3.vhd, jopcyc12.vhd]
2005-07-29 Updated for handle usage on thread switch (int2ext and ext2int)
2005-07-31 temporary use oebb project as test case
2005-07-31 moved to JVM test framework (package jvm)
2005-08-15 sp_ov for stack overflow detecion with a LED (e.g. wd LED)
2005-08-25 First version for new dspio board
2005-08-25 First version for the new dspio board
2005-08-27 remove assigenments to not used dummy power pins
2005-08-27 used JVMHelp.wr() in PrintStream for stdio
2005-10-19 Add a blinking LED
2005-10-19 Blink frequency 1HZ
2005-10-21 Ignore negative memory read/write for the new Wischbone devices
2005-11-25 Rasmus: print Interger.MIN correct
2005-12-01 SimpCon memory interface for Cycore board
2005-12-01 Memory mapped SimpCon IO devices are now standard
2005-12-02 Removed read register for upper bits (to avoid Quartus warning)
    [sc_uart.vhd]
2005-12-02 Added Flash interface (SimpCon) for the cycore board
2005-12-14 Disable interrupts on exit()
2005-12-28 One more decode bit to avoid write on USB port write
    [scio_min.vhd]
2005-12-29 nicer output, all three ADC
2005-12-29 Changed IO devices to SimpCon
2005-12-29 Correction to SimpCon memory interface
    [jop_xs3.vhd]
2005-12-30 moved the new for the synchronization object to a later stage to get the 'ni' message very early (even when the GC is not jet initialized).
2005-12-30 Split RtThread public class and RtThreadImpl JVM internal thread implementation
2005-12-30 Concurrent GC uses thread stacks for the roots
2006-01-12 HW/SW exceptions, additional ar for local memory addressing, sp and vp are effective 7 bits now (MSB fixed)
    [core.vhd, decode.vhd, jvm.asm, stack.vhd]
2006-01-12 HW for Exceptions (similar to interrupt)
2006-01-12 Limit stack trace to three methods
2006-02-11 root scan test case
2006-02-11 root scan test case - but with comments as the root info generation makes troubles
2006-02-18 Longer reset timing (tip from Arnim Laeuger) helps with the startup issue
    [ac97_defines.v]
2006-04-14 print version V1.0 at startup
2006-05-29 Smaller printout when threre are problems with LP.
2006-06-08 Special version with power off on modem init
2006-06-08 power off the modem
2006-06-17 added -mm switch
2006-06-17 print out WCET
2006-06-23 switch -> if
2006-06-25 Can "run" StartBenchUdpIp. Still an issue with zero in-flows.
2006-07-23 added a main to print out the bytecode timing
2006-08-06 Cyclone II PLL (for DE2 board)
2006-08-06 Altera DE2 board
2006-08-06 Altera DE2 board (16 bit SRAM)
2006-08-07 adapted to memory mapped UART
2006-08-10 signal for inverted clock (ModelSim issue)
    [aram.vhd]
2006-08-10 still not working (in the dynamic case)
    [sc_sram16.vhd]
2006-08-11 Configuraton for Alteras DE2 board (50 MHz)
2006-08-11 moved tcl to pins directory
    [DE2_pin_jopnames.csv, cycore.csv]
2006-08-11 top-level for DE2 board
2006-08-13 3 FFs on exd input pin to help Quartus for tsu
2006-08-17 ok with wait_state (1.2 was also ok with fixed ws) no din register, no cnt use
    [sc_sram16.vhd]
2006-10-06 board pictures for the Eclipse plugin
2006-10-25 remove dependency from j.l.Thread (only the constants have been used)
2006-10-26 change Thread.sleep to RtThread.sleepMs
2006-10-26 remove references to j.l.Thread (NORM/MAX_PRIORITY)
2006-10-29 longer method trace
2006-10-30 print SP on stack overflow
2006-10-31 Uses .rbf instead of the .cdf (chain is hardcoded)
2006-10-31 Uses .rbf instead of the .cdf (chain is hardcoded) at USBRunner
2006-11-18 print memory size in words
2007-03-07 dspio board without AC97 interface
2007-03-21 Xilinx ML401 board
2007-03-25 one cycle shorter read
    [sc2ahbsl.vhd]
2007-04-29 Correction of serial multiplyer bug
    [fpu.vhd]
2007-05-26 start a user manual
    [microcode.csv]
2007-05-30 now with three threads
2007-06-01 multiprocessor start inserted
2007-06-05 use rdy_cnt in scio devices, return "00" for USB device at address 2
2007-06-11 removed synch. on trace
2007-07-30 new GC test case
2007-08-04 constant for system device
2007-09-06 switch test
2007-09-09 additional register at RAM input to correct SimpCon violation
    [sc_sram16.vhd]
2007-09-09 Project for Altera DE2 board with SimpCon memory interface
2007-09-16 test case update
2007-10-06 test case for <clinit> order
2007-10-13 Port to Digilent nexys2 board
2007-10-15 top leve for cyclone 3 board from terasic
2007-10-25 Fixed some targets. Improved several comments, dependencies, paths, classpaths, labels and messages. Removed a few old targets and many unnecessary comments.
    Still need to sync with the Makefile, because currently this build.xml file
    does not launch jsim and JOPIzer.
    Tested targets: all, init, compile, rebuild, lib, HelloWorld, jdb, LogTest, clean.
    Also tested Class2HTML_1, Class2HTML_2, InsertNOPBytecodes,
    TestCodeTransformation and cleanHTML.
    But probably these will be removed in a near future.
2007-11-05 Handbook alpha edition
    [size.xls]
2007-11-21 more space for stack trace
2007-11-21 better trace also at stack overflow
2007-11-21 comment how to revert to a single method cache
    [cache.vhd]
2007-11-21 correction of the compare bug for difference > 2^31 (test jvm.Logic3)
    [stack.vhd]
2007-11-23 Switched from ConnectionService to SocketConnectionWrapper, to avoid dependency on Sun's internal classes.
2007-11-23 Switched from ConnectionService to SocketConnectionWrapper, to avoid dependency on Sun's internal classes.
    Constructor removed:
    77: public PacketInputStreamReader (ConnectionService connectionService) throws IOException
    Method changed:
    138: public synchronized PacketWrapper readPacket() throws IOException
2007-11-23 Switched from ConnectionService to SocketConnectionWrapper, to avoid dependency on Sun's internal classes.
    37: public PacketOutputStreamWriter (ConnectionService connectionService) throws IOException
    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
2007-11-23 Removed all references to Packet type, to avoid dependency on Sun's internal classes.
    107: public static void printInfo(PacketList list, int numPackets)
    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
2007-11-29 Changed a few method signatures and added some new ones.
    Methods changed:
    130: private boolean isConnected()
    155: public void sendExitCommand(int exitCode) throws IOException
    191: public void sendResumeCommand() throws IOException
    Methods created:
    271: public int printStackFrames() throws IOException
    287: public int printStackFrame(int frameIndex) throws IOException
    398: public int getNumberOfLocalVariables(int frameIndex) throws IOException
2007-11-29 Change to help during code development. Added methods and constants to provide a very basic (but still interactive) debug interface, to be used during the development of the JopDebugKernel class.
    - Added constants to control testing
    - Added methods to request more information from JOP
    - Changed main() to allow running both an automatic and
    an interactive set of tests.
    - Added methods to change the way printing is being done,
    to avoid issues with Ant (need to flush() for every print()).
    89: public static void main(String[] args) throws IOException
    634: public void testJopSimCommunication(String symbolFile) throws IOException, ClassNotFoundException
    - Changed test se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
2007-11-29 Added one more test target to the build file. Changed one target to behave better in case of a failure.
    Targets changed:
    349: <target name="PacketPrinter" depends="copyJDWPLogs,lib"
    - Changed order of commands so if this target fails it's easy
    to know how to check the failure reason.
    489: <target name="TestJopServer" depends="compile, lib"
    - Refactored to use a new macrodef, which is shared
    with another target.
    Targets created:
    495: <target name="TestJopServerInteractively" depends="compile, lib"
    Macros created:
    501: <macrodef name="launchTestJopServer">
2007-12-02 Move most interrupt logic to sc_sys. Interrupt ack from jfetch, interrupt disable on handling.
2007-12-03 new interrupt controller
2007-12-06 interrupt handling in Java
2007-12-07 redesign of global lock synchronization
    [cmpsync.vhd]
2007-12-08 interrupt handler stuff
2007-12-08 interrupt handler stuff - use system HW object
2007-12-11 Changed in order to accept different tokens as stream ID's. Changed some static methods.
    Constructors changed:
    67: public EmbeddedOutputStream (OutputStream outputStream)
    72: public EmbeddedOutputStream (PrintStream outputStream)
    79: public EmbeddedOutputStream (PrintStream outputStream, String token)
    80: public void write(int data) throws IOException
    103: public void testEmbeddedOutputStreamSendBytes()
    125: public void testEmbeddedOutputStream()
    142: public void writeByte(byte data)
    157: public void writeInt(int data)
    174: public void printIntHex(int data)
    185: public static void printIntHex(int data, PrintStream stream)
    193: public void printHex(byt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
2007-12-11 Small changes to make the internal token dynamic. That may allow more than one filter to be connected in sequence.
2007-12-12 Some methods created to help during event creation and request handling.
    One small fix on the createEventHeader (from fixed to dynamic suspendPolicy).
    Changed the default thread ID. Some other changes.
    169: private void writeDefaultThreadId()
    212: private void writeTypeTag(int typeTag)
    241: private void writeEventKindAndRequestId(int eventKind, int requestId)
    260: private void createEventHeader(int events, int suspendPolicy)
    277: private synchronized void sendPacket() throws IOException
    Methods added:
    303: private synchronized void createEmptyReplyPacket() throws IOException
    314: private synchronized void createEmptyReplyPacket(int errorCode) throws IOExcept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
2007-12-13 Some changes to make this class more flexible. Now it can read and write JDWP packets from any kind of InputStream and OutputStream, and not only from a network socket.
    Methods changed or created:
    101: public PacketWrapper receivePacket() throws IOException
    112: public static PacketWrapper receivePacket(DataInputStream input) throws IOException
    183: public void sendPacket(PacketWrapper packet) throws IOException
    204: public static void sendPacket(PacketWrapper packet, DataOutputStream output)
2007-12-18 Methods added: 150: public static void print(int data) 157: public static void println(int data)
2007-12-18 Added a method to return if there's an error status. Changed the way the packet is printed, to show the error code, in case of reply packets.
    Method added:
    304: public boolean hasNoError()
    310: public void printInformation(PrintStream stream)
    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
2007-12-18 Added some methods and fixed a bug on the code for setFlags.
    206: public synchronized void skipBytes(int numBytes)
    438: public boolean hasNoError()
    657: public void printPacketHeader(PrintStream out)
    662: public static void printPacketHeader(JavaDebugPacket packet, PrintStream out)
    369: public synchronized void setFlags(int value)
    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
2007-12-18 Methods added: 224: private void writeFieldId(int fieldId) 234: private void writeObjectId(int objectId) 240: private void writeFrameId(int frameId) 401: public synchronized void sendReplyGetLocalVar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
2007-12-18 Added a few more tests, including to set/clear breakpoints and to get the list of stack frames. Changed the class to ask if it should retry, when the server is not yet available. Some constants were 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
    108: public static void main(String[] args) throws IOException
    180: public void testJopDebugKernelInteractively(String symbolFile,
    181: BufferedReader reader) throws IOException,ClassNotFoundException
    563: private void printCommandMenu()
    788: public void testJopSimCommunication(String symbolFile, BufferedReader reader)
    789: throws IOException, ClassNotFoundException
    1030: private void initialize(String symbolFile, BufferedReader reader)
    421: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
2007-12-19 Changed some methods to send all ID's as 4 byte values.
    180: private void writeThreadId(int threadId)
    218: private void writeClassId(int classId)
    234: private void writeObjectId(int objectId)
    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
2007-12-22 test case for RTAS measurement issue
2008-01-09 CMP for Altera DE2 Board
2008-01-14 SPI interface for the SD card
2008-01-14 SPI device from OC (adapted)
2008-01-18 Changes to add support for get/set operations on instance fields.
    449: private void interactiveTestGetInstanceVariable(BufferedReader reader)
    477: private void interactiveTestSetInstanceVariable(BufferedReader reader)
    185: public void testJopDebugKernelInteractively(String symbolFile,
    186: BufferedReader reader) throws IOException, ClassNotFoundException
    692: private void printCommandMenu()
    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
2008-01-30 changed to single thread test
2008-02-02 FPU with dspio board
2008-02-06 Changed test case so it only fails if something is broken.
2008-02-06 Adding test case for invokespecial.
2008-02-07 - Changed breakpoint: selections now use static final constants - Added two methods to get information from the class structure - Changed "printClassHeader" to use new methods to access class info
    124: public static final void breakpoint()
    2811: private static final void printClassHeader(int classPointer)
    1138: private static int getGCInfo(int classReference)
    1148: private static int getPointerToInterfaceTable(int classReference)
    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
2008-02-13 A single switch for USB configuration + some cleanup
2008-03-04 correct error in MUX selection
    [jopcpu.vhd]
2008-03-04 corrected MUX selection of SimpCon slaves (mem, scratchpad, IO)
    [jopcpu.vhd, jvm.asm]
2008-03-04 correction for pipelined mux selection
    [jopcpu.vhd]
2008-03-10 interrupt enable after the interrupt handlers
2008-03-11 global interrupt enable in bcfetch (bug fix)
    [bcfetch.vhd, jop_types.vhd, jvm.asm, sc_sys.vhd]
2008-04-04 More useful error messages.
    [compat.c]
2008-04-15 adapt to faster imul
2008-04-16 exectuion time printout
2008-05-02 Document added microcodes stgf, stpf and stcp.
    [microcode.csv]
2008-06-11 removed remaining System.out.print(). Constants for 100 MHz (prime numbers)
2008-06-20 CPU count from sys device
2008-06-23 schedule 400 threads
2008-06-23 A real-time thread version of CMP Hello World
2008-06-25 Fixed method cache/program counter bug.
    [bcfetch.vhd, core.vhd, stack.vhd]
2008-07-03 A bunch of small fixes (error handling, division, stringification of integers).
    [jvm.asm]
2008-07-21 SRAM interface correction - longer data out enable
    [jvm.asm, sc_sram32_flash.vhd]
2008-07-21 reset TOS and NOS register A and B
    [stack.vhd]
2008-07-22 15 cycle slot
2008-07-22 correct data out enable
    [sc_sram32.vhd]
2008-08-07 Removed combinatorial loop (pipelined bug)
    [sc_arbiter_fair.vhd]
2008-08-09 no copy of real devices
2008-08-09 Debugging software driver.
2008-08-15 starter kit: pin changes to match board layout
2008-08-19 skit: cr/lf fixed, hopefully
    [scio_skit.vhd]
2008-08-21 fixed wait states are removed
    [sc_sram16.vhd, sc_sram32.vhd, sc_sram32_flash.vhd]
2008-10-10 correct array access for fast (SPM) memory (+iald23 state)
    [mem_sc.vhd]
2008-10-11 querry and check current thread for local scope
2008-10-14 same time-slot constant for each core
2008-10-16 Moved transitive hull loading and consolelayout to libgraph
2008-10-16 Added transitive hull loader Simplified classname checking and loading added Helloworld demo
2008-11-04 Initial import: New Implementation of the WCET Analysis. Location: com.jopdesign.wcet08.*. External Libraries: java/lib/jgrapht-jdk1.5.jar (lpgl). Dependency: apache velocity (not in CVS).
2008-11-06 DispatchI.java: test case for WCET analysis when there are interface/virtual invokes. Note: Currently JOPizer fails to build it.
2008-11-09 removed sysout print in the RT loop
2008-11-10 can do both normal run and RT run (but WCA stalls)
2008-11-10 print execution time
2008-11-11 wcet: Fix bugs in callgraph/flowgraph. Add DispatchViaException test case. Add TODO file.
2008-11-13 Add Loop bound DF Analysis to wcet08. Add test case test:wcet.LoopBoundTest. Fixed bug in cfg+SelectInstruction. Loop bounds now support lower and upper bound.
2008-11-14 a CMP test case with UDP/IP
2008-11-15 a CMP test case with UDP/IP - the non-scaling version
2008-11-27 Fix retrieval of bounds, making printResults() unnecessary.
2008-11-27 Add current directory to java.library.path for wcet/wcet08.
2008-12-01 wcet08: - Added UppAalTranslation executable - Added ExecHelper for reusable parts in analyzer executables - Initial Import: UppAal translation (wcet08.uppaal.translation) - Initial Import: UppAal XM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
2008-12-01 Deactivate insertSplitNodes(). It isn't neccessary, and UppAal is faster without them.
2008-12-05 change interrupt handling
2008-12-06 Correct interrupt handler registration for CMP version
2008-12-06 Enable interrupts again after invoking the handler
2008-12-06 Print the interrupt trigger
2008-12-06 print nr of CPUs
2008-12-06 Correction of interrupt handling
2008-12-09 wcet08: uppaal translation: Implementation of N-Block LRU, FIFO and Var-Block FIFO caches graphutils: Fixed (broken) Topological Order Traversal appinfo: Use DFA receiver analysis results config: Swi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
2009-01-09 remove debug print
2009-01-12 SLIP via dspio board
    [scio_usbser.vhd]
2009-01-18 public test case
2009-02-14 Add a 'delegator pattern' test case for dataflow analysis (works very nice).
2009-02-14 WCET example: Threads modifying a variable complicate receiver type analysis. Currently, the DFA analysis fails with a ConcurrentModificationException
2009-02-16 Fixing bug in thread-handling.
2009-02-19 Fixing slot generation.
2009-02-19 Fixing slot generation again.
    [sc_arbiter_tdma.vhd]
2009-02-23 correct Flash addresses for Cycore board
2009-02-23 wcet08 -> wcet: Adapt Makefiles and Velocity
2009-02-28 some updates plus new data flow figure
2009-03-01 not used
    [sim.cfg]
2009-03-08 A replacement for mem_sc.vhd
    [mem_sc_new.vhd]
2009-03-08 Reverting to version 1.21
    [mem_sc.vhd]
2009-03-20 wcet: loopcoloring: loop nest forest -> loop nest DAG. control flow graph: add transformer 'insertContinueLoopNodes' (easier for model checking) control flow graph: backlink to Project misc utils: pa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
2009-03-24 Surround Thread.sleep() with try-catch block
2009-03-31 wcet/graphutils: linear subgraphs and topological order helper utilities. Generalized loop coloring to arbitrary flow graphs.
2009-04-01 wcet/report: Fix long standing index.html bug: frameset tag must not be enclosed by body.
2009-04-13 does not fit into the jbe framework
2009-04-15 Update for analysis framework.
2009-04-16 wcet/frontend: - Improve handling of dead/stuck code due to exceptions - Fix handling of exceptions (exceptions edges are currently NOT added to the control flow graph) - Fix a bug in graphutils/domi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
2009-04-18 tools/tools: Add queries (isStackConsumer,isStackProducer) and printTable() to Instruction.
2009-04-24 timing: CMP timing, currently delgating to WCETInstruction.
2009-05-09 Fix loopbound for mrtc's InsertionSort.java
2009-05-09 wcet: correct annotation in InsertSort
2009-05-17 handbook green book correction of RTGC chapter
    [gc_test.xls]
2009-05-23 rttm: non-priority encoder for the hit line
2009-06-01 handbook: interrupt section
2009-06-02 handbook: new datapath figure fue to printing issue
2009-06-04 ML401 board works with ram_cnt = 3.
2009-06-04 Altera DE2-70 board
2009-06-08 handbook: additional schematics in the appendix
2009-06-08 handbook: update size and performance sections
    [perf.xlsx, size.xls]
2009-06-08 Heads up: New timing package integrated into WCET analysis. The idea is that the timing package is only concerned with instruction and basic block level timing information, while the WCET package cal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
2009-06-08 FIX: repair mrtc/InsertionSort (bad merge)
2009-06-10 HW matches timing of WCA model. Bug fix in mac_coprocessor.
    [build.py, mac_coprocessor.vhd, sc_control_channel.vhd]
2009-06-11 Added new co-processor with "bitcount" and "maxsearch" hardware methods. Change to build.py in attempt to ensure that all local variables have to be accessed by iload/istore rather than iload_3/istor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
    [bitcount_maxsearch.vhd, build.py, jop_ml401cmp.vhd]
2009-06-11 New WCET examples. Bug fixes.
    [build.py, sc_control_channel.vhd]
2009-06-15 sdcard: Major cleanups. Still to do: - pride means to delete file, create directories, etc. - make code thread-safe - interface to other HW (e.g., flash memory) - torture testing httpserver: Changes 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
2009-06-19 Add deadline I/O device
2009-06-26 Fixing implementation of invokesuper.
    [jvm.asm]
2009-07-13 wcet: print out mtab, constant address
2009-07-15 CMP execute framework start
2009-07-23 JOPizer: switch to BCEL 5.2, fix class loading in BCEL
2009-07-25 lego explorer: fix button semantics, clean up imports, refactor drive
2009-07-25 lego explorer: fix clockwise/counterclockwise state switch
2009-07-29 svm: Iris Flower Data Set
2009-07-29 sync for TDMA with 6 cycles slots added
2009-07-30 build: When printing link info, also print mapping of constants
2009-07-30 cache analysis prototype: some fixes to resolve addresses correctly
2009-08-18 jvmtest: add test case for array exceptions
2009-08-23 rttm: commit logic, fix compilation errors.
    [tag.vhd, tm.vhd]
2009-08-24 jvm: use I/O device for null pointer and array bounds exceptions
2009-08-24 jvm: reorder code for shorter branch distances
    [jvm.asm]
2009-08-26 rttm: simulation framework for TM, changes to TM.
2009-08-26 sc_sram32_flash.vhd: fixed sensitivity lists
    [sc_sram32_flash.vhd]
2009-08-27 rttm: fixed bug in testbench memory access.
    [tm.vhd, tm_pack.vhd]
2009-08-29 rttm: misc. corrections and enhancements to check-in.
    [jopcpu.vhd, joprttm.vhd, tm.vhd, tm_pack.vhd]
2009-09-01 rttm: Fixed: use internal clock signal.
    [joprttm.vhd]
2009-09-05 jvm: changed microcode instruction encoding
    [microcode.csv]
2009-09-06 tools: print out bytecode length in VHDL syntax
2009-09-14 rttm: don't abuse reset signal.
    [tag.vhd, tm.vhd]
2009-09-20 rttm: justify transaction coordinator timing, correct bug in early commit code, simulation.
    [tm.vhd, tm_coordinator.vhd]
2009-09-20 rttm: Fixed wrong timing of commit line increment.
    [tm.vhd]
2009-09-23 rttm: avoid control hazards on commit.
    [tag.vhd, tm.vhd]
2009-10-03 de2-70: correct compile errors
    [scio_min_DE2-70.vhd]
2009-10-03 100 MHz default for DE2 boards
2009-10-03 Add jvmtest docu
    [Instructions.xls]
2009-10-17 ptolemy: add SDF driver main and an example model
2009-10-21 DFA/WCET: Changes for worst-case allocation rate computation.
2009-10-23 rttm: correct rdy_cnt generation, remove unnecessary state machine state.
    [tm.vhd, tm_internal_pack.vhd]
2009-10-25 rttm: correct duration of tm commands.
    [tm.vhd, tm_internal_pack.vhd]
2009-11-01 rttm: prototype of method transactionalizer.
2009-11-04 rttm: fix hardware bug.
    [tm.vhd]
2009-11-07 rttm: track read and write set.
2009-11-14 VHDL: correct sensitivity list
    [fetch.vhd, ocache.vhd]
2009-11-16 Timing info for new getfield version
    [microcode.csv]
2009-11-23 JOP pipeline: move MMU decode from jopcpu/extension to decode.vhd
    [microcode.csv]
2009-11-24 JOP pipeline: HW support in MMU for get/putstatic
    [microcode.csv]
2009-11-24 Start with performance docu
    [perf.xlsx]
2009-11-29 Update performance figures
    [perf.xlsx]
2009-12-01 Makefile: correct classpath for JOPtimizer (BCEL 5.2 class loading bug)
    [perf.xlsx]
2009-12-04 Xilinx: start project files for the ML50x board
2009-12-05 Xilinx: more on the ml50x board
2009-12-27 ocache: add test case for I/O cache disable
2009-12-28 ml50x: disbale SSRAM pins for blink tests. Still not working, FPGA gets hot!
    [jop_ml50x.vhd]
2010-01-05 dfa: Add a symbolic, local Points-To Analysis. Cannot handle heap modifications. Currently does not handle arrays.
2010-01-06 Makefile/wcet: add current directory for the Mac to find lp_solve
2010-01-07 wcet: add a generic pretty printer for dicitionaries
2010-01-13 rttm: Don't update rd_data too early. Hack for wrong exception in mem_sc.
    [mem_sc.vhd, tm.vhd]
2010-01-14 rttm: Better hack for wrong exception in mem_sc.
    [mem_sc.vhd]
2010-01-15 rttm: Avoid lock usage and read set exhaustion during accesses to references.
    [jvm.asm]
2010-01-19 rttm: Fixed data hazard due to conflict detection.
    [tm.vhd]
2010-01-19 vhdl: correct component lable to start with a character
    [lego_motor.vhd]
2010-01-24 rttm: Fix rdy_cnt to CPU.
    [tm.vhd]
2010-01-24 rttm: Shorten rd miss by one cycle.
    [tm.vhd]
2010-01-26 rttm: Replace explicit megafunction instantiation.
    [tm.vhd]
2010-01-26 rttm: Revert changes for resource measurements.
    This reverts commit 7cf39dd75a29dd0d370737dec53cdd9d72f67f7b.
    Conflicts:
    vhdl/top/jop_de2-70rttm.vhd
    [decode.vhd, joprttm.vhd, mem_sc.vhd]
2010-03-03 UART supports parity bits now.
2010-03-11 testmon: fix short branch distances with new jmp microcode
    [testmon.asm]
2010-03-15 rttm: use slots of CPUs executing transaction for commit.
2010-03-19 Set parity to none on reset
    [sc_uart.vhd]
2010-03-28 rttm: avoid zombie exceptions.
    [sc_sys.vhd]
2010-03-29 Fixing UART.
2010-03-30 rttm: fix wrong rdy_cnt.
    [tm.vhd]
2010-04-24 2KB min. method cache, fake methods in Thread and Object
2010-04-24 A java.lang.Thread class that works only on a CMP version of JOP
2010-04-25 rttm: fix compilation errors, addenda, move rdy_cnt generation out of critical path.
    [mem_sc.vhd, tm_state_machine.vhd]
2010-04-25 rttm: fix atomic.java case, step 1
2010-04-25 rttm: fix atomic.java case, step 2
2010-04-25 rttm: fix dspio board support, comments.
    [joprttm.vhd]
2010-04-25 additional constructor in Thread
2010-05-29 rttm: correct comments, remove old files.
    [tag.vhd]
2010-06-11 CMP project for DE2-70 board.
2010-06-15 work on Xilinx ML505 board, remove absolute wait in sc_pack
2010-06-15 CMP version with cache for DE2-70 board.
2010-06-16 jvmhw course: add LEDs and switches to DE2-70 (Christian and Martin)
2010-06-16 fix LED/switsches for DE2-70
    [jop_512x32.vhd, led_switch.vhd, scio_min_DE2-70.vhd]
2010-06-21 xilinx: working on the ML505 board
2010-06-23 xilinx: constraints for ml505 board
2010-06-25 Updated toplevels and memory interface for DE2-70 board.
2010-08-05 Makefile: switch for JDK 1.6 (subset)
2010-08-23 Added Eratosthenes Sieve with CSP. It only prints out the primes on processor 0, but it seems to work fine.
2010-08-24 Corrected a bug for longer than 1-word packets in NoC csp. Added a 2-word packet version for Eratosthenes, in the csp package.
    [Receiver.vhd]
2010-09-09 Synchronization unit with round-robin behavior in the worst case.
2010-10-11 vdhl: resolve conflicting entities between RTTM and caches
    [tm.vhd, tm_tag.vhd]
2010-10-25 common: merged callstrings, callgraph, basicblocks,.. from callstring_wcet branch into common framework, added lots of TODOs
2010-10-27 Fix pipelining after writes.
    [sc_sram32.vhd, sc_sram32_flash.vhd]
2010-10-29 Add missing invalidate signals.
    [decode.vhd, jopcpu.vhd]
2010-12-21 CMP UART: Allow access to UART from all cores.
2011-01-04 ocache: multiple objects; still single field and buggy (Lift works)
    [mem_sc.vhd, ocache.vhd]
2011-01-06 ocache: fix tag update bug
    [ocache.vhd]
2011-01-28 newtools: insert analysis nodes into CFGs only for WCET analysis, fixed bug with mm option, lazy loading of MethodRef to avoid startup problems
2011-01-31 First cut on real locks.
2011-01-31 Making simulation UART compatible to real UART.
2011-02-01 Revert "Merge branch 'master' of ssh://www.soc.tuwien.ac.at/home/git/jop"
    This reverts commit 49846f7715921fc3c321797a7aa6684fa0890997, reversing
    changes made to 4ec890ed59910f5c73f8fdd06b71547d1c576d28.
    [cmpsync.vhd, jopmul_256x16.vhd, jopmul_256x16_cache.vhd, jopmul_512x32.vhd, jopmul_512x32_cache.vhd, jvm.asm, led_switch.vhd]
2011-02-02 DE2: use a PLL clock for the inverted SSRAM clock
    [jop_512x32.vhd, jopmul_512x32.vhd, sc_ssram32.vhd]
2011-02-14 Added NoC Switch for multi-rings.
2011-02-19 Added an open ring for the CSP NoC, also added designs of two rings 4+4 using a NoC switch. The nexys2 version synthesizes. Did not test the altera version, nor tested the nexys2 version on FPGA due 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
2011-03-03 common: removed trace logmessages from output if debug is not enabled
2011-03-25 vhdl: fixed a bug in the memory MUX that popped up on a SPM/NoC/CMP configuration. Hopefully not introduced a new one.
    [jop_config_global.vhd, jopcpu.vhd, sc_arbiter_tdma.vhd]
2011-03-31 newtools: - added some more getters for fields to the framework - refactored code to get referenced classnames from instructions - getting constantpool reference in DFA context from methodinfo direct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
2011-04-03 Test Case for the DFA loop bounds analysis. Should succeed (global loop bound 5), but fails.
2011-04-04 common: using framework methods to resolve constantpool class references, fixes array-references
2011-04-08 vhdl: fix some inconsistencies in the top levels
    [jopmul.vhd, jopmul_512x32.vhd, sc_arbiter_fair.vhd, sc_arbiter_fixedpr.vhd, sc_arbiter_fixedpr_int.vhd, sc_arbiter_rr.vhd, sc_arbiter_tdma.vhd]
2011-04-08 WCETPreprocess: Renaming (only case) issues on mac os x
2011-04-10 cmp: set default frequency to 60 MHz enable a working CMP version from head we should address the fmax issue of the CMP version of JOP
    [jop_config_de2.vhd]
2011-04-14 Update build.xml so it works reasonably with the new tool chain.
2011-04-20 newtools: Add test case for correct resolution of interface methods.
2011-05-05 papabench: Use scopes for threads that allocate memory.
2011-05-06 papabench: Use the actual receiver type as class for PID controller.
2011-05-14 wcet: Fix buggy line number costs (now we only attach the cost for the first WCET calculation of a method to the line numbers in RecursiveWcetAnalysis). This needs to be properly fixed at some point.
2011-05-25 common: High priority bug fix for control flow graph construction. The edge for the default target of a SelectInstruction was missing.
2011-05-26 wcet: test case for assertion errors (may lead to cyclic callgraphs in newtools)
2011-05-27 test: Added test case for ticket #10.
2011-05-27 jcopter: fix to update targets correctly when code is inserted before the invoke
2011-05-27 common: allow filtering of invokesites in callgraph
2011-06-08 wcet-preprocess: Added test case where WcetPreprocess produces code that does not work with plain JVM.
2011-06-08 test: updated JopLookup to current newtools version
2011-06-15 common, jcopter: lots of stubs for greedy inliner, added an interpreter implementation similar to the DFA but without contexts and flowgraph for the stack analysis.
2011-07-23 scj: scope test case
2011-07-26 jopsim: reset statistics on invokation of main
    [sc_sys.vhd]
2011-08-08 test/wcet: Use Config.MEASURE, always print 'max: NUMBER' for the WCET (automated processing)
2011-08-10 wcet: cleanup supergraph a little bit, replacing switch on type tag by dynamic dispatch
2011-08-10 jcopter,wcet: bugfix to provide flow infos for virtual CFG nodes too
2011-08-18 wcet: Cleanup the WCETAnalysis driver a little bit
2011-08-18 wcet: Port O$ analysis to the new framework, cleanup method cache analysis, add an interface for cache persistence analyses, improve quality of ALL_FIT_SIMPLE approximation (maximum cost is now calcu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
2011-08-18 Order Manager: Realistic Numbers. Disabled UART output for the evaluation; the other still unbouneded loops (Float.toString(), Long.toString()) do not influence the object cache.
2011-08-18 Adding class to allow reading of full lines from UART.
2011-08-19 common: add getEntryMethods() to Segment, fix SegmentTest, add indent parameter to MiscUtils.printMap
2011-08-19 wcet: fix object cache evaluation bugs. Object cache evaluation (StartLift) now works in the new global segment analysis framework :)
2011-08-23 wcet,code: During analysis and during supergraph construction, ignore receivers which are infeasible in the current call context. This is helpful if virtual invokes are resolved in a preprocessing st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
2011-09-19 make/xflow synthesis flow with project file and synthesis options for s3sk.
2011-09-19 Extended status output on LEDs by 'design present' and 'serial link activity'.
2011-09-20 jcopter,wcet: log devirtualization stats, bugfix to enable DFA loopbound check for WCA during optimization, do not print stacktraces directly to stdout in WCA event handler
2011-09-20 dfa: skip serialization of outdated flow edges
2011-11-30 hwscope: additional quartus/vhdl files and removed some files no longer needed
    [scio_DE2-70_hwSensors.vhd]
2011-12-29 wcet: fix cache cost calculation for local stratgies (currently only used as metrics)
2012-02-23 jrri: I2C controller for JOP
2012-02-23 jrri: removed unnecessary entities and updated quartus project for I2C
2012-03-23 An example for the i2c controller using the video codec in the de270 board
2012-04-13 example: add AAU mine pump example
2012-06-18 jrri: GomSpace CSP watchdog/examples files, updated I2C controller
2012-07-03 Support for running JOP from DRAM on Altera DE2 board (altde2dram).
2012-08-31 reprap:Improved thread-safety
2012-09-14 reprap:Added temperature measuring
2012-09-17 reprap:Made compatible with Printrun
2012-09-23 reprap:Removed use of switch statements
2012-09-27 scj: Another test case from purdue
2012-09-28 scj: Frame is in its own class/file
2012-11-15 jop: Updated I2C with some requirements from AAU
2012-11-27 scj: A working version of miniCDx benchmark using a cyclic executive. Some other files were updated to include the initialize() method of the Saflet class according to JSR-302 v.0.90
2013-05-27 scj: Added libcsp files from Aalborg with some changes to make I2C work
2014-03-07 jophwlocks: Fixed merge errors
    [jopmul_512x32.vhd]
