jop-devel/jop/(notices)

Notices in the files:
ext/spimaster/ctrlStsRegBI.v:
Copyright (C) 2008 Steve Fielding and OPENCORES.ORG
Public License along with this source; if not, download it
from <http://www.opencores.org/lgpl.shtml>
ext/ac97/ac97_top.v:
Copyright (C) 2000-2002 Rudolf Usselmann
